hprd/z80-fpga-drop-in-replacement/README.md

# z80-fpga-drop-in-replacement
UT Austin Fall 2025-Spring 2026 Senior Design Project for developing a Zilog Z80 CPU drop-in replacement using an FPGA.

Relevant links and information from previous group's iteration:
- [Instruction Set](https://map.grauw.nl/resources/z80instr.php)
- [Z80 User Manual](https://www.zilog.com/docs/z80/um0080.pdf)
- [Master Reference Website](http://z80.info/)
- [Timing Quirks](https://floooh.github.io/2021/12/06/z80-instruction-timing.html#extra-clock-cycles)
