hprd/z80-fpga-drop-in-replacement/Z80_Drop_In_2026/Z80_Drop_In_2026.runs/impl_1/.init_design.begin.rst

<?xml version="1.0"?>
<ProcessHandle Version="1" Minor="0">
    <Process Command=".planAhead." Owner="user" Host="de310536375a" Pid="17683">
    </Process>
</ProcessHandle>
