hprd/z80-fpga-drop-in-replacement/Z80_Drop_In_2026/Z80_Drop_In_2026.runs/blk_mem_gen_0_synth_1/.vivado.begin.rst

<?xml version="1.0"?>
<ProcessHandle Version="1" Minor="0">
    <Process Command="vivado" Owner="user" Host="ff1013d0903a" Pid="958" HostCore="5" HostMemory="2987652">
    </Process>
</ProcessHandle>
