hprd/z80-fpga-drop-in-replacement/Z80_Drop_In_2026/Z80_Drop_In_2026.runs/impl_1/.write_bitstream.begin.rst

<?xml version="1.0"?>
<ProcessHandle Version="1" Minor="0">
    <Process Command=".planAhead." Owner="user" Host="4831159a8b64" Pid="1235">
    </Process>
</ProcessHandle>
