hprd/z80-fpga-drop-in-replacement/hardware/TC2030-IDC-NL.step

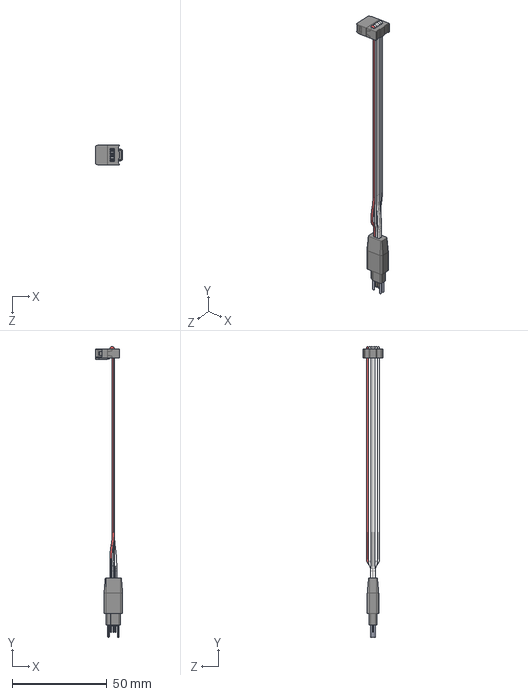
[picture p1: CAD file, 2026-02-06]
hardware/TC2030-IDC-NL.step
14.5 x 153.6 x 10.7 mm
