hprd/z80-fpga-drop-in-replacement/TesterBoard/Tester_Board_PCB_Parts/ACH_4_000MHZ_EK/ACH-4.000MHZ-EK.step

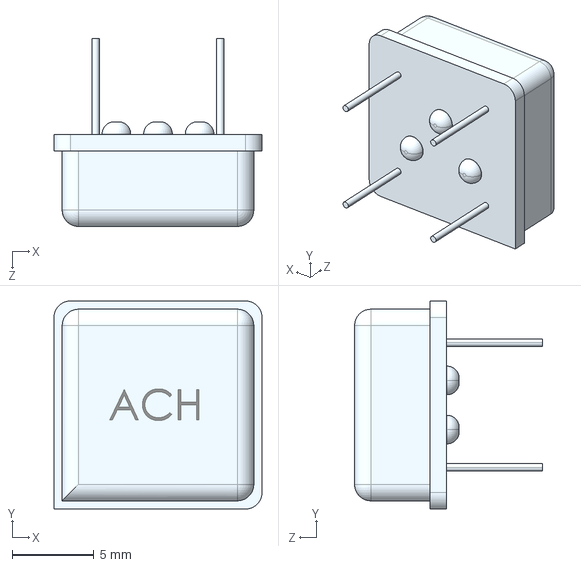
[picture p2: CAD file, 2026-03-05]
TesterBoard/Tester_Board_PCB_Parts/ACH_4_000MHZ_EK/ACH-4.000MHZ-EK.step
12.7 x 12.7 x 11.5 mm
