hprd/z80-fpga-drop-in-replacement/TesterBoard/Tester_Board_PCB_Parts/B3F-4050/B3F-4050.step

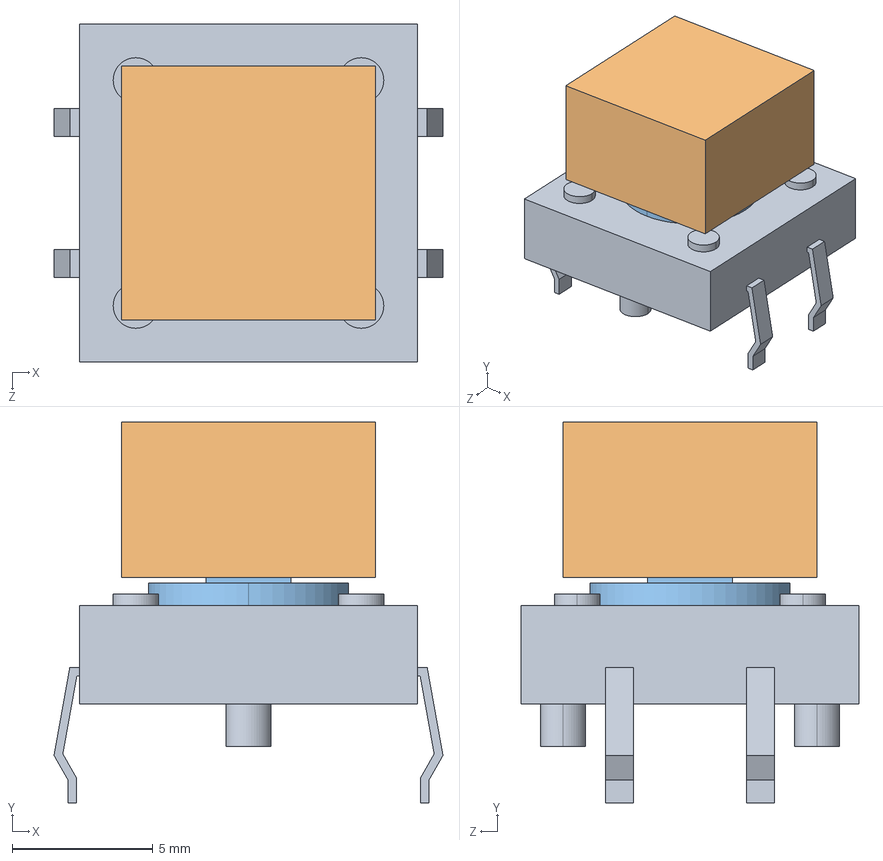
[picture p3: CAD file, 2026-03-07]
TesterBoard/Tester_Board_PCB_Parts/B3F-4050/B3F-4050.step
13.8 x 13.5 x 12.0 mm
B3F_4050_BASE
B32_1200
B3F_4050_BUTTON
