hprd/z80-fpga-drop-in-replacement/TesterBoard/Tester_Board_PCB_Parts/LCD-16X2/LCD-16X2.step

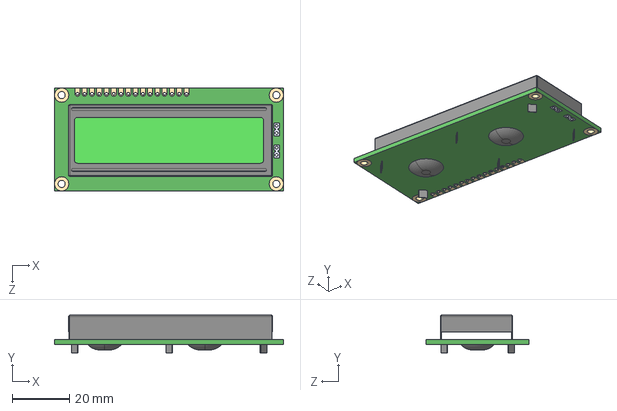
[picture p4: CAD file, 2026-03-07]
TesterBoard/Tester_Board_PCB_Parts/LCD-16X2/LCD-16X2.step
80.0 x 13.2 x 36.0 mm
