hprd/z80-fpga-drop-in-replacement/TesterBoard/Tester_Board_PCB_Parts/LIB_NHD-12864WG-BTMI-V#N/NHD-12864WG-BTMI-V#N/3D/NHD-12864WG-BTMI-V#N.stp

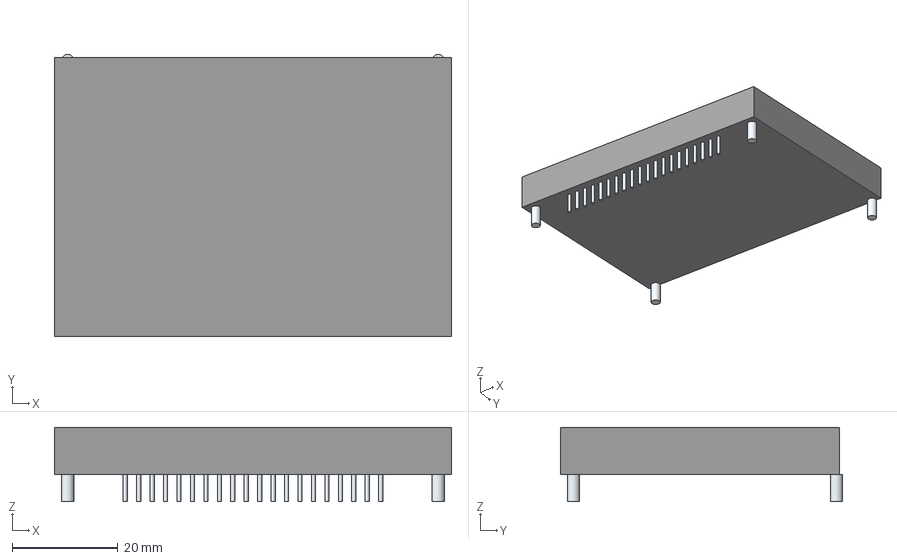
[picture p5: CAD file, 2026-03-07]
TesterBoard/Tester_Board_PCB_Parts/LIB_NHD-12864WG-BTMI-V#N/NHD-12864WG-BTMI-V#N/3D/NHD-12864WG-BTMI-V#N.stp
75.0 x 53.3 x 14.0 mm
Leads
