hprd/z80-fpga-drop-in-replacement/TesterBoard/Tester_Board_PCB_Parts/PJ_102A/PJ-102A.step

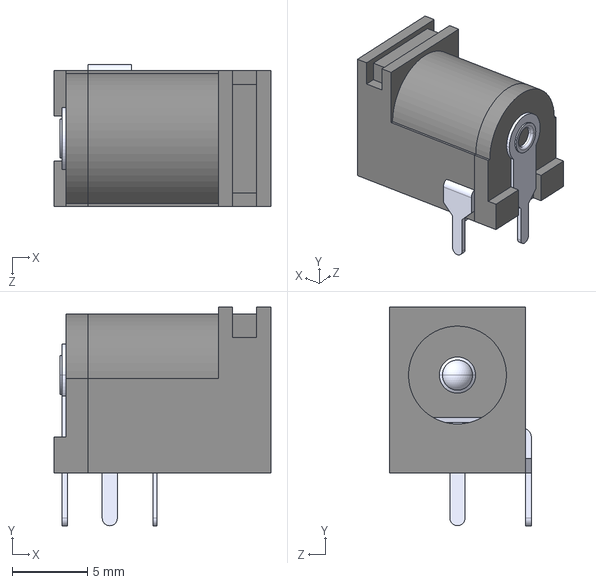
[picture p6: CAD file, 2026-03-07]
TesterBoard/Tester_Board_PCB_Parts/PJ_102A/PJ-102A.step
14.4 x 14.5 x 9.40 mm
