hprd/z80-fpga-drop-in-replacement/TesterBoard/Tester_Board_PCB_Parts/Potentiometer_3D.STEP

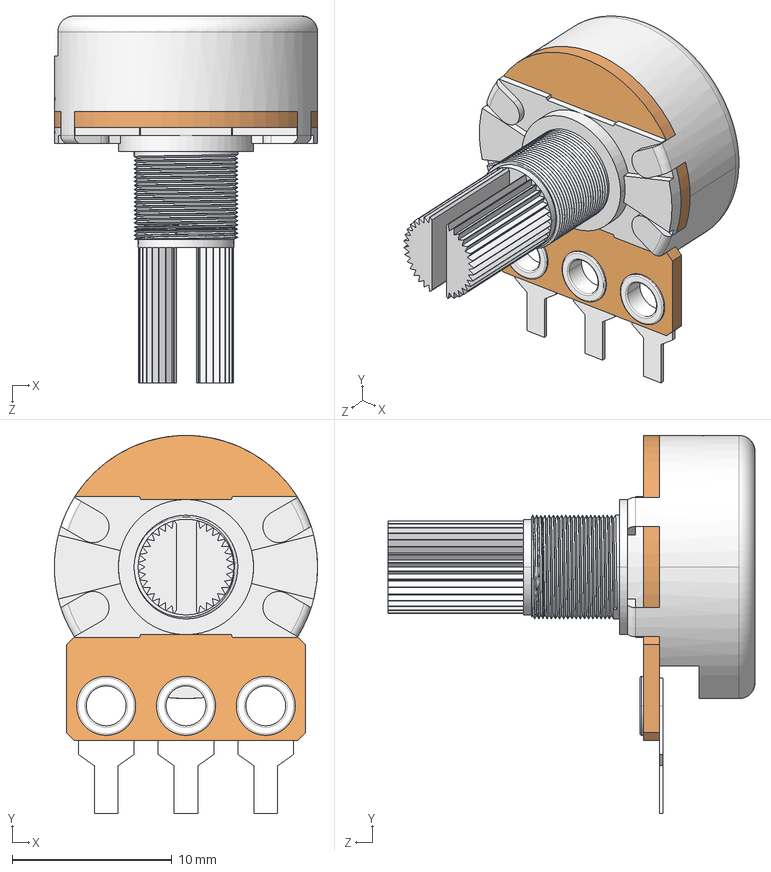
[picture p7: CAD file, 2026-03-09]
TesterBoard/Tester_Board_PCB_Parts/Potentiometer_3D.STEP
16.5 x 23.7 x 23.0 mm
