hprd/z80-fpga-drop-in-replacement/TesterBoard/Tester_Board_PCB_Parts/SN74LS14N/SN74LS14N.step

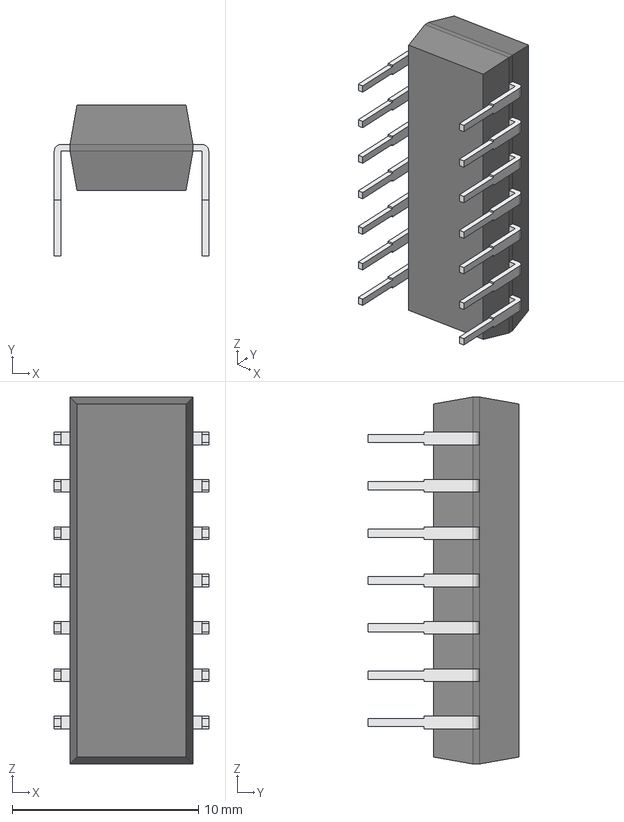
[picture p8: CAD file, 2026-03-05]
TesterBoard/Tester_Board_PCB_Parts/SN74LS14N/SN74LS14N.step
8.29 x 8.08 x 19.7 mm
Body001 (Mirror #1) x 8
