hprd/z80-fpga-drop-in-replacement/TesterBoard/Tester_Board_PCB_Parts/32pin_ZIF_3D.stp

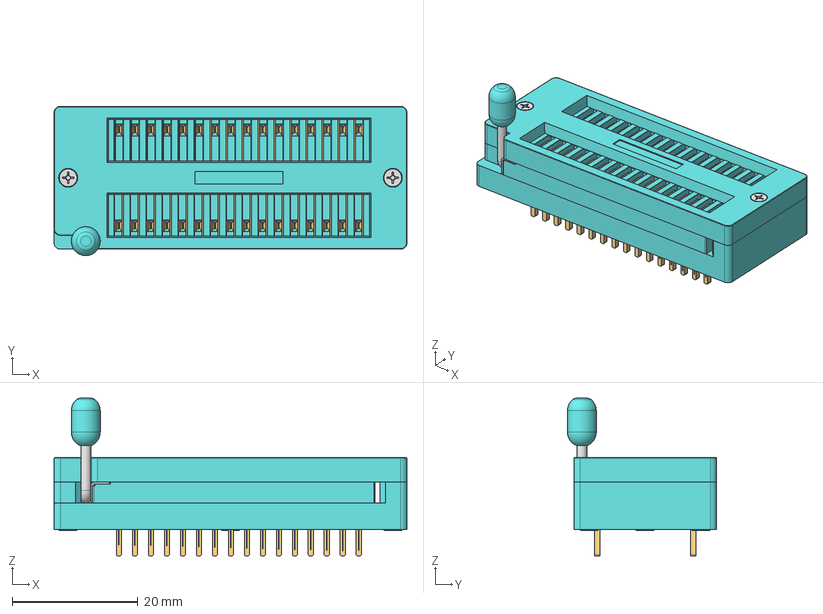
[picture p9: CAD file, 2026-03-09]
TesterBoard/Tester_Board_PCB_Parts/32pin_ZIF_3D.stp
56.1 x 23.7 x 25.1 mm
ZIF_32uni_bottom
ZIF_32uni_middle_body
ZIF_wide_middle_shield
ZIF_32uni_top
ZIF_handle_wide
ZIF_socket_handle_head
ZIF_socket_pin_uni x 32
M1.6-L8 x 2
