hprd/z80-fpga-drop-in-replacement/hardware/XC7S25-2CSGA225I.stp

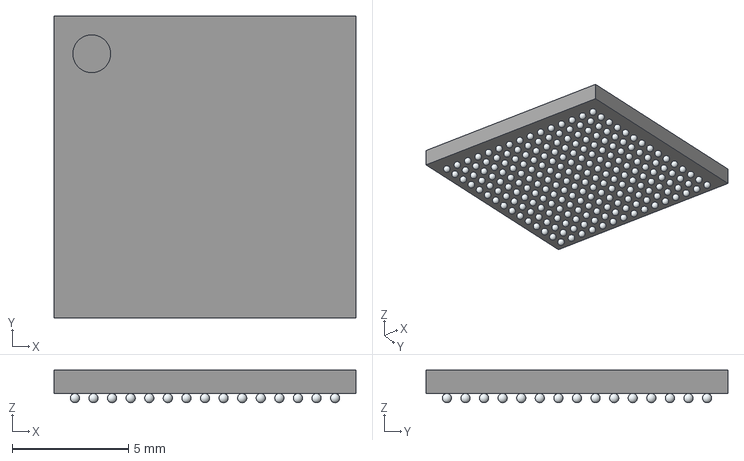
[picture p10: CAD file, 2026-02-06]
hardware/XC7S25-2CSGA225I.stp
13.0 x 13.0 x 1.40 mm
