hprd/z80-fpga-drop-in-replacement/TesterBoard/Tester_Board_PCB_Parts/40pin_ZIF_3D.STEP

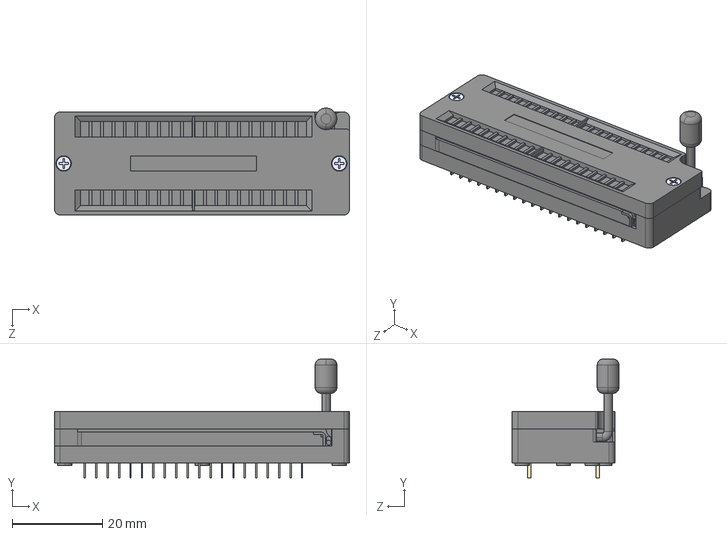
[picture p11: CAD file, 2026-03-09]
TesterBoard/Tester_Board_PCB_Parts/40pin_ZIF_3D.STEP
65.5 x 26.4 x 23.7 mm
