hprd/z80-fpga-drop-in-replacement/hardware/LTC3569EUDC#TRPBF.stp

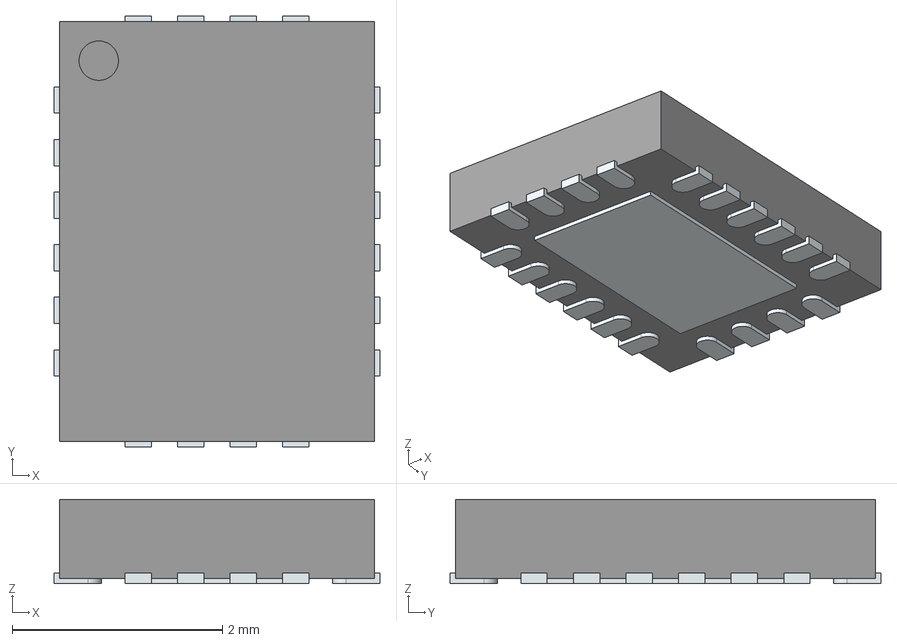
[picture p12: CAD file, 2026-02-06]
hardware/LTC3569EUDC#TRPBF.stp
3.10 x 4.10 x 0.8 mm
ThermalPin
PinsArrayLR
PinsArrayTB
