hprd/z80-fpga-drop-in-replacement/hardware/EVQ-P2R02W.stp

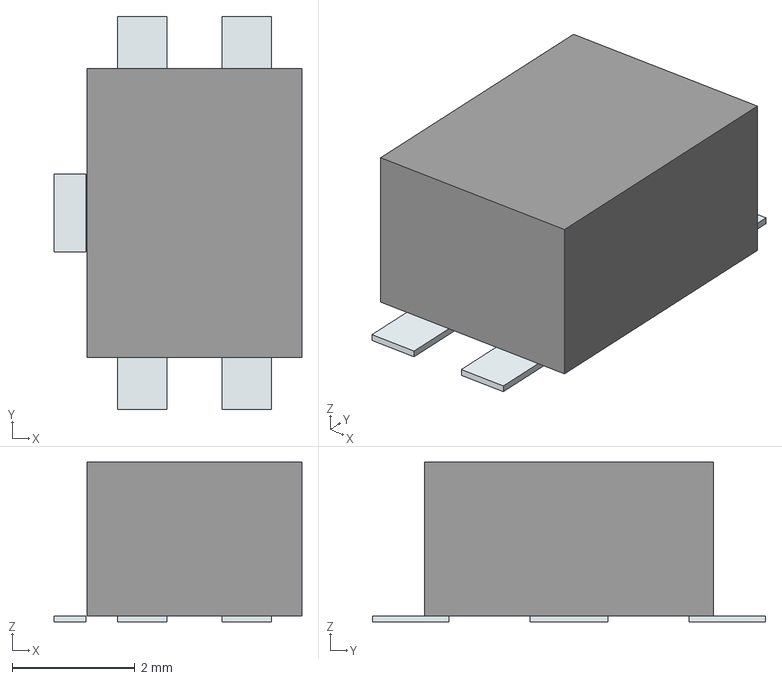
[picture p13: CAD file, 2026-02-06]
hardware/EVQ-P2R02W.stp
4.04 x 6.40 x 2.60 mm
Pins
