hprd/z80-fpga-drop-in-replacement/hardware/MT25QL512ABB1EW9-0SIT.stp

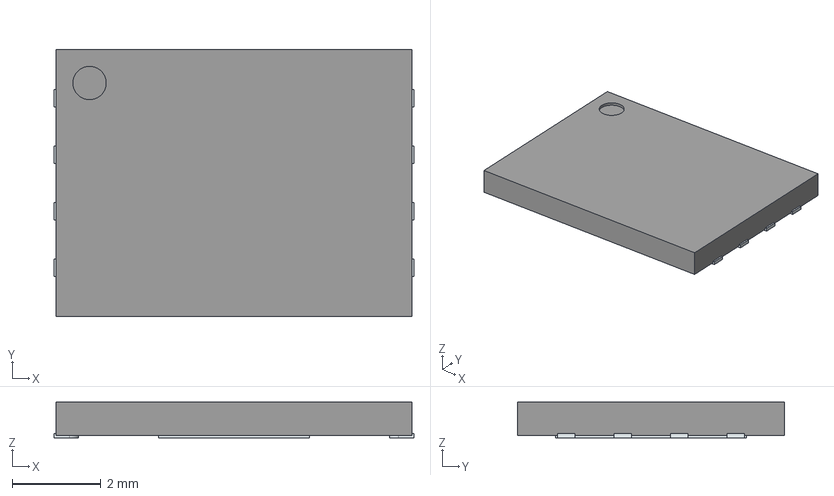
[picture p14: CAD file, 2026-02-06]
hardware/MT25QL512ABB1EW9-0SIT.stp
8.10 x 6.00 x 0.8 mm
ThermalPin
PinsArrayLR
