hprd/z80-fpga-drop-in-replacement/hardware/416131160803.stp

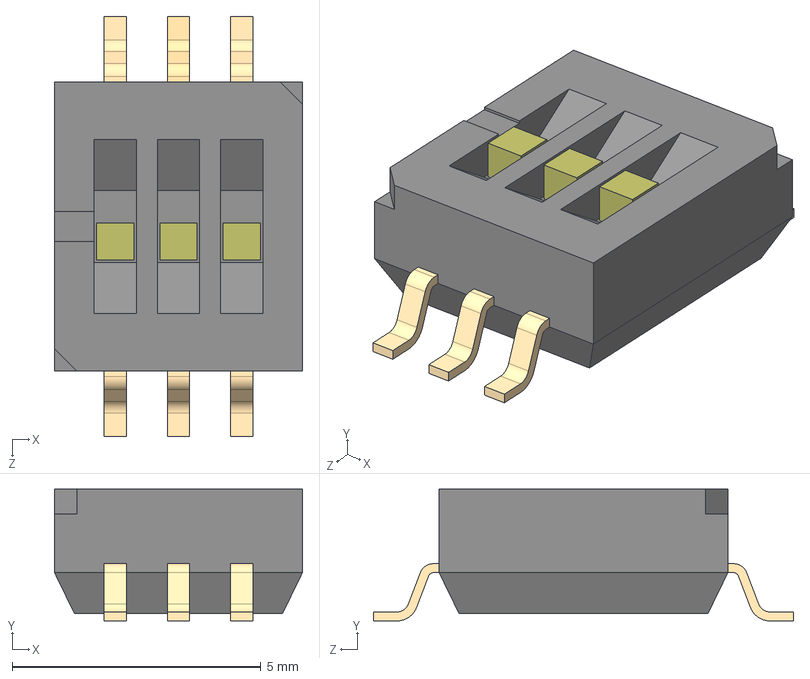
[picture p15: CAD file, 2026-02-06]
hardware/416131160803.stp
4.98 x 2.65 x 8.44 mm
