hprd/z80-fpga-drop-in-replacement/(list of files, cad)

Other CAD files:
TesterBoard/Tester_Board_PCB_Parts/LIB_NHD-12864WG-BTMI-V#N/NHD-12864WG-BTMI-V#N/Allegro/nhd12864wgbtmivn.psm
TesterBoard/Tester_Board_PCB_Parts/LIB_NHD-12864WG-BTMI-V#N/NHD-12864WG-BTMI-V#N/DEHDL/nhd_12864wg_btmi_v#n/chips/chips.prt
