hprd/z80-fpga-drop-in-replacement/(list of files, drawings)

Other design files:
hardware/level-shifter/freerouting.dsn
TesterBoard/Tester_Board_PCB_Parts/LIB_NHD-12864WG-BTMI-V#N/NHD-12864WG-BTMI-V#N/Altium/NHD12864WGBTMIVN.PcbLib
TesterBoard/Tester_Board_PCB_Parts/LIB_NHD-12864WG-BTMI-V#N/NHD-12864WG-BTMI-V#N/Altium/NHD-12864WG-BTMI-V#N.SchLib
