hprd/z80-fpga-drop-in-replacement/TesterBoard/Tester/Tester.kicad_pcb

## KiCad design TesterBoard/Tester/Tester.kicad_pcb (2026-03-28)

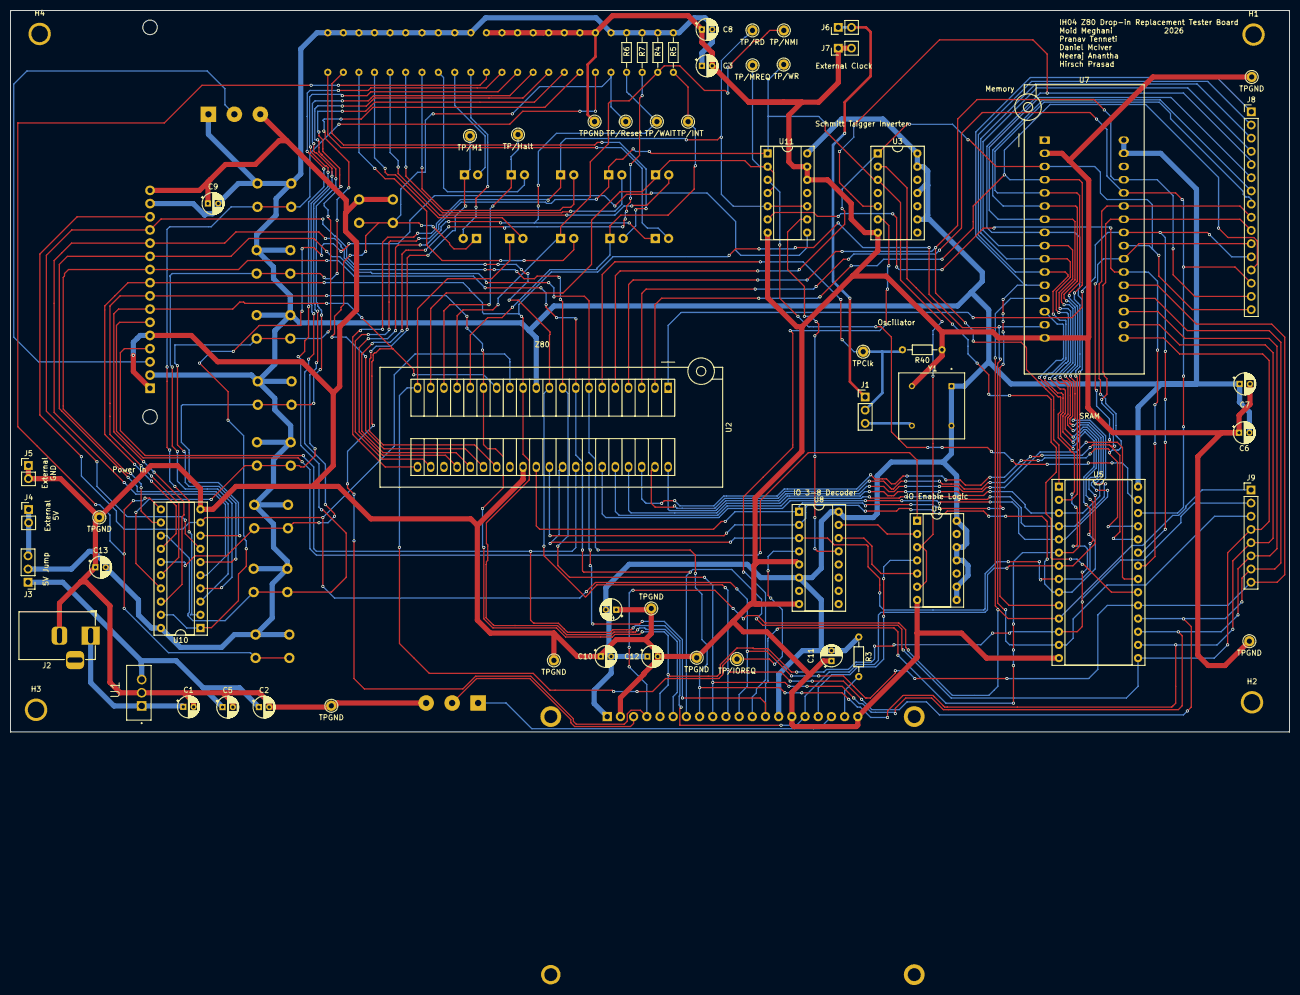
[picture p16: board Tester.kicad_pcb from above]

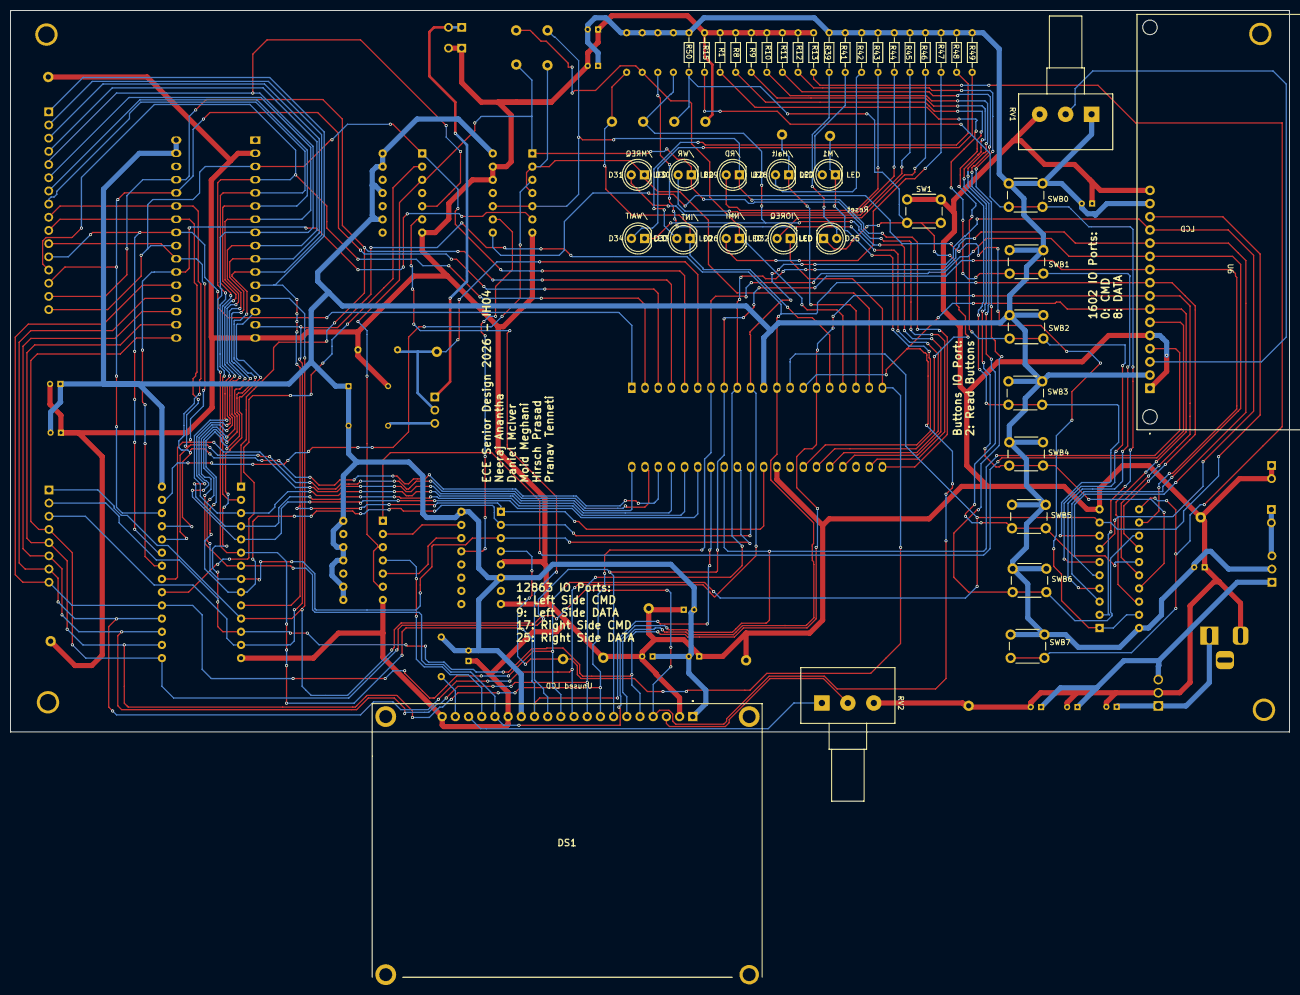
[picture p17: board Tester.kicad_pcb from below]

Board: 2 copper layers, 246.3 x 138.9 mm, 103 parts (42 on the bottom side), 75 nets.

Parts:
C1: 330nF; CP_Radial_D4.0mm_P2.00mm
C2, C3, C4, C6, C7, C8, C9, C10, C11, C12, C13: 100nF; CP_Radial_D4.0mm_P2.00mm
C5: 10uF; CP_Radial_D4.0mm_P2.00mm
D25, D26, D27, D28, D29, D30, D31, D32, D33, D34: LED; LED_D5.0mm
DS1: NHD-12864WG-BTMI-V#N; NHD12864WGBTMIVN
H1, H2, H3, H4: MountingHole_4_40
J1, J3: Conn_01x03_Pin; PinHeader_1x03_P2.54mm_Vertical
J2: PJ-102A; BarrelJack_Horizontal
J4, J5, J6, J7: Conn_01x02_Pin; PinHeader_1x02_P2.54mm_Vertical
J8: Conn_01x16_Pin; PinHeader_1x16_P2.54mm_Vertical
J9: Conn_01x08_Pin; PinHeader_1x08_P2.54mm_Vertical
R1, R8, R9, R10, R11, R12, R13, R15: 1k; R_Axial_DIN0204_L3.6mm_D1.6mm_P7.62mm_Horizontal
R3, R39, R40, R41, R42, R43, R44, R45, R46, R47, R48, R49, R50: 1K; R_Axial_DIN0204_L3.6mm_D1.6mm_P7.62mm_Horizontal
R4, R5, R6, R7: 10K; R_Axial_DIN0204_L3.6mm_D1.6mm_P7.62mm_Horizontal
RV1, RV2: R_Potentiometer; Potentiometer_Alps_RK163_Single_Horizontal
SW1: SW_Push; SW_PUSH_6mm
SWB0, SWB1, SWB2, SWB3, SWB4, SWB5, SWB6, SWB7: SW_Push; SW_PUSH_6mm
TP/Halt: TestPoint; Pin_D1.0mm_L10.0mm
TP/INT: TestPoint; Pin_D1.0mm_L10.0mm
TP/IOREQ: TestPoint; Pin_D1.0mm_L10.0mm
TP/M1: TestPoint; Pin_D1.0mm_L10.0mm
TP/MREQ: TestPoint; Pin_D1.0mm_L10.0mm
TP/NMI: TestPoint; Pin_D1.0mm_L10.0mm
TP/RD: TestPoint; Pin_D1.0mm_L10.0mm
TP/Reset: TestPoint; Pin_D1.0mm_L10.0mm
TP/WAIT: TestPoint; Pin_D1.0mm_L10.0mm
TP/WR: TestPoint; Pin_D1.0mm_L10.0mm
TPClk: TestPoint; Pin_D1.0mm_L10.0mm
TPGND: TestPoint; Pin_D1.0mm_L10.0mm
TPGND#2, TPGND#3, TPGND#4, TPGND#5, TPGND#6, TPGND#7, TPGND#8: TestPoint; Pin_D1.0mm_L10.0mm
U1: L7805; TO254P1054X470X2600-3
U2: Z80CPU; 3M_Textool_240-1288-00-0602J_2x20_P2.54mm
U3: 74LS14; DIP-14_W7.62mm_Socket
U4: 74LS02; DIP-14_W7.62mm_Socket
U5: CY62256-70PC; DIP-28_W15.24mm_Socket
U6: LCD-16X2; MODULE_LCD-16X2
U7: SST39SF010; DIP_Socket-32_W11.9_W12.7_W15.24_W17.78_W18.5_3M_232-1285-0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
U8: 74HC138; DIP-16_W7.62mm_Socket
U10: 74HC244; DIP-20_W7.62mm_Socket
U11: 74LS32; DIP-14_W7.62mm_Socket
Y1: ACH-4.000MHZ-EK; XTAL_ACH-4.000MHZ-EK

Connections:
1602_Enable: U4.1, U6.6 (E)
12864_Enable: DS1.17 (E), U4.4
12864_VEE: DS1.18 (VEE), RV2.1
+5V: C3.1, C4.2, C6.2, C7.1, C8.2, C9.2, C10.2, C11.2, C12.1, C13.2, DS1.1 (VDD), DS1.14 (~RST), J3.2, R3.1, R4.1, R5.2, R6.1, R7.1, R39.1, R41.1, R42.1, R43.1, R44.1, R45.1, R46.1, R47.1, R48.1, R49.1, R50.1, RV1.1, SWB0.1, SWB1.1, SWB2.1, SWB3.1, SWB4.1, SWB5.1, SWB6.1, SWB7.1, U2.11 (VCC), U3.9, U3.11, U3.13, U3.14 (VCC), U4.8, U4.9, U4.11, U4.12, U4.14 (VCC), U5.28 (VCC), U6.2 (VDD), U6.15 (A), U7.31 (PGM), U7.32 (VCC), U8.6 (E2), U8.16 (VCC), U10.20 (VCC), U11.14 (VCC), Y1.1 (TRI-STATE/NC), Y1.8 (VDD)
+9V: C1.1, J2.1, U1.1 (IN)
Address0: J8.1, U2.30 (A0), U5.10 (A0), U7.12 (A0), U8.1 (A0)
Address1: J8.2, U2.31 (A1), U5.9 (A1), U7.11 (A1), U8.2 (A1)
Address2: J8.3, U2.32 (A2), U5.8 (A2), U7.10 (A2), U8.3 (A2)
Address3: DS1.16 (D/~I), J8.4, U2.33 (A3), U5.7 (A3), U6.4 (RS), U7.9 (A3)
Address4: DS1.13 (CS2), J8.5, U2.34 (A4), U3.5, U5.6 (A4), U7.8 (A4)
Address5: J8.6, U2.35 (A5), U5.5 (A5), U7.7 (A5)
Address6: J8.7, U2.36 (A6), U5.4 (A6), U7.6 (A6)
Address7: J8.8, U2.37 (A7), U5.3 (A7), U7.5 (A7)
Address8: J8.9, U2.38 (A8), U5.25 (A8), U7.27 (A8)
Address9: J8.10, U2.39 (A9), U5.24 (A9), U7.26 (A9)
Address10: J8.11, U2.40 (A10), U5.21 (A10), U7.23 (A10)
Address11: J8.12, U2.1 (A11), U5.23 (A11), U7.25 (A11)
Address12: J8.13, U2.2 (A12), U5.2 (A12), U7.4 (A12)
Address13: J8.14, U2.3 (A13), U5.26 (A13), U7.28 (A13)
Address14: J8.15, U2.4 (A14), U5.1 (A14), U7.29 (A14)
Address15: J8.16, U2.5 (A15), U3.1, U7.3 (A15), U7.24 (OE)
B0: R15.2, SWB0.2, U10.2 (1A0)
B1: R1.2, SWB1.2, U10.4 (1A1)
B2: R8.2, SWB2.2, U10.6 (1A2)
B3: R9.2, SWB3.2, U10.8 (1A3)
B4: R10.2, SWB4.2, U10.17 (2A0)
B5: R11.2, SWB5.2, U10.15 (2A1)
B6: R12.2, SWB6.2, U10.13 (2A2)
B7: R13.2, SWB7.2, U10.11 (2A3)
Barrel_5V: C2.1, C5.1, J3.1, U1.3 (OUT)
Clk: J1.2, R40.2, TPClk.1, U2.6 (~CLK)
Data0: DS1.4 (DB0), J9.1, U2.14 (D0), U5.11 (Q0), U6.7 (DB0), U7.13 (D0), U10.18 (1Y0)
Data1: DS1.5 (DB1), J9.2, U2.15 (D1), U5.12 (Q1), U6.8 (DB1), U7.14 (D1), U10.16 (1Y1)
Data2: DS1.6 (DB2), J9.3, U2.12 (D2), U5.13 (Q2), U6.9 (DB2), U7.15 (D2), U10.14 (1Y2)
Data3: DS1.7 (DB3), J9.4, U2.8 (D3), U5.15 (Q3), U6.10 (DB3), U7.17 (D3), U10.12 (1Y3)
Data4: DS1.8 (DB4), J9.5, U2.7 (D4), U5.16 (Q4), U6.11 (DB4), U7.18 (D4), U10.3 (2Y0)
Data5: DS1.9 (DB5), J9.6, U2.9 (D5), U5.17 (Q5), U6.12 (DB5), U7.19 (D5), U10.5 (2Y1)
Data6: DS1.10 (DB6), J9.7, U2.10 (D6), U5.18 (Q6), U6.13 (DB6), U7.20 (D6), U10.7 (2Y2)
Data7: DS1.11 (DB7), J9.8, U2.13 (D7), U5.19 (Q7), U6.14 (DB7), U7.21 (D7), U10.9 (2Y3)
EXTERNAL_CLOCK: J1.1, J6.1, J6.2
Ext_5V: J3.3, J4.1, J4.2
GND: C1.2, C2.2, C3.2, C4.1, C5.2, C6.1, C7.2, C8.1, C9.1, C10.1, C11.1, C12.2, C13.1, DS1.2 (VSS), DS1.15 (R/~W), DS1.20 (K), J2.2, J5.1, J5.2, J7.1, J7.2, R1.1, R8.1, R9.1, R10.1, R11.1, R12.1, R13.1, R15.1, R40.1, RV1.3, RV2.3, SW1.1, TPGND.1, TPGND#2.1, TPGND#3.1, TPGND#4.1, TPGND#5.1, TPGND#6.1, TPGND#7.1, TPGND#8.1, U1.2 (GND), U2.29 (GND), U3.7 (GND), U4.7 (GND), U5.14 (GND), U6.1 (VSS), U6.5 (R/W), U6.16 (K), U7.2 (A16), U7.16 (GND), U8.5 (~E1), U8.8 (GND), U10.10 (GND), U11.7 (GND), U11.12, U11.13, Y1.4 (CASE_GND)
unnamed: D25.2 (A), R39.2
unnamed: D26.2 (A), R47.2
unnamed: D27.2 (A), R41.2
unnamed: D28.2 (A), R42.2
unnamed: D29.2 (A), R43.2
unnamed: D30.2 (A), R44.2
unnamed: D31.2 (A), R45.2
unnamed: D32.2 (A), R46.2
unnamed: D33.2 (A), R48.2
unnamed: D34.2 (A), R49.2
unnamed: DS1.19 (A), R3.2
unnamed: DS1.3 (V0), RV2.2
unnamed: R7.2, U2.25 (~BUSRQ)
unnamed: U3.2, U5.20 (~CS)
unnamed: U5.22 (~OE), U7.22 (CE), U11.6
unnamed: U5.27 (~WE), U11.3
unnamed: RV1.2, U6.3 (VO)
OSC_CLOCK: J1.3, Y1.5 (OUTPUT)
/1602_Select: U4.2, U8.15 (~Y0)
/12864_Select: U4.5, U8.14 (~Y1)
/Address4: DS1.12 (CS1), U3.6
/Buttons_Enable: U10.1 (1OE), U10.19 (2OE), U11.8
/Buttons_Select: U8.13 (~Y2), U11.9
/Halt: D28.1 (K), TP/Halt.1, U2.18 (~HALT)
/INT: D33.1 (K), R5.1, TP/INT.1, U2.16 (~INT)
/IOREQ: D32.1 (K), TP/IOREQ.1, U2.20 (~IORQ), U8.4 (~E0)
/M1: D27.1 (K), TP/M1.1, U2.27 (~M1)
/MREQ: D31.1 (K), TP/MREQ.1, U2.19 (~MREQ), U11.2, U11.4
/NMI: D26.1 (K), R4.2, TP/NMI.1, U2.17 (~NMI)
/RD: D29.1 (K), TP/RD.1, U2.21 (~RD), U11.5, U11.10
/Reset: D25.1 (K), R50.2, SW1.2, TP/Reset.1, U2.26 (~RESET)
/WAIT: D34.1 (K), R6.2, TP/WAIT.1, U2.24 (~WAIT)
/WR: D30.1 (K), TP/WR.1, U2.22 (~WR), U3.3, U4.3, U4.6, U11.1
