hprd/z80-fpga-drop-in-replacement/hardware/level-shifter/level-shifter.kicad_pcb

## KiCad design hardware/level-shifter/level-shifter.kicad_pcb (2026-03-05)

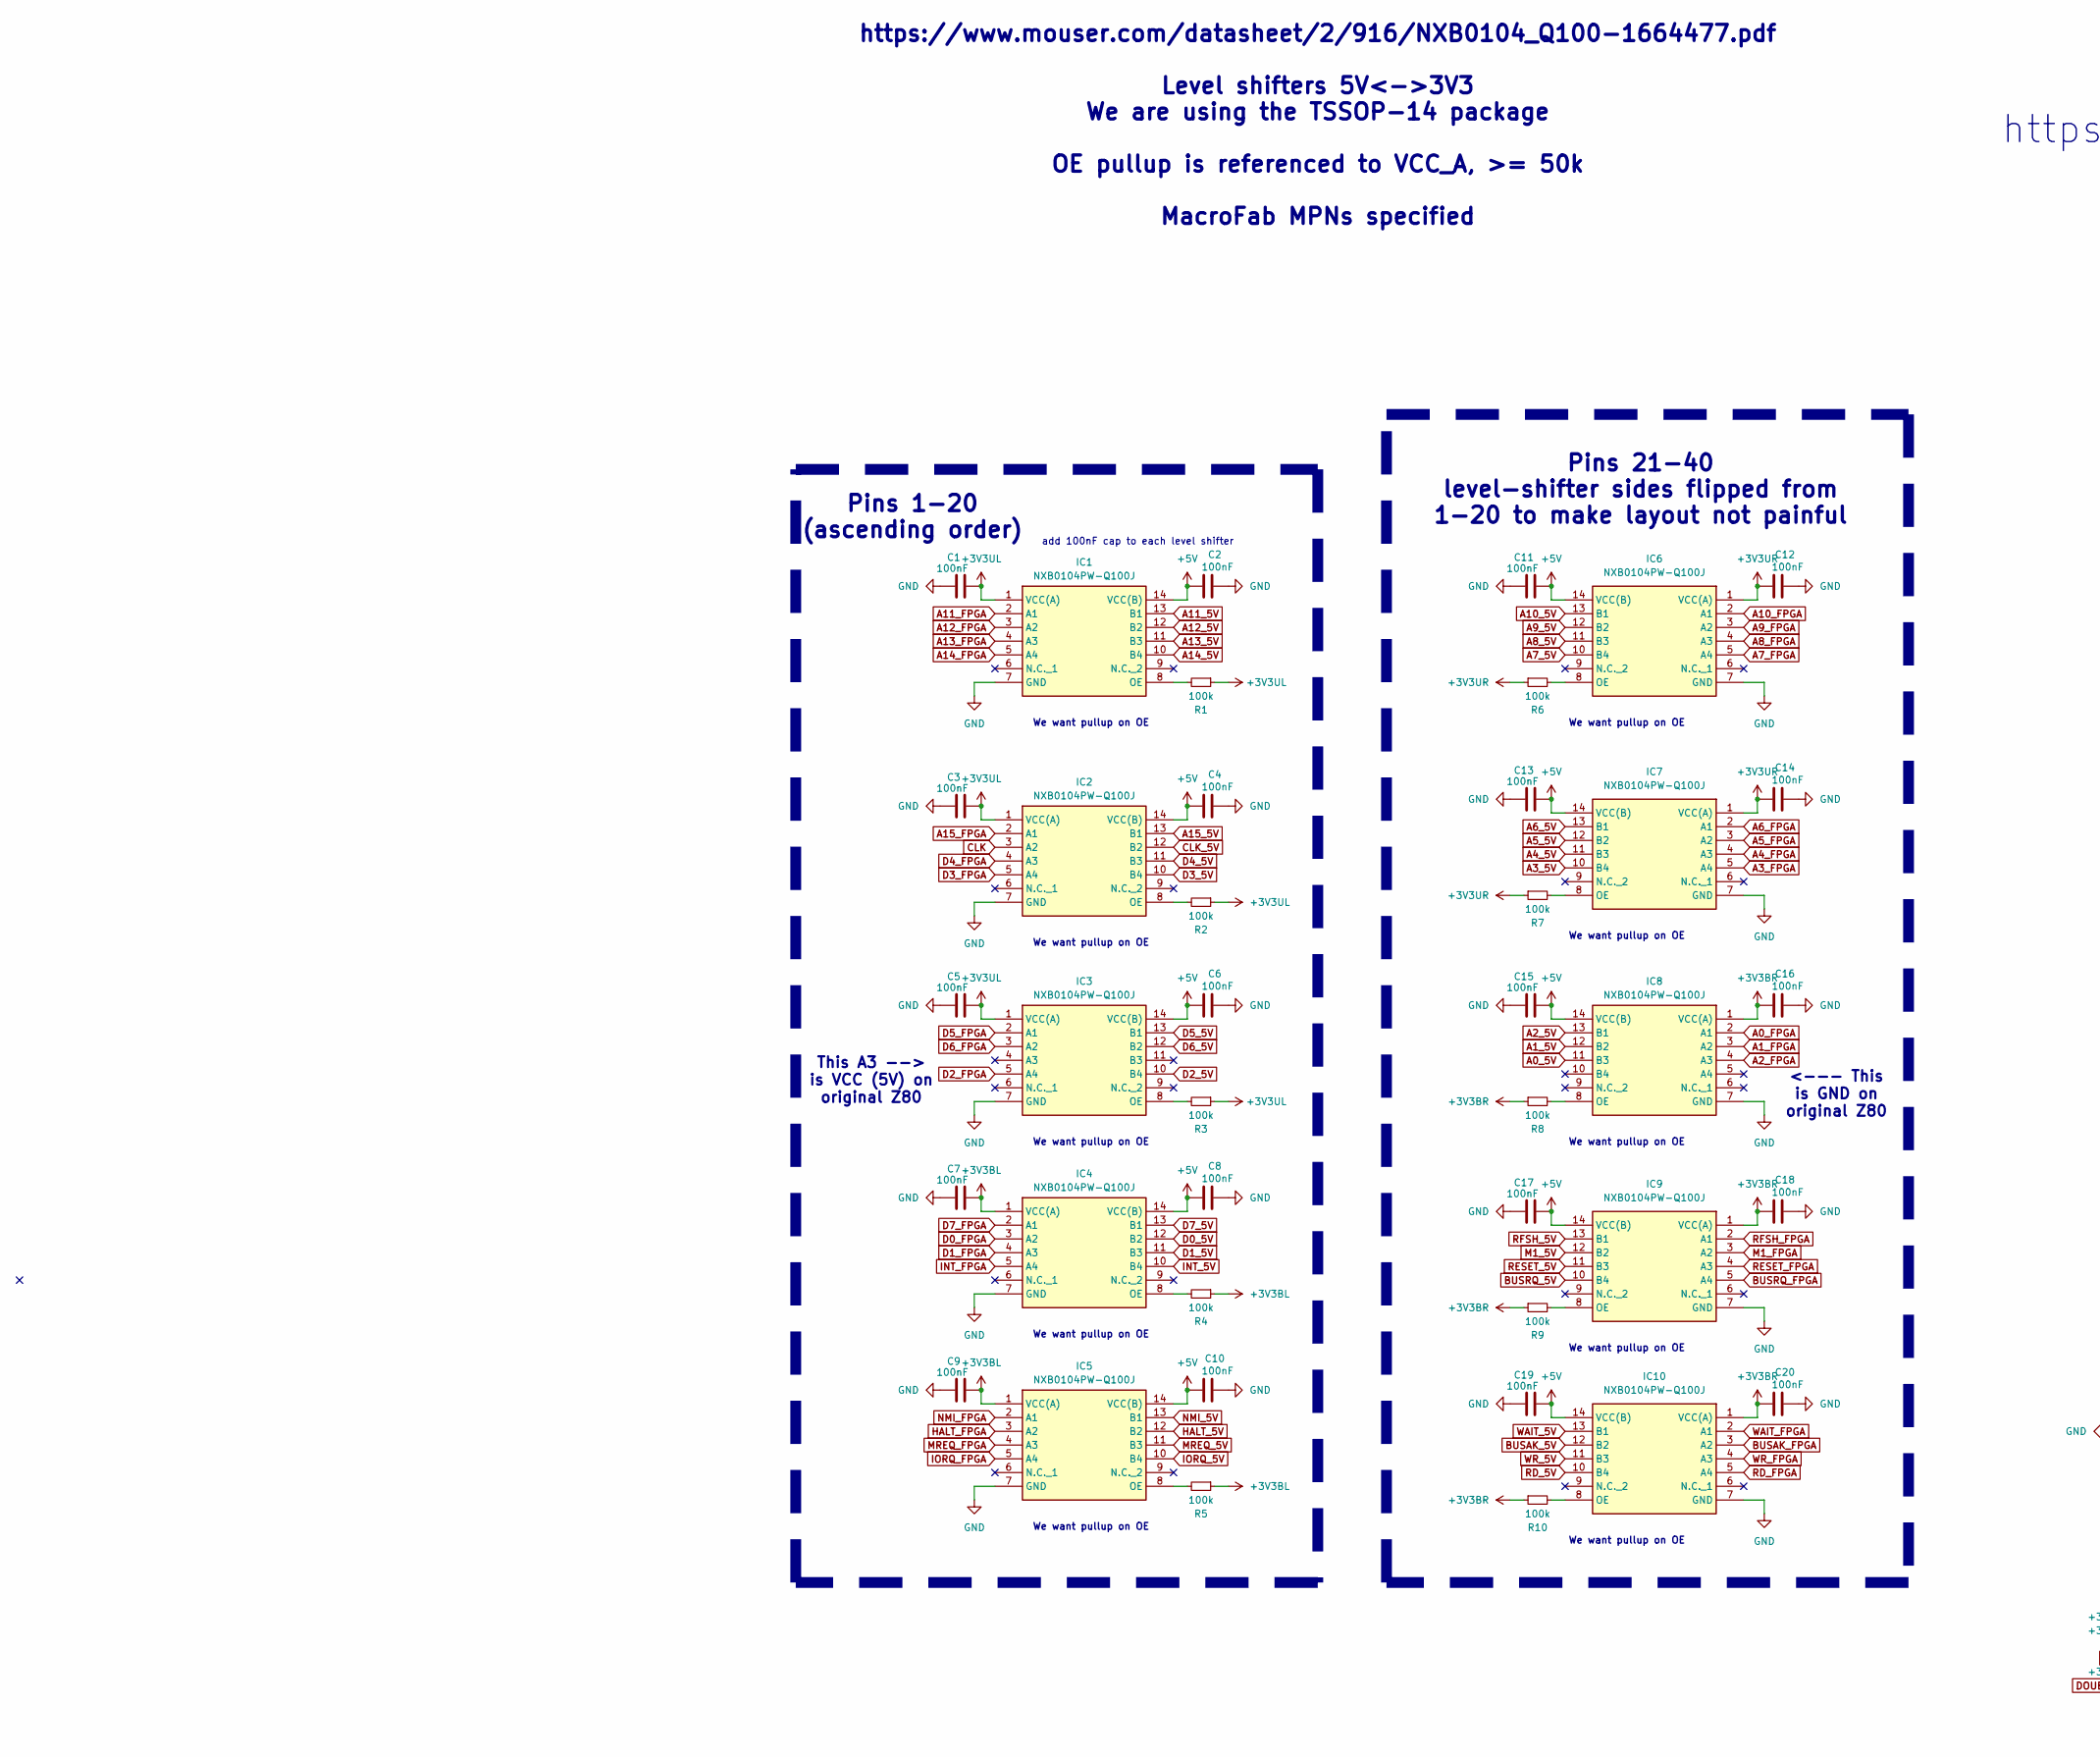
[picture p18: schematic level-shifter.kicad_sch, Z80 FPGA Board, part in row 1, column 1]

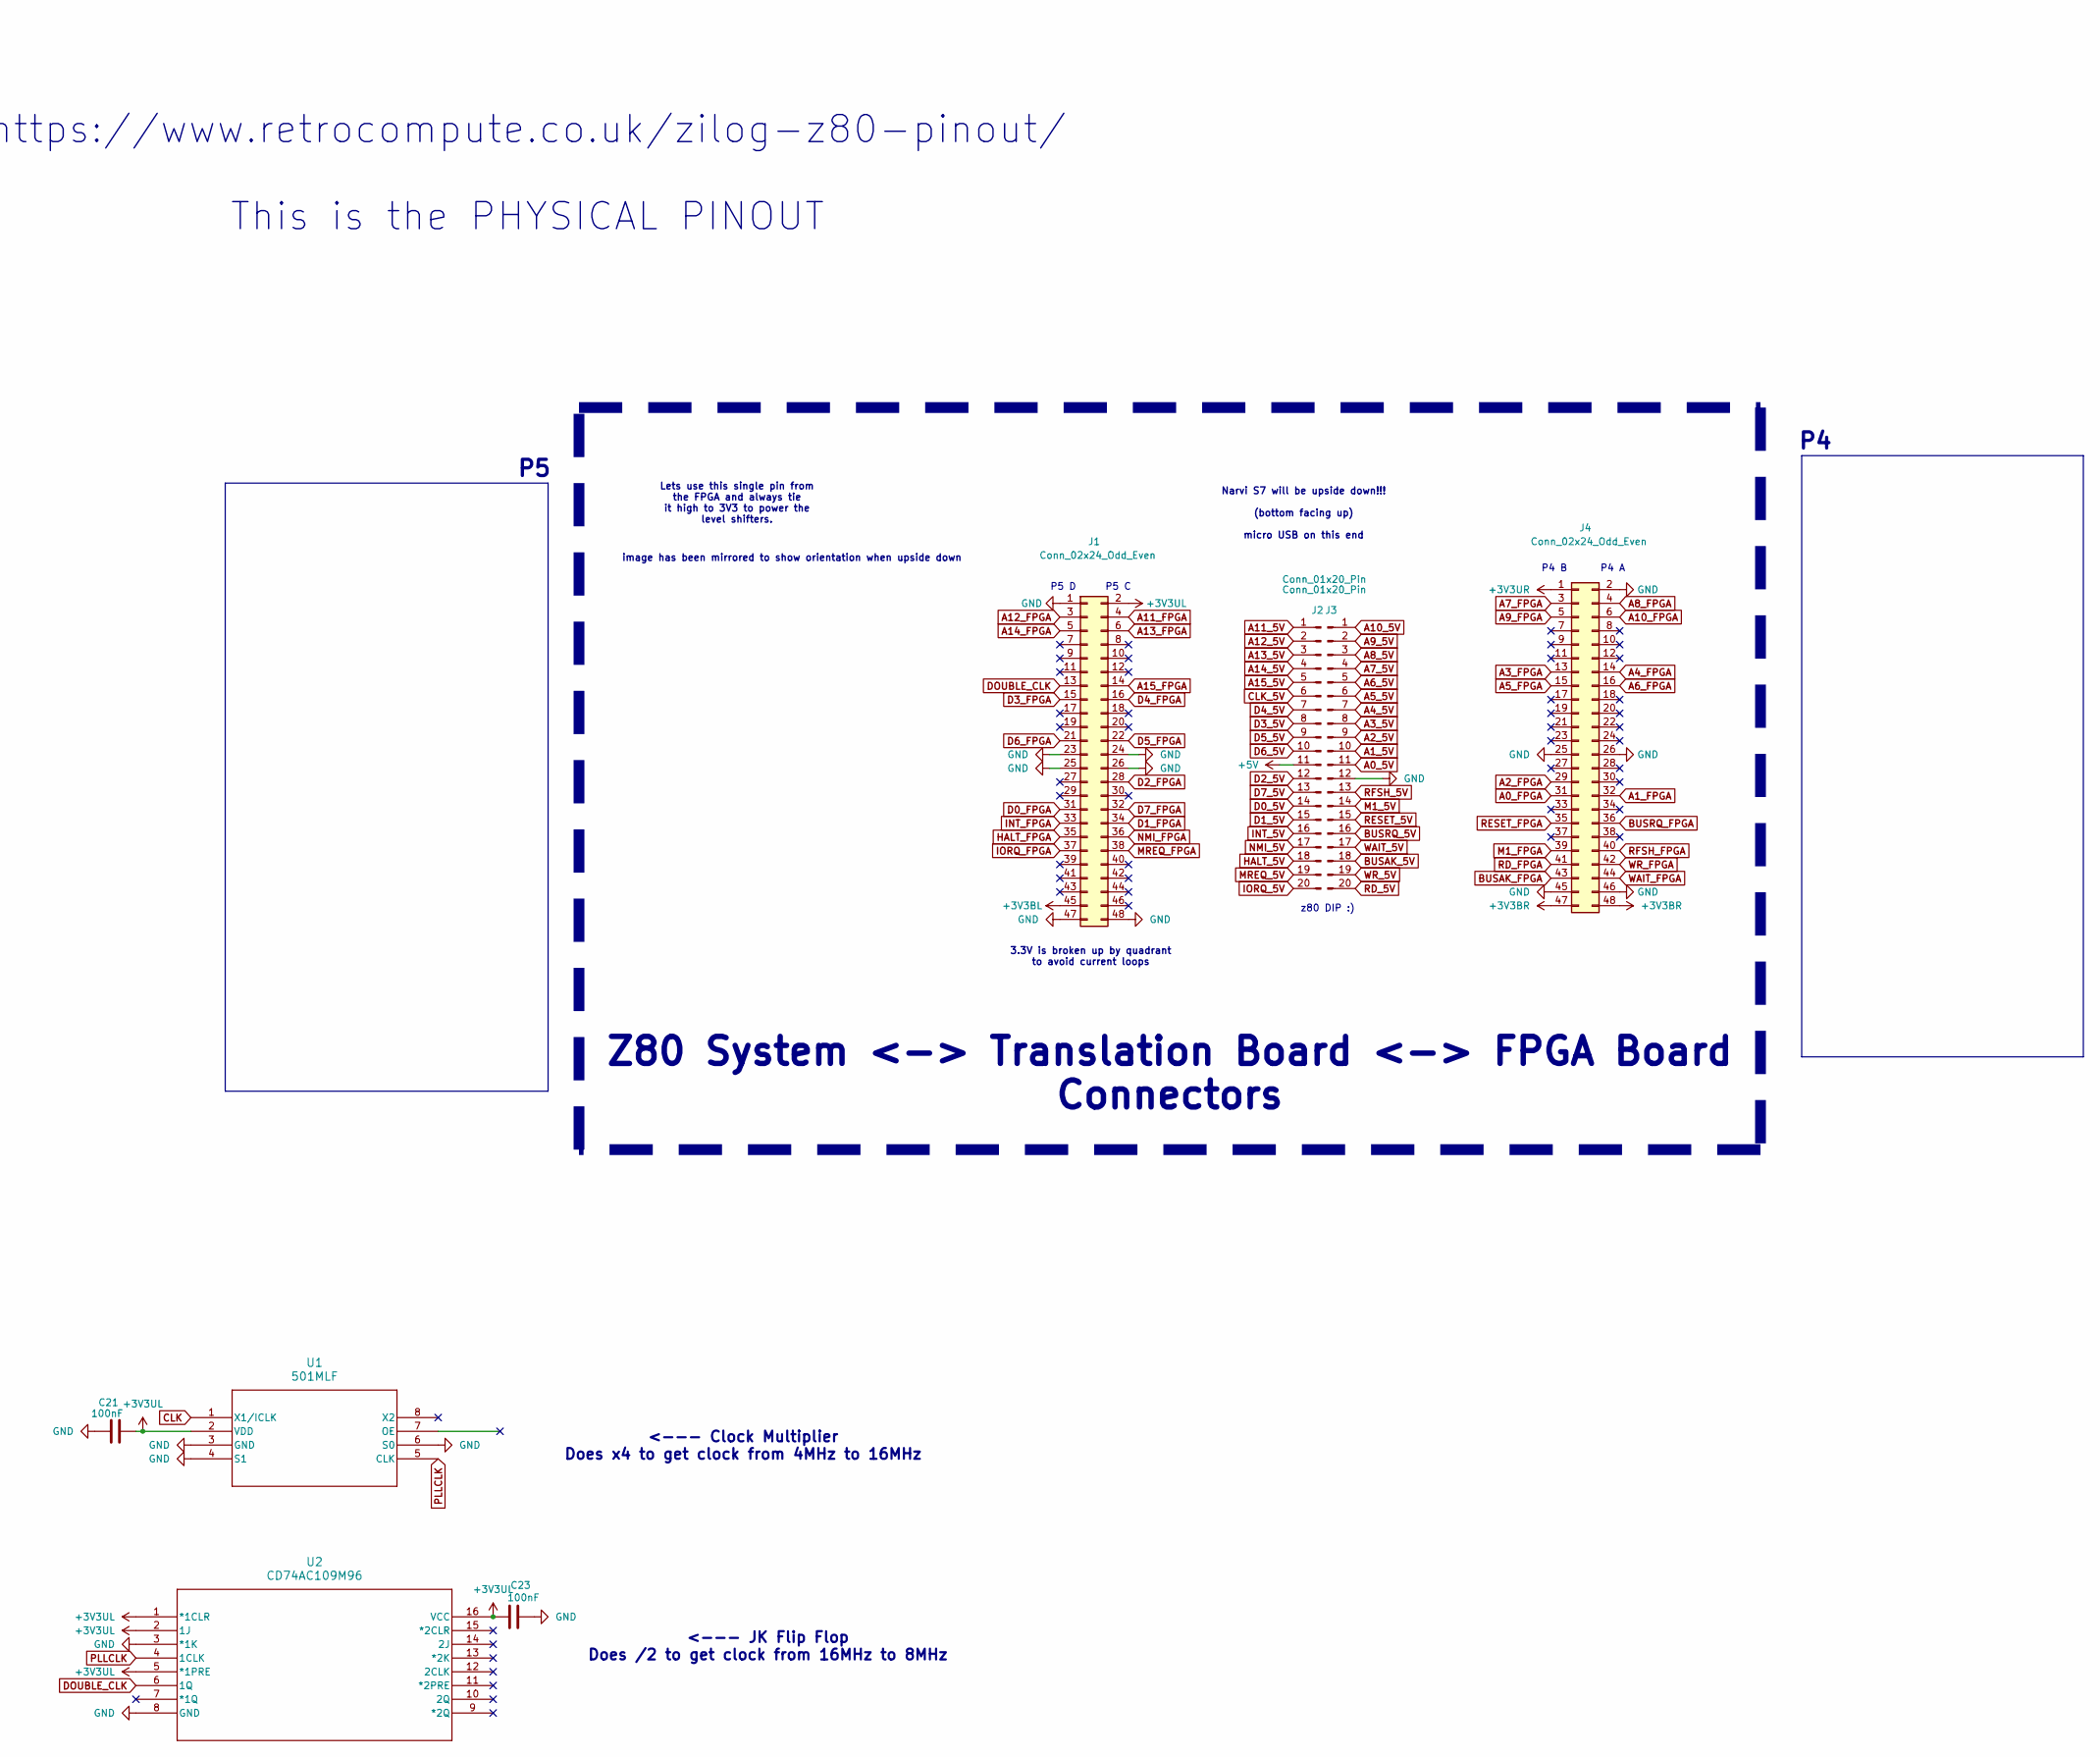
[picture p19: schematic level-shifter.kicad_sch, Z80 FPGA Board, part in row 1, column 2]

Parts:
C1, C2, C3, C4, C5, C6, C7, C8, C9, C10, C11, C12, C13, C14, C15, C16, C17, C18, C19, C20, C21, C23: 100nF; C_0805_2012Metric
IC1, IC2, IC3, IC4, IC5, IC6, IC7, IC8, IC9, IC10: NXB0104PW-Q100J; SOP65P640X110-14N; Mouser Part Number 771-NXB0104PW-Q100J
J1, J4: Conn_02x24_Odd_Even; PinHeader_2x24_P2.54mm_Vertical
J2, J3: Conn_01x20_Pin; PinHeader_1x20_P2.54mm_Vertical
R1, R2, R3, R4, R5, R6, R7, R8, R9, R10: 100k; R_0805_2012Metric; MPN ERJ-UP6D6202V
U1: 501MLF; SOIC8_DCG8D1_REN
U2: CD74AC109M96

Connections:
+3V3BL: C7.2, C9.2, IC4.1 (VCC(A)), IC5.1 (VCC(A)), J1.45, R4.1, R5.1
+3V3BR: C16.1, C18.1, C20.1, IC8.1 (VCC(A)), IC9.1 (VCC(A)), IC10.1 (VCC(A)), J4.47, J4.48, R8.1, R9.1, R10.1
+3V3UL: C1.2, C3.2, C5.2, C21.2, C23.1, IC1.1 (VCC(A)), IC2.1 (VCC(A)), IC3.1 (VCC(A)), J1.2, R1.1, R2.1, R3.1, U1.2 (VDD), U2.1 (*1CLR), U2.2 (1J), U2.5 (*1PRE), U2.16 (VCC)
+3V3UR: C12.1, C14.1, IC6.1 (VCC(A)), IC7.1 (VCC(A)), J4.1, R6.1, R7.1
+5V: C2.1, C4.1, C6.1, C8.1, C10.1, C11.2, C13.2, C15.2, C17.2, C19.2, IC1.14 (VCC(B)), IC2.14 (VCC(B)), IC3.14 (VCC(B)), IC4.14 (VCC(B)), IC5.14 (VCC(B)), IC6.14 (VCC(B)), IC7.14 (VCC(B)), IC8.14 (VCC(B)), IC9.14 (VCC(B)), IC10.14 (VCC(B)), J2.11
A0_5V: IC8.11 (B3), J3.11
A0_FPGA: IC8.2 (A1), J4.31
A1_5V: IC8.12 (B2), J3.10
A1_FPGA: IC8.3 (A2), J4.32
A2_5V: IC8.13 (B1), J3.9
A2_FPGA: IC8.4 (A3), J4.29
A3_5V: IC7.10 (B4), J3.8
A3_FPGA: IC7.5 (A4), J4.13
A4_5V: IC7.11 (B3), J3.7
A4_FPGA: IC7.4 (A3), J4.14
A5_5V: IC7.12 (B2), J3.6
A5_FPGA: IC7.3 (A2), J4.15
A6_5V: IC7.13 (B1), J3.5
A6_FPGA: IC7.2 (A1), J4.16
A7_5V: IC6.10 (B4), J3.4
A7_FPGA: IC6.5 (A4), J4.3
A8_5V: IC6.11 (B3), J3.3
A8_FPGA: IC6.4 (A3), J4.4
A9_5V: IC6.12 (B2), J3.2
A9_FPGA: IC6.3 (A2), J4.5
A10_5V: IC6.13 (B1), J3.1
A10_FPGA: IC6.2 (A1), J4.6
A11_5V: IC1.13 (B1), J2.1
A11_FPGA: IC1.2 (A1), J1.4
A12_5V: IC1.12 (B2), J2.2
A12_FPGA: IC1.3 (A2), J1.3
A13_5V: IC1.11 (B3), J2.3
A13_FPGA: IC1.4 (A3), J1.6
A14_5V: IC1.10 (B4), J2.4
A14_FPGA: IC1.5 (A4), J1.5
A15_5V: IC2.13 (B1), J2.5
A15_FPGA: IC2.2 (A1), J1.14
BUSAK_5V: IC10.12 (B2), J3.18
BUSAK_FPGA: IC10.3 (A2), J4.43
BUSRQ_5V: IC9.10 (B4), J3.16
BUSRQ_FPGA: IC9.5 (A4), J4.36
CLK: IC2.3 (A2), U1.1 (X1/ICLK)
CLK_5V: IC2.12 (B2), J2.6
D0_5V: IC4.12 (B2), J2.14
D0_FPGA: IC4.3 (A2), J1.31
D1_5V: IC4.11 (B3), J2.15
D1_FPGA: IC4.4 (A3), J1.34
D2_5V: IC3.10 (B4), J2.12
D2_FPGA: IC3.5 (A4), J1.28
D3_5V: IC2.10 (B4), J2.8
D3_FPGA: IC2.5 (A4), J1.15
D4_5V: IC2.11 (B3), J2.7
D4_FPGA: IC2.4 (A3), J1.16
D5_5V: IC3.13 (B1), J2.9
D5_FPGA: IC3.2 (A1), J1.22
D6_5V: IC3.12 (B2), J2.10
D6_FPGA: IC3.3 (A2), J1.21
D7_5V: IC4.13 (B1), J2.13
D7_FPGA: IC4.2 (A1), J1.32
DOUBLE_CLK: J1.13, U2.6 (1Q)
GND: C1.1, C2.2, C3.1, C4.2, C5.1, C6.2, C7.1, C8.2, C9.1, C10.2, C11.1, C12.2, C13.1, C14.2, C15.1, C16.2, C17.1, C18.2, C19.1, C20.2, C21.1, C23.2, IC1.7 (GND), IC2.7 (GND), IC3.7 (GND), IC4.7 (GND), IC5.7 (GND), IC6.7 (GND), IC7.7 (GND), IC8.7 (GND), IC9.7 (GND), IC10.7 (GND), J1.1, J1.23, J1.24, J1.25, J1.26, J1.47, J1.48, J3.12, J4.2, J4.25, J4.26, J4.45, J4.46, U1.3 (GND), U1.4 (S1), U1.6 (S0), U2.3 (*1K), U2.8 (GND)
HALT_5V: IC5.12 (B2), J2.18
HALT_FPGA: IC5.3 (A2), J1.35
INT_5V: IC4.10 (B4), J2.16
INT_FPGA: IC4.5 (A4), J1.33
IORQ_5V: IC5.10 (B4), J2.20
IORQ_FPGA: IC5.5 (A4), J1.37
M1_5V: IC9.12 (B2), J3.14
M1_FPGA: IC9.3 (A2), J4.39
MREQ_5V: IC5.11 (B3), J2.19
MREQ_FPGA: IC5.4 (A3), J1.38
NMI_5V: IC5.13 (B1), J2.17
NMI_FPGA: IC5.2 (A1), J1.36
unnamed: IC1.8 (OE), R1.2
unnamed: IC2.8 (OE), R2.2
unnamed: IC3.8 (OE), R3.2
unnamed: IC4.8 (OE), R4.2
unnamed: IC5.8 (OE), R5.2
unnamed: IC6.8 (OE), R6.2
unnamed: IC7.8 (OE), R7.2
unnamed: IC8.8 (OE), R8.2
unnamed: IC9.8 (OE), R9.2
unnamed: IC10.8 (OE), R10.2
PLLCLK: U1.5 (CLK), U2.4 (1CLK)
RD_5V: IC10.10 (B4), J3.20
RD_FPGA: IC10.5 (A4), J4.41
RESET_5V: IC9.11 (B3), J3.15
RESET_FPGA: IC9.4 (A3), J4.35
RFSH_5V: IC9.13 (B1), J3.13
RFSH_FPGA: IC9.2 (A1), J4.40
WAIT_5V: IC10.13 (B1), J3.17
WAIT_FPGA: IC10.2 (A1), J4.44
WR_5V: IC10.11 (B3), J3.19
WR_FPGA: IC10.4 (A3), J4.42

Notes on the sheet:
https://www.retrocompute.co.uk/zilog-z80-pinout/ This is the PHYSICAL PINOUT
We want pullup on OE
P4 A
P5 C
Z80 System <-> Translation Board <-> FPGA Board Connectors
<--- JK Flip Flop Does /2 to get clock from 16MHz to 8MHz
P5 D
Pins 21-40 level-shifter sides flipped from 1-20 to make layout not painful
z80 DIP :)
3.3V is broken up by quadrant to avoid current loops
image has been mirrored to show orientation when upside down
Narvi S7 will be upside down!!! (bottom facing up) micro USB on this end
<--- Clock Multiplier Does x4 to get clock from 4MHz to 16MHz
https://www.mouser.com/datasheet/2/916/NXB0104_Q100-1664477.pdf Level shifters 5V<->3V3 We are using the TSSOP-14 package OE pullup is referenced to VCC_A, >= 50k MacroFab MPNs specified
add 100nF cap to each level shifter
This A3 --> is VCC (5V) on original Z80
Lets use this single pin from the FPGA and always tie it high to 3V3 to power the level shifters.
<--- This is GND on original Z80
P4 B
Pins 1-20 (ascending order)

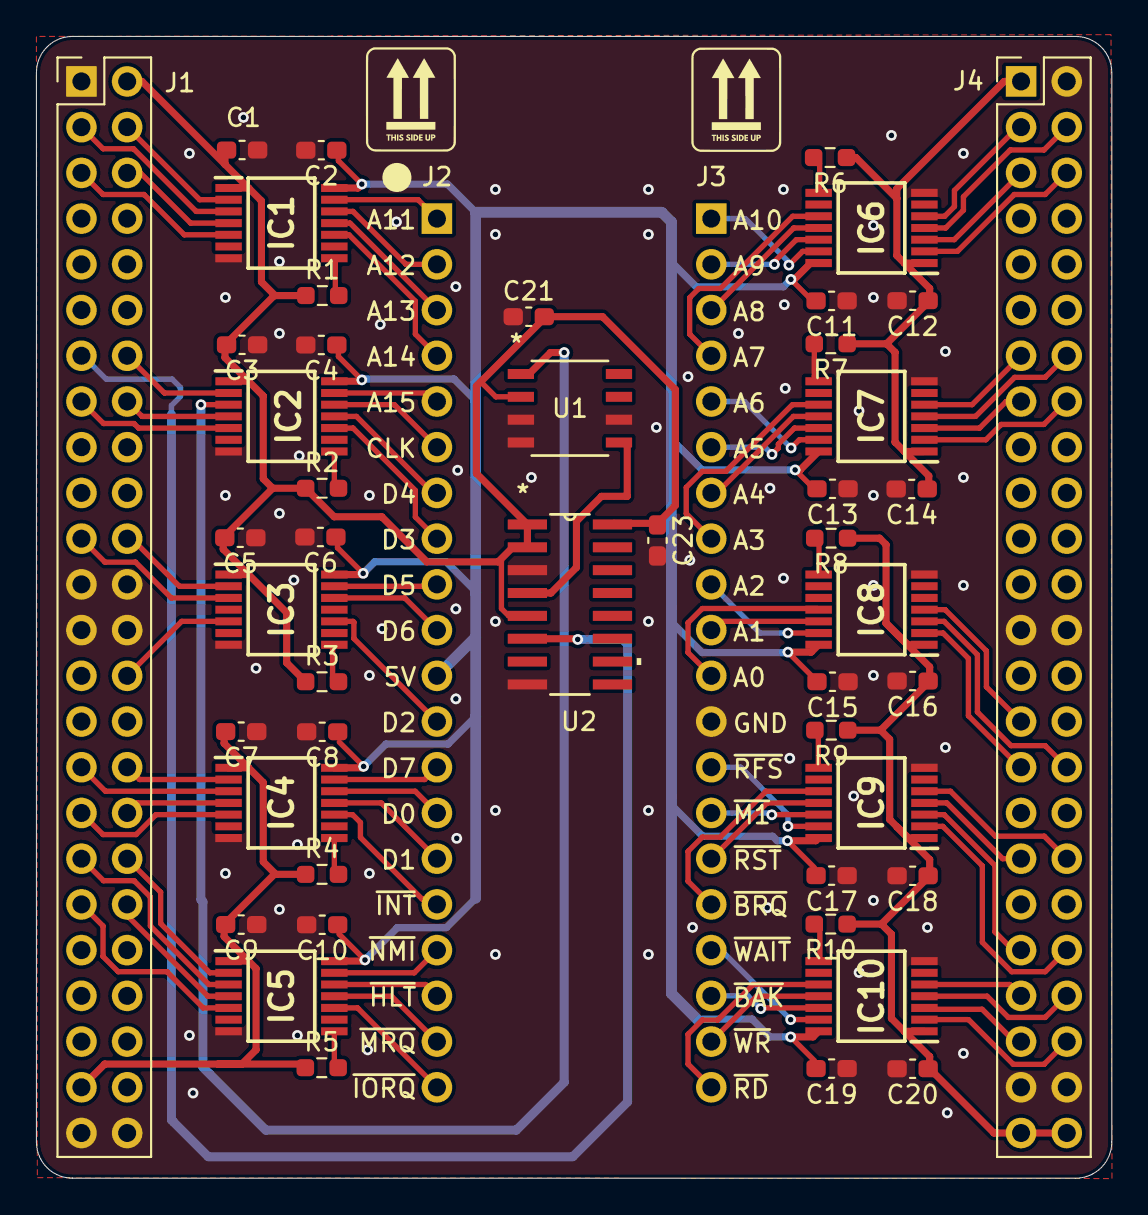
[picture p20: board level-shifter.kicad_pcb from above]

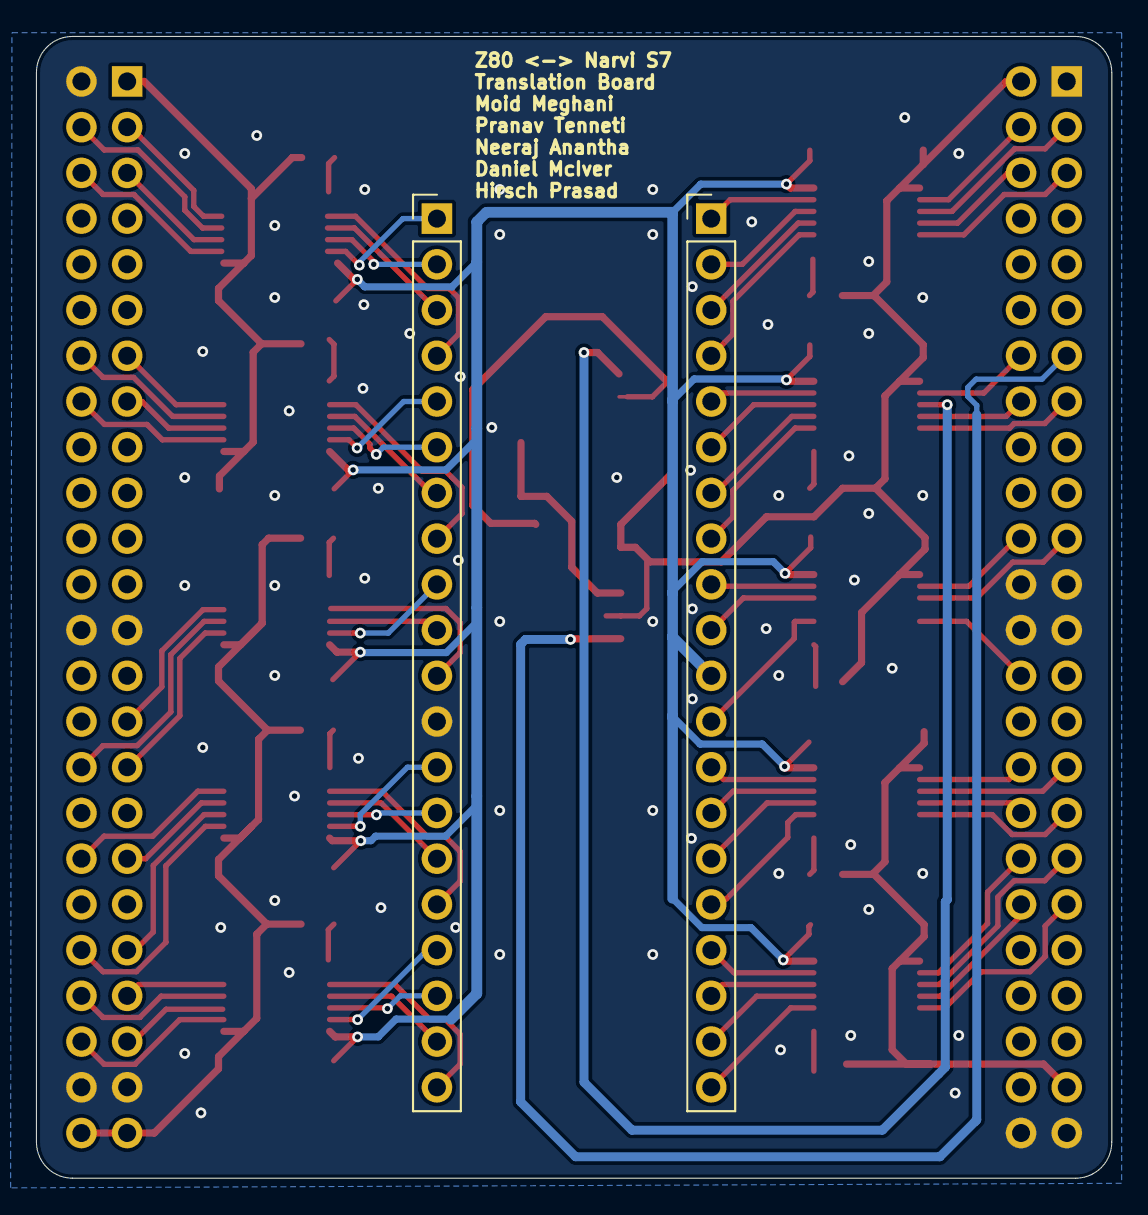
[picture p21: board level-shifter.kicad_pcb from below]

Board: 2 copper layers, 59.7 x 63.4 mm, 48 parts (2 on the bottom side), 94 nets.
