hprd/z80-fpga-drop-in-replacement/hardware/computer_breakout/computer_breakout.kicad_pcb

## KiCad design hardware/computer_breakout/computer_breakout.kicad_pcb (2026-02-06)

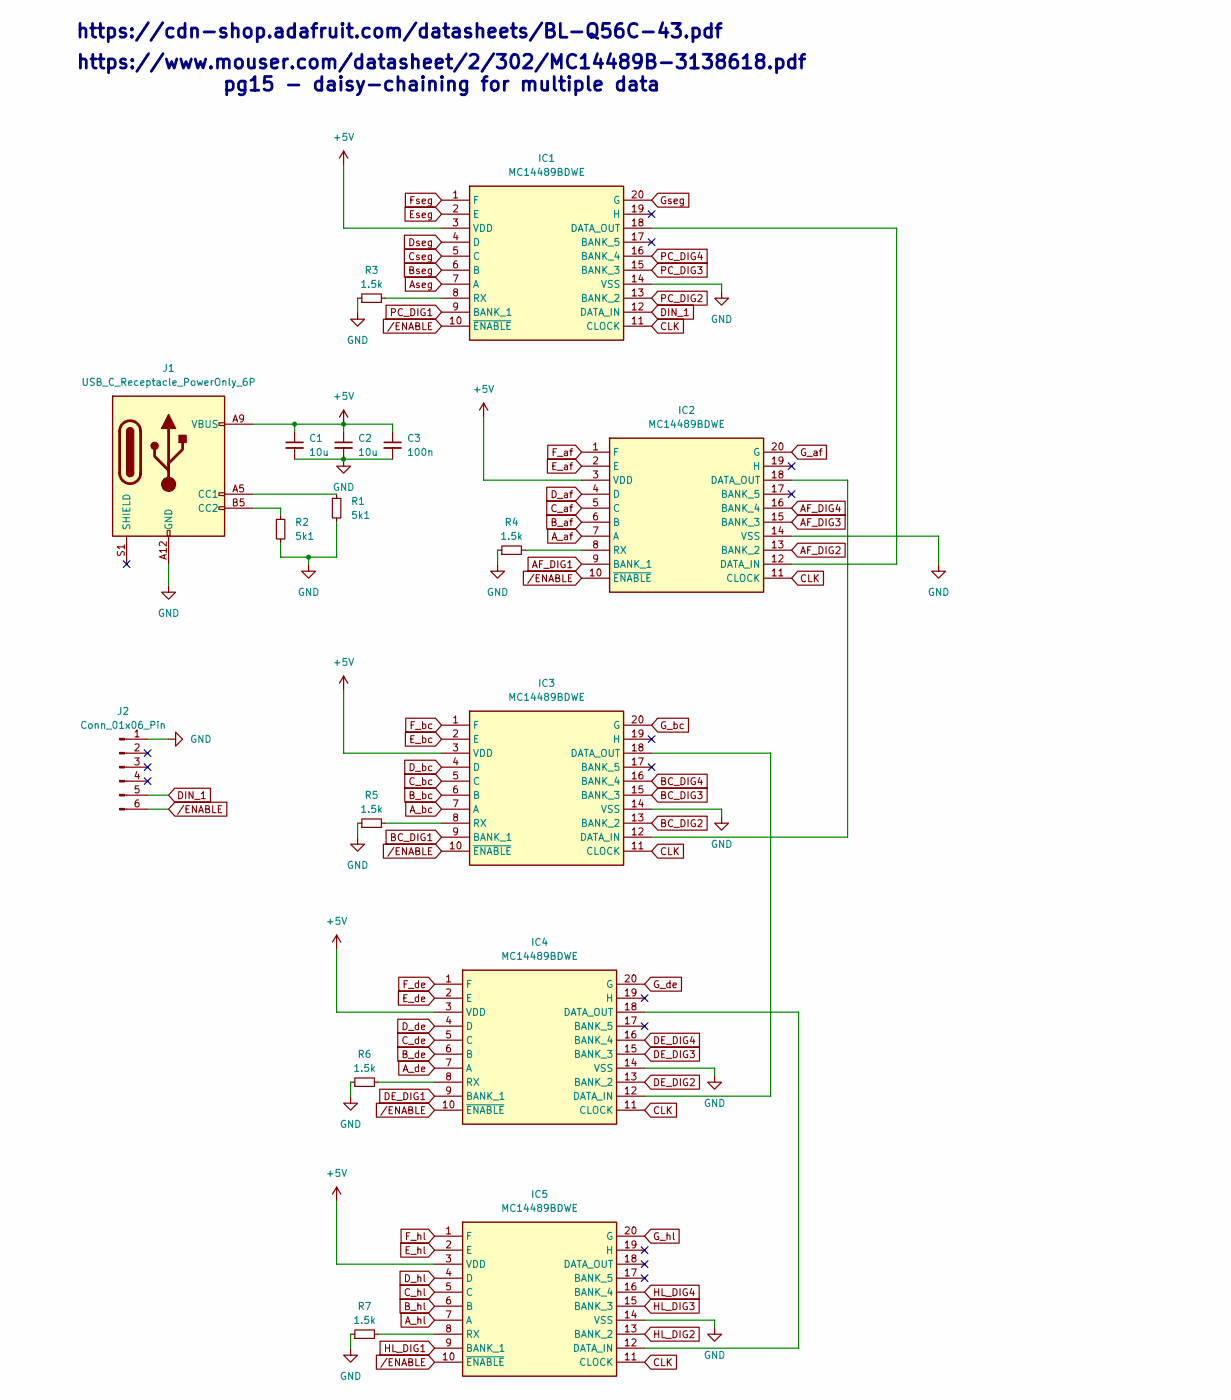
[picture p22: schematic computer_breakout.kicad_sch, part in row 1, column 1]

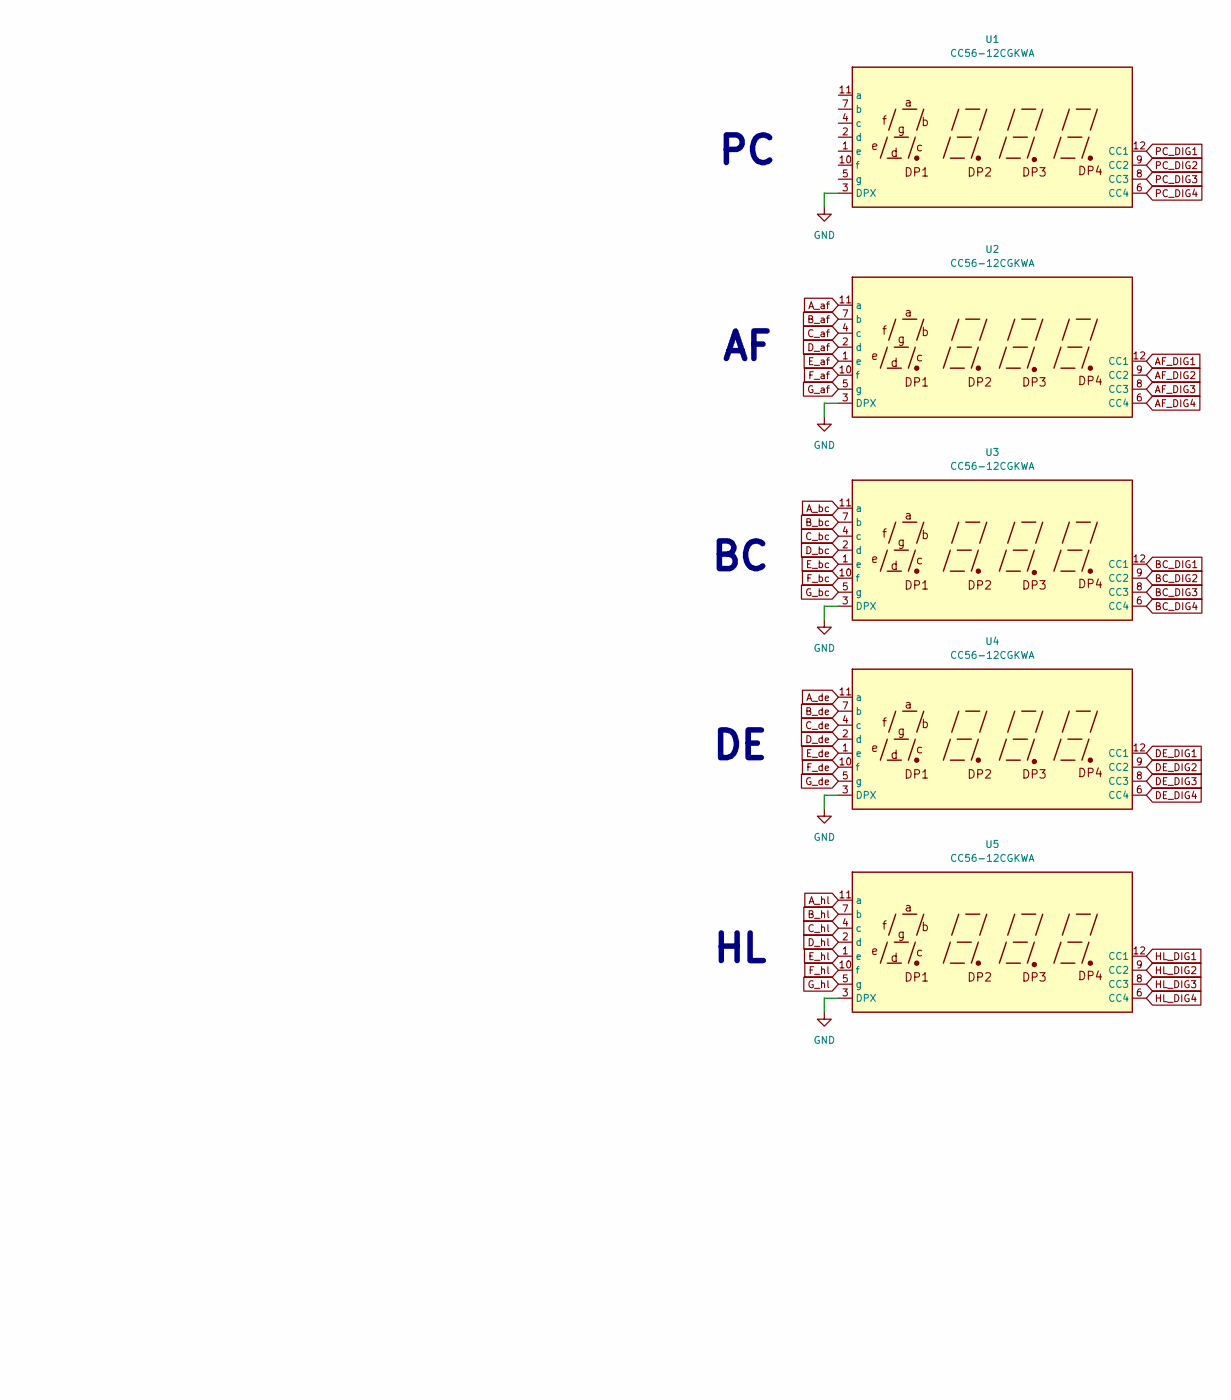
[picture p23: schematic computer_breakout.kicad_sch, part in row 1, column 2]

Parts:
C1, C2: 10u; C_1206_3216Metric_Pad1.33x1.80mm_HandSolder
C3: 100n; C_0603_1608Metric_Pad1.08x0.95mm_HandSolder
IC1, IC2, IC3, IC4, IC5: MC14489BDWE; SOIC127P1030X265-20N; Mouser Part Number 841-MC14489BDWE
J1: USB_C_Receptacle_PowerOnly_6P; USB_C_Receptacle_GCT_USB4110
J2: Conn_01x06_Pin; PinHeader_1x06_P2.54mm_Vertical
R1, R2: 5k1; R_1812_4532Metric_Pad1.30x3.40mm_HandSolder
R3, R4, R5, R6, R7: 1.5k; R_1812_4532Metric_Pad1.30x3.40mm_HandSolder
U1, U2, U3, U4, U5: CC56-12CGKWA; CA56-12CGKWA

Connections:
+5V: C1.1, C2.1, C3.1, IC1.3 (VDD), IC2.3 (VDD), IC3.3 (VDD), IC4.3 (VDD), IC5.3 (VDD), J1.A9 (VBUS), J1.B9 (VBUS)
AF_DIG1: IC2.9 (BANK_1), U2.12 (CC1)
AF_DIG2: IC2.13 (BANK_2), U2.9 (CC2)
AF_DIG3: IC2.15 (BANK_3), U2.8 (CC3)
AF_DIG4: IC2.16 (BANK_4), U2.6 (CC4)
A_af: IC2.7 (A), U2.11 (a)
A_bc: IC3.7 (A), U3.11 (a)
A_de: IC4.7 (A), U4.11 (a)
A_hl: IC5.7 (A), U5.11 (a)
Aseg: IC1.7 (A)
BC_DIG1: IC3.9 (BANK_1), U3.12 (CC1)
BC_DIG2: IC3.13 (BANK_2), U3.9 (CC2)
BC_DIG3: IC3.15 (BANK_3), U3.8 (CC3)
BC_DIG4: IC3.16 (BANK_4), U3.6 (CC4)
B_af: IC2.6 (B), U2.7 (b)
B_bc: IC3.6 (B), U3.7 (b)
B_de: IC4.6 (B), U4.7 (b)
B_hl: IC5.6 (B), U5.7 (b)
Bseg: IC1.6 (B)
CLK: IC1.11 (CLOCK), IC2.11 (CLOCK), IC3.11 (CLOCK), IC4.11 (CLOCK), IC5.11 (CLOCK)
C_af: IC2.5 (C), U2.4 (c)
C_bc: IC3.5 (C), U3.4 (c)
C_de: IC4.5 (C), U4.4 (c)
C_hl: IC5.5 (C), U5.4 (c)
Cseg: IC1.5 (C)
DE_DIG1: IC4.9 (BANK_1), U4.12 (CC1)
DE_DIG2: IC4.13 (BANK_2), U4.9 (CC2)
DE_DIG3: IC4.15 (BANK_3), U4.8 (CC3)
DE_DIG4: IC4.16 (BANK_4), U4.6 (CC4)
DIN_1: IC1.12 (DATA_IN), J2.5
D_af: IC2.4 (D), U2.2 (d)
D_bc: IC3.4 (D), U3.2 (d)
D_de: IC4.4 (D), U4.2 (d)
D_hl: IC5.4 (D), U5.2 (d)
Dseg: IC1.4 (D)
E_af: IC2.2 (E), U2.1 (e)
E_bc: IC3.2 (E), U3.1 (e)
E_de: IC4.2 (E), U4.1 (e)
E_hl: IC5.2 (E), U5.1 (e)
Eseg: IC1.2 (E)
F_af: IC2.1 (F), U2.10 (f)
F_bc: IC3.1 (F), U3.10 (f)
F_de: IC4.1 (F), U4.10 (f)
F_hl: IC5.1 (F), U5.10 (f)
Fseg: IC1.1 (F)
GND: C1.2, C2.2, C3.2, IC1.14 (VSS), IC2.14 (VSS), IC3.14 (VSS), IC4.14 (VSS), IC5.14 (VSS), J1.A12 (GND), J1.B12 (GND), J2.1, R1.2, R2.2, R3.1, R4.1, R5.1, R6.1, R7.1, U1.3 (DPX), U2.3 (DPX), U3.3 (DPX), U4.3 (DPX), U5.3 (DPX)
G_af: IC2.20 (G), U2.5 (g)
G_bc: IC3.20 (G), U3.5 (g)
G_de: IC4.20 (G), U4.5 (g)
G_hl: IC5.20 (G), U5.5 (g)
Gseg: IC1.20 (G)
HL_DIG1: IC5.9 (BANK_1), U5.12 (CC1)
HL_DIG2: IC5.13 (BANK_2), U5.9 (CC2)
HL_DIG3: IC5.15 (BANK_3), U5.8 (CC3)
HL_DIG4: IC5.16 (BANK_4), U5.6 (CC4)
unnamed: IC1.18 (DATA_OUT), IC2.12 (DATA_IN)
unnamed: IC1.8 (RX), R3.2
unnamed: IC2.18 (DATA_OUT), IC3.12 (DATA_IN)
unnamed: IC2.8 (RX), R4.2
unnamed: IC3.18 (DATA_OUT), IC4.12 (DATA_IN)
unnamed: IC3.8 (RX), R5.2
unnamed: IC4.18 (DATA_OUT), IC5.12 (DATA_IN)
unnamed: IC4.8 (RX), R6.2
unnamed: IC5.8 (RX), R7.2
unnamed: J1.A5 (CC1), R1.1
unnamed: J1.B5 (CC2), R2.1
PC_DIG1: IC1.9 (BANK_1), U1.12 (CC1)
PC_DIG2: IC1.13 (BANK_2), U1.9 (CC2)
PC_DIG3: IC1.15 (BANK_3), U1.8 (CC3)
PC_DIG4: IC1.16 (BANK_4), U1.6 (CC4)
/ENABLE: IC1.10 (~ENABLE), IC2.10 (~ENABLE), IC3.10 (~ENABLE), IC4.10 (~ENABLE), IC5.10 (~ENABLE), J2.6

Notes on the sheet:
https://www.mouser.com/datasheet/2/302/MC14489B-3138618.pdf pg15 - daisy-chaining for multiple data
https://cdn-shop.adafruit.com/datasheets/BL-Q56C-43.pdf

Board: 2 copper layers, 22 parts (0 on the bottom side), 64 nets, no tracks yet.
