hprd/z80-fpga-drop-in-replacement/hardware/sip-board/sip-board.kicad_pcb

## KiCad design hardware/sip-board/sip-board.kicad_pcb (2026-02-06)

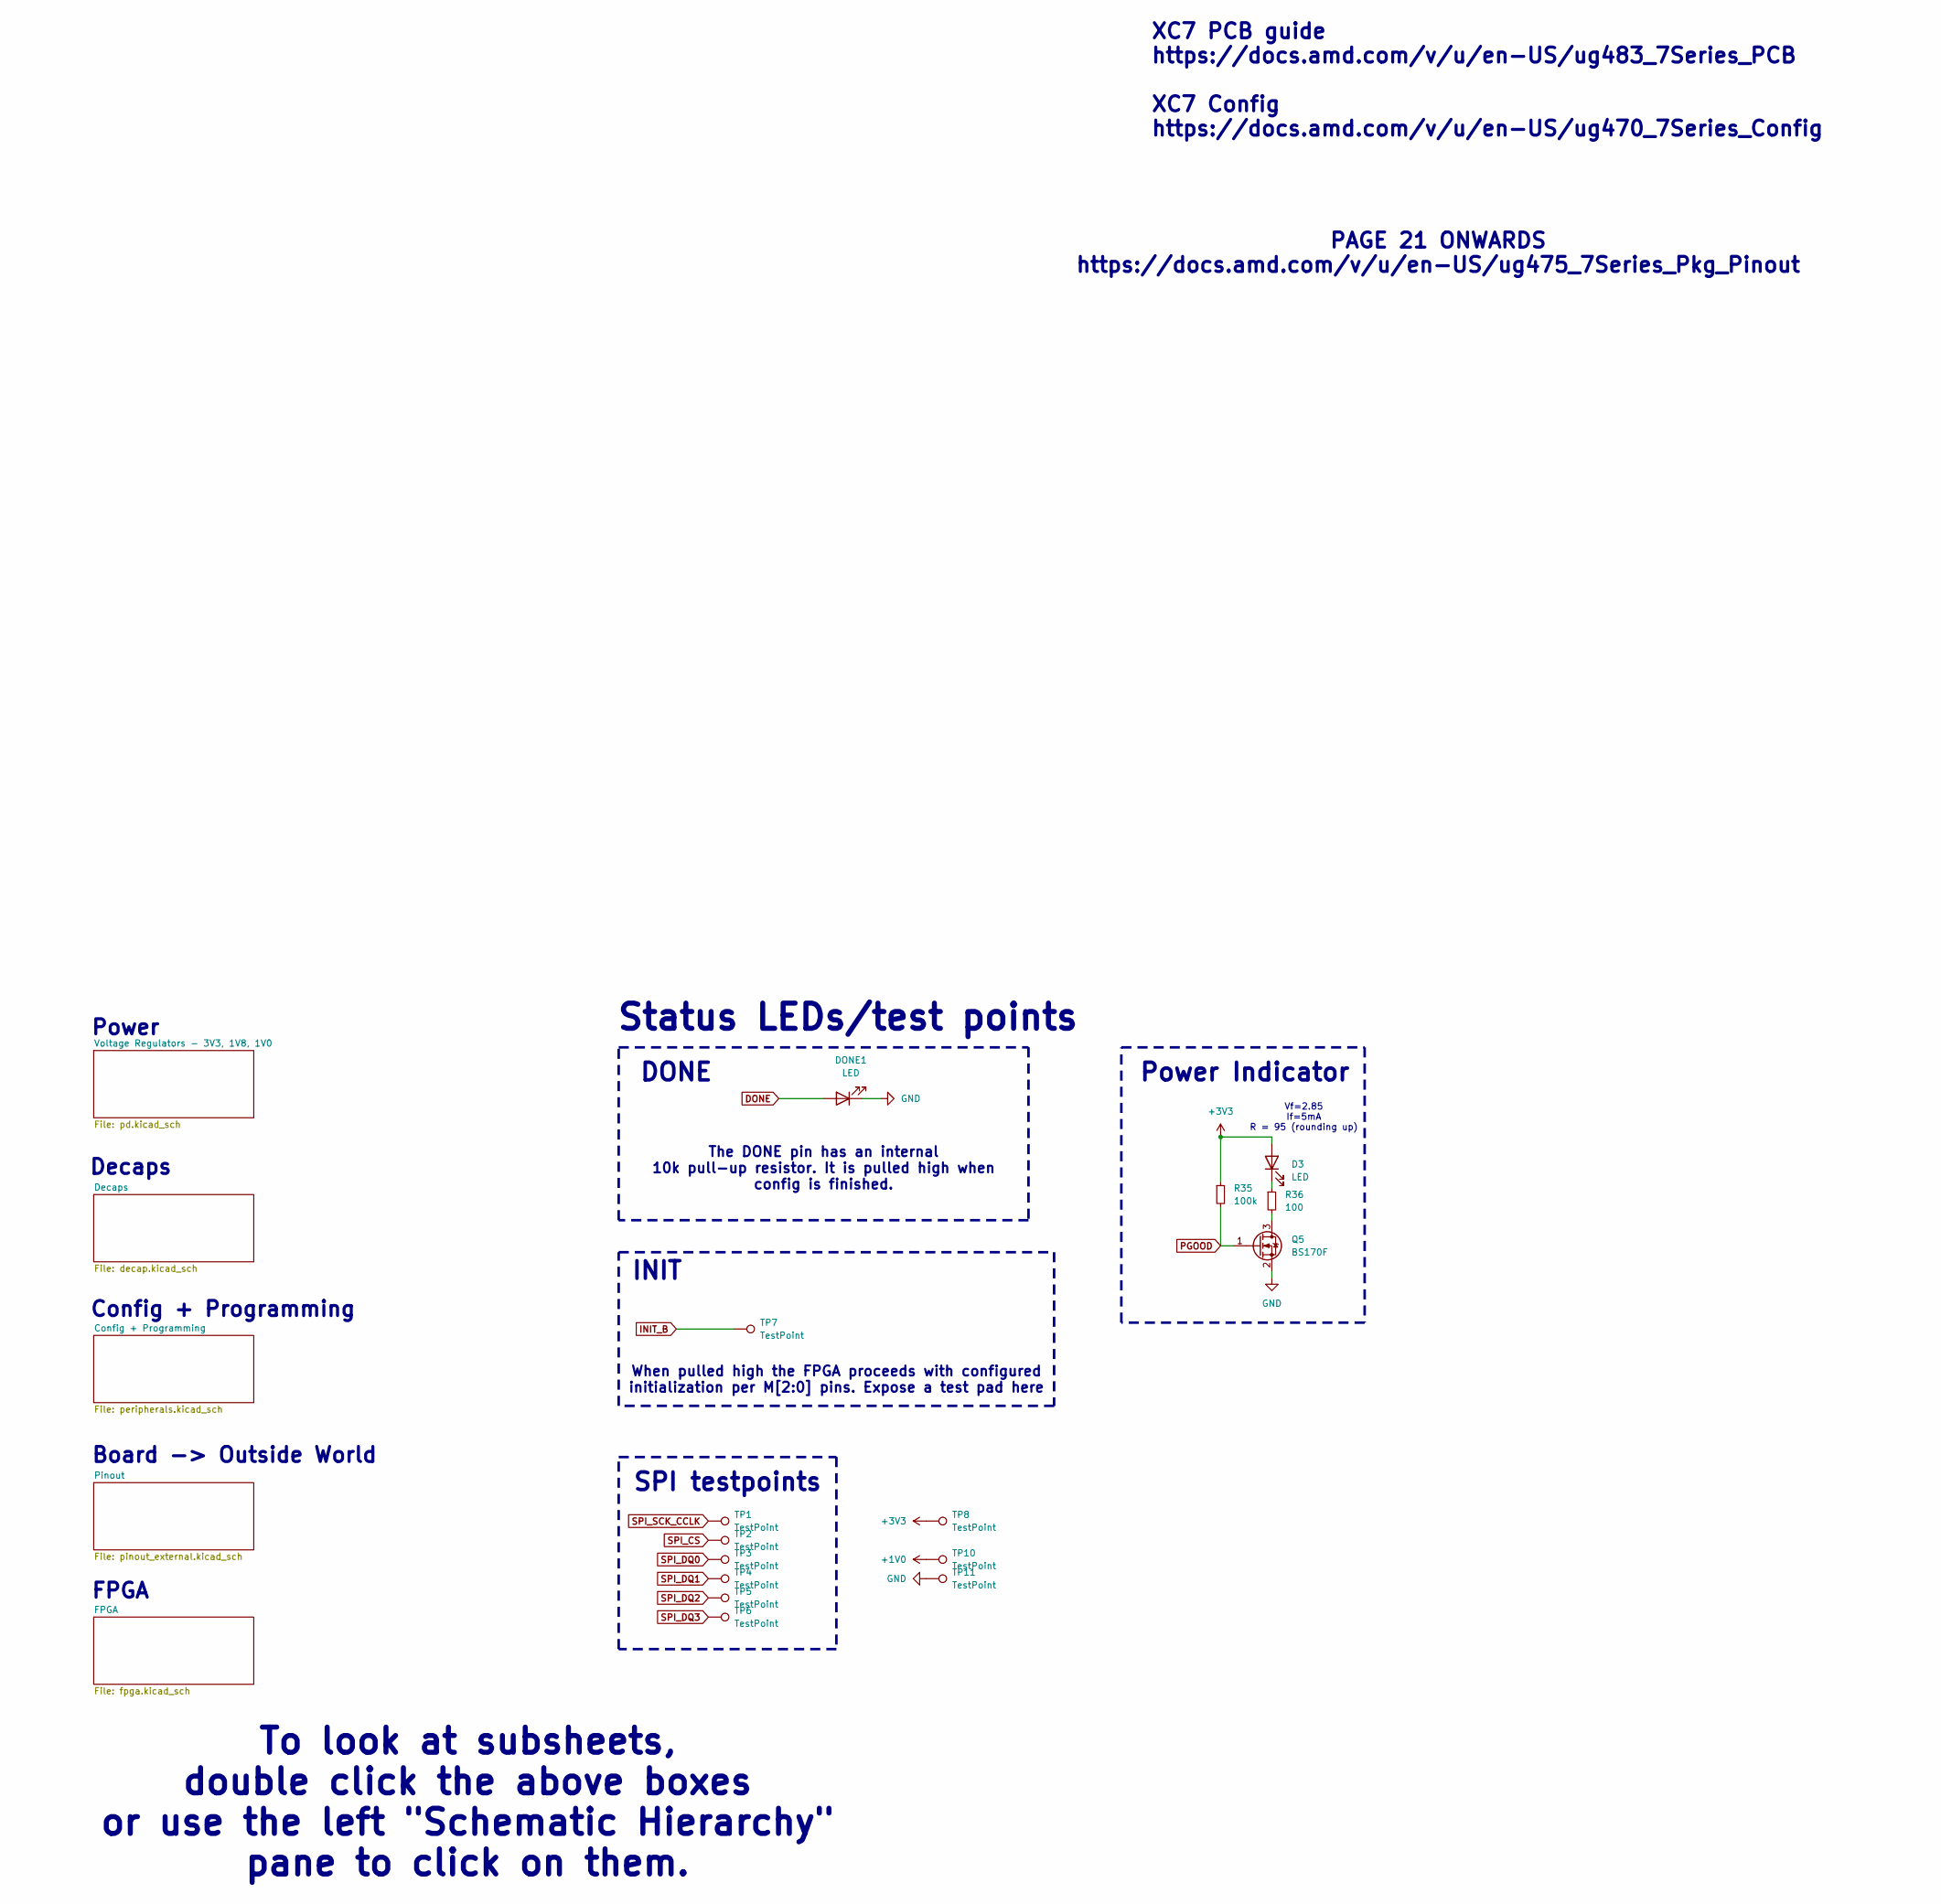
[picture p24: schematic sip-board.kicad_sch, Z80 Drop In SiP Board, part in row 1, column 1]

Parts:
D3: LED; LED_0402_1005Metric
DONE1: LED; LED_0402_1005Metric
Q5: BS170F; SOT-23
R35: 100k; R_0201_0603Metric
R36: 100; R_0201_0603Metric
TP1, TP2, TP3, TP4, TP5, TP6, TP7, TP8, TP10, TP11: TestPoint; TestPoint_Pad_1.0x1.0mm

Connections:
+1V0: TP10.1; also elsewhere on the board
+3V3: D3.2 (A), R35.1, TP8.1; also elsewhere on the board
DONE: DONE1.2 (A); also elsewhere on the board
GND: DONE1.1 (K), Q5.2 (S), TP11.1; also elsewhere on the board
INIT_B: TP7.1; also elsewhere on the board
unnamed: D3.1 (K), R36.1
unnamed: Q5.3 (D), R36.2
PGOOD: Q5.1 (G), R35.2; also elsewhere on the board
SPI_CS: TP2.1; also elsewhere on the board
SPI_DQ0: TP3.1; also elsewhere on the board
SPI_DQ1: TP4.1; also elsewhere on the board
SPI_DQ2: TP5.1; also elsewhere on the board
SPI_DQ3: TP6.1; also elsewhere on the board
SPI_SCK_CCLK: TP1.1; also elsewhere on the board

Notes on the sheet:
Power
Status LEDs/test points
FPGA
Decaps
XC7 PCB guide https://docs.amd.com/v/u/en-US/ug483_7Series_PCB XC7 Config https://docs.amd.com/v/u/en-US/ug470_7Series_Config
Board -> Outside World
Power Indicator
PAGE 21 ONWARDS https://docs.amd.com/v/u/en-US/ug475_7Series_Pkg_Pinout
INIT
Config + Programming
https://docs.amd.com/r/en-US/ug1099-bga-device-design-rules/Power-Delivery-to-the-FPGA
When pulled high the FPGA proceeds with configured initialization per M[2:0] pins. Expose a test pad here
DONE
The DONE pin has an internal 10k pull-up resistor. It is pulled high when config is finished.
SPI testpoints
To look at subsheets, double click the above boxes or use the left "Schematic Hierarchy" pane to click on them.
Vf=2.85 If=5mA R = 95 (rounding up)

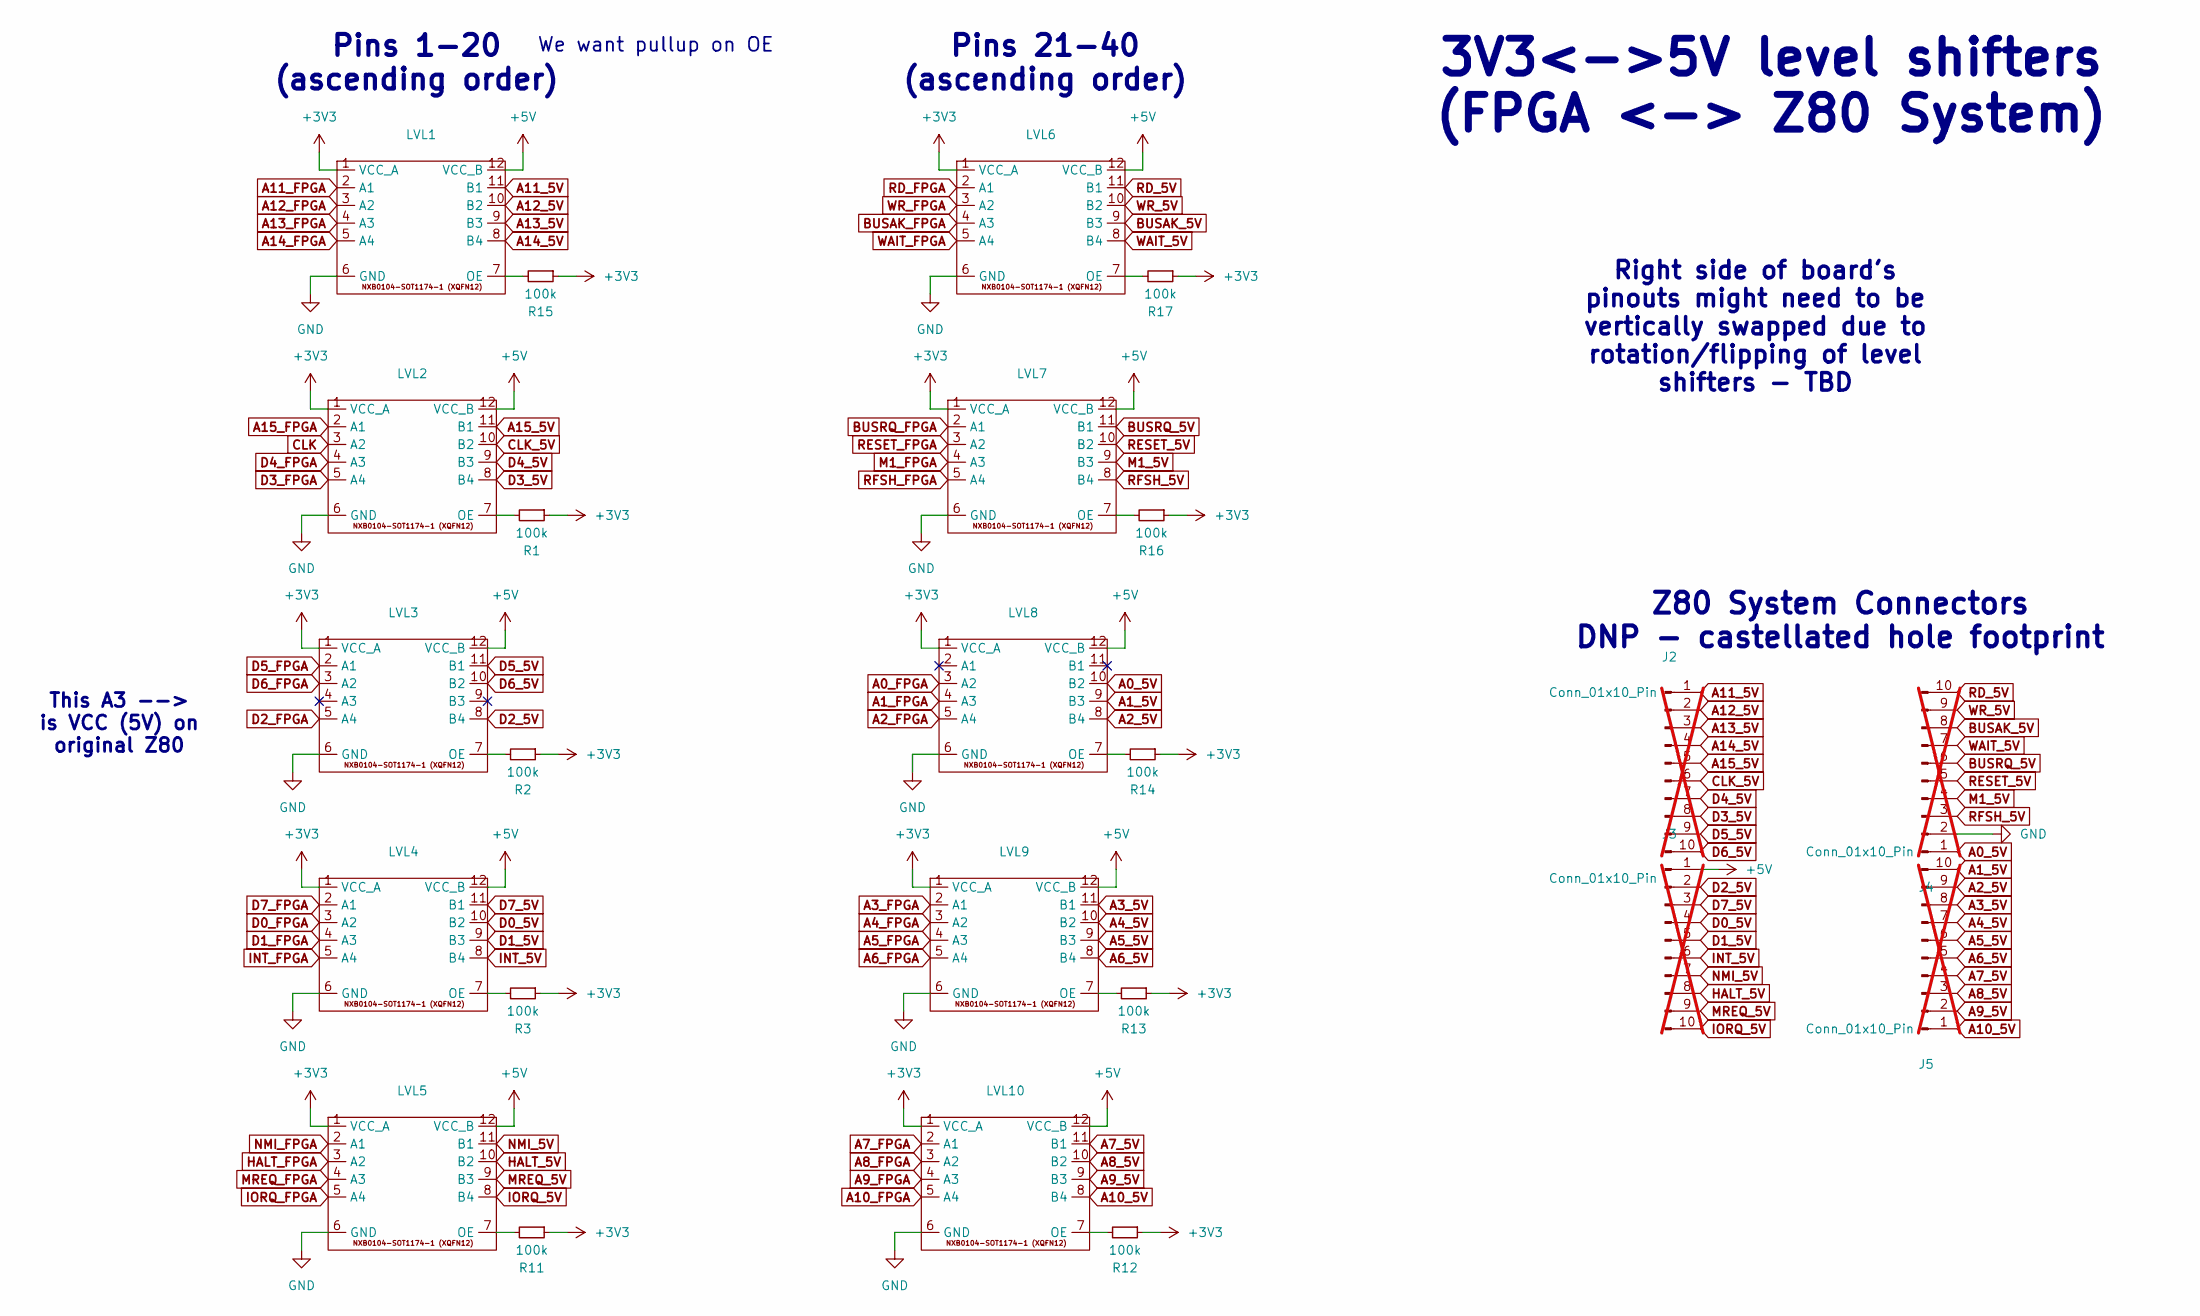
[picture p25: schematic pinout_external.kicad_sch]

Parts:
J2, J3, J4, J5: Conn_01x10_Pin; PinHeader_1x10_P2.54mm_Vertical; not fitted
LVL1, LVL2, LVL3, LVL4, LVL5, LVL6, LVL7, LVL8, LVL9, LVL10: NXB0104GU12X; MPN NXB0104GU12X
R1, R2, R3, R11, R12, R13, R14, R15, R16, R17: 100k; R_0201_0603Metric

Connections:
+3V3: LVL1.1 (VCC_A), LVL2.1 (VCC_A), LVL3.1 (VCC_A), LVL4.1 (VCC_A), LVL5.1 (VCC_A), LVL6.1 (VCC_A), LVL7.1 (VCC_A), LVL8.1 (VCC_A), LVL9.1 (VCC_A), LVL10.1 (VCC_A), R1.1, R2.1, R3.1, R11.1, R12.1, R13.1, R14.1, R15.1, R16.1, R17.1; also elsewhere on the board
+5V: J3.1, LVL1.12 (VCC_B), LVL2.12 (VCC_B), LVL3.12 (VCC_B), LVL4.12 (VCC_B), LVL5.12 (VCC_B), LVL6.12 (VCC_B), LVL7.12 (VCC_B), LVL8.12 (VCC_B), LVL9.12 (VCC_B), LVL10.12 (VCC_B); also elsewhere on the board
A0_5V: J4.1, LVL8.10 (B2)
A0_FPGA: LVL8.3 (A2); also elsewhere on the board
A1_5V: J5.10, LVL8.9 (B3)
A1_FPGA: LVL8.4 (A3); also elsewhere on the board
A2_5V: J5.9, LVL8.8 (B4)
A2_FPGA: LVL8.5 (A4); also elsewhere on the board
A3_5V: J5.8, LVL9.11 (B1)
A3_FPGA: LVL9.2 (A1); also elsewhere on the board
A4_5V: J5.7, LVL9.10 (B2)
A4_FPGA: LVL9.3 (A2); also elsewhere on the board
A5_5V: J5.6, LVL9.9 (B3)
A5_FPGA: LVL9.4 (A3); also elsewhere on the board
A6_5V: J5.5, LVL9.8 (B4)
A6_FPGA: LVL9.5 (A4); also elsewhere on the board
A7_5V: J5.4, LVL10.11 (B1)
A7_FPGA: LVL10.2 (A1); also elsewhere on the board
A8_5V: J5.3, LVL10.10 (B2)
A8_FPGA: LVL10.3 (A2); also elsewhere on the board
A9_5V: J5.2, LVL10.9 (B3)
A9_FPGA: LVL10.4 (A3); also elsewhere on the board
A10_5V: J5.1, LVL10.8 (B4)
A10_FPGA: LVL10.5 (A4); also elsewhere on the board
A11_5V: J2.1, LVL1.11 (B1)
A11_FPGA: LVL1.2 (A1); also elsewhere on the board
A12_5V: J2.2, LVL1.10 (B2)
A12_FPGA: LVL1.3 (A2); also elsewhere on the board
A13_5V: J2.3, LVL1.9 (B3)
A13_FPGA: LVL1.4 (A3); also elsewhere on the board
A14_5V: J2.4, LVL1.8 (B4)
A14_FPGA: LVL1.5 (A4); also elsewhere on the board
A15_5V: J2.5, LVL2.11 (B1)
A15_FPGA: LVL2.2 (A1); also elsewhere on the board
BUSAK_5V: J4.8, LVL6.9 (B3)
BUSAK_FPGA: LVL6.4 (A3); also elsewhere on the board
BUSRQ_5V: J4.6, LVL7.11 (B1)
BUSRQ_FPGA: LVL7.2 (A1); also elsewhere on the board
CLK: LVL2.3 (A2); also elsewhere on the board
CLK_5V: J2.6, LVL2.10 (B2)
D0_5V: J3.4, LVL4.10 (B2)
D0_FPGA: LVL4.3 (A2); also elsewhere on the board
D1_5V: J3.5, LVL4.9 (B3)
D1_FPGA: LVL4.4 (A3); also elsewhere on the board
D2_5V: J3.2, LVL3.8 (B4)
D2_FPGA: LVL3.5 (A4); also elsewhere on the board
D3_5V: J2.8, LVL2.8 (B4)
D3_FPGA: LVL2.5 (A4); also elsewhere on the board
D4_5V: J2.7, LVL2.9 (B3)
D4_FPGA: LVL2.4 (A3); also elsewhere on the board
D5_5V: J2.9, LVL3.11 (B1)
D5_FPGA: LVL3.2 (A1); also elsewhere on the board
D6_5V: J2.10, LVL3.10 (B2)
D6_FPGA: LVL3.3 (A2); also elsewhere on the board
D7_5V: J3.3, LVL4.11 (B1)
D7_FPGA: LVL4.2 (A1); also elsewhere on the board
GND: J4.2, LVL1.6 (GND), LVL2.6 (GND), LVL3.6 (GND), LVL4.6 (GND), LVL5.6 (GND), LVL6.6 (GND), LVL7.6 (GND), LVL8.6 (GND), LVL9.6 (GND), LVL10.6 (GND); also elsewhere on the board
HALT_5V: J3.8, LVL5.10 (B2)
HALT_FPGA: LVL5.3 (A2); also elsewhere on the board
INT_5V: J3.6, LVL4.8 (B4)
INT_FPGA: LVL4.5 (A4); also elsewhere on the board
IORQ_5V: J3.10, LVL5.8 (B4)
IORQ_FPGA: LVL5.5 (A4); also elsewhere on the board
M1_5V: J4.4, LVL7.9 (B3)
M1_FPGA: LVL7.4 (A3); also elsewhere on the board
MREQ_5V: J3.9, LVL5.9 (B3)
MREQ_FPGA: LVL5.4 (A3); also elsewhere on the board
NMI_5V: J3.7, LVL5.11 (B1)
NMI_FPGA: LVL5.2 (A1); also elsewhere on the board
unnamed: LVL1.7 (OE), R15.2
unnamed: LVL2.7 (OE), R1.2
unnamed: LVL3.7 (OE), R2.2
unnamed: LVL4.7 (OE), R3.2
unnamed: LVL5.7 (OE), R11.2
unnamed: LVL6.7 (OE), R17.2
unnamed: LVL7.7 (OE), R16.2
unnamed: LVL8.7 (OE), R14.2
unnamed: LVL9.7 (OE), R13.2
unnamed: LVL10.7 (OE), R12.2
RD_5V: J4.10, LVL6.11 (B1)
RD_FPGA: LVL6.2 (A1); also elsewhere on the board
RESET_5V: J4.5, LVL7.10 (B2)
RESET_FPGA: LVL7.3 (A2); also elsewhere on the board
RFSH_5V: J4.3, LVL7.8 (B4)
RFSH_FPGA: LVL7.5 (A4); also elsewhere on the board
WAIT_5V: J4.7, LVL6.8 (B4)
WAIT_FPGA: LVL6.5 (A4); also elsewhere on the board
WR_5V: J4.9, LVL6.10 (B2)
WR_FPGA: LVL6.3 (A2); also elsewhere on the board

Notes on the sheet:
3V3<->5V level shifters (FPGA <-> Z80 System)
Z80 System Connectors DNP - castellated hole footprint
This A3 --> is VCC (5V) on original Z80
We want pullup on OE
Right side of board's pinouts might need to be vertically swapped due to rotation/flipping of level shifters - TBD
Pins 21-40 (ascending order)
Pins 1-20 (ascending order)

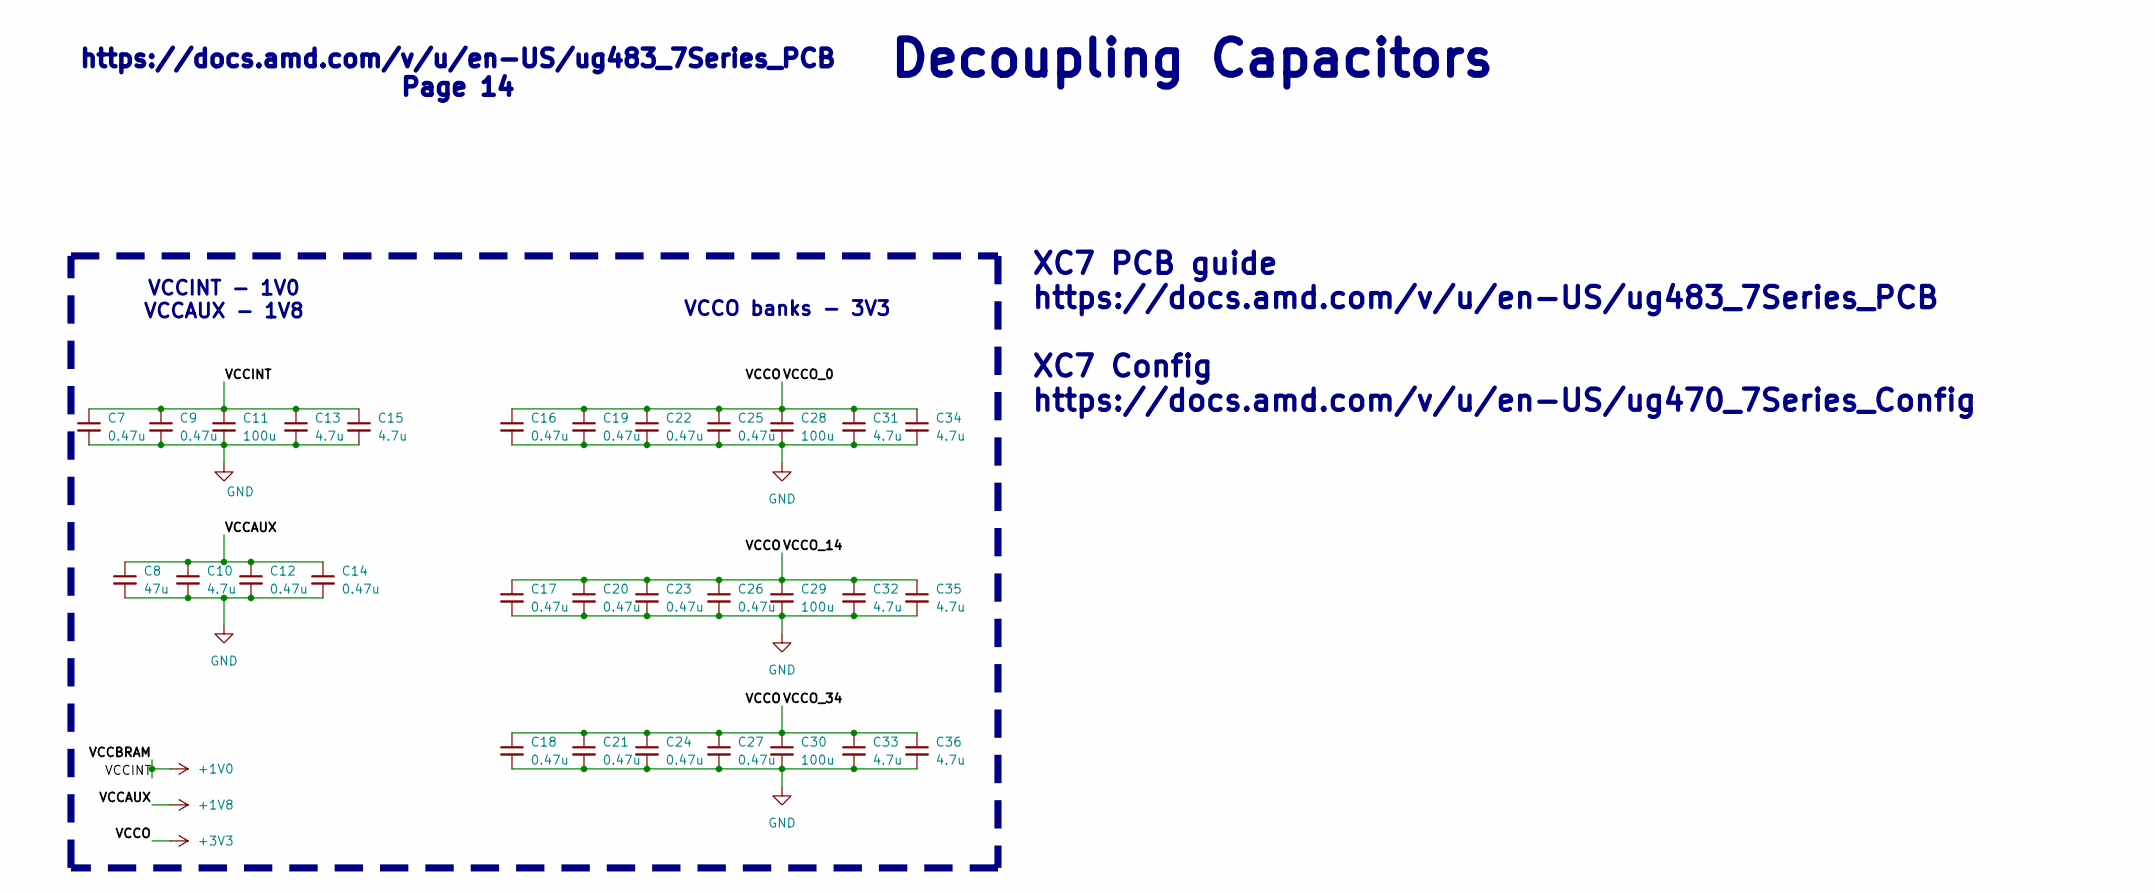
[picture p26: schematic decap.kicad_sch]

Parts:
C7, C9, C12, C14, C16, C17, C18, C19, C20, C21, C22, C23, C24, C25, C26, C27: 0.47u; C_0201_0603Metric
C8: 47u; C_0603_1608Metric
C10, C13, C15, C31, C32, C33, C34, C35, C36: 4.7u; C_0402_1005Metric
C11, C28, C29, C30: 100u; C_0603_1608Metric

Connections:
+1V0: C7.1, C9.1, C11.1, C13.1, C15.1; also elsewhere on the board
+1V8: C8.1, C10.1, C12.1, C14.1; also elsewhere on the board
+3V3: C16.1, C17.1, C18.1, C19.1, C20.1, C21.1, C22.1, C23.1, C24.1, C25.1, C26.1, C27.1, C28.1, C29.1, C30.1, C31.1, C32.1, C33.1, C34.1, C35.1, C36.1; also elsewhere on the board
GND: C7.2, C8.2, C9.2, C10.2, C11.2, C12.2, C13.2, C14.2, C15.2, C16.2, C17.2, C18.2, C19.2, C20.2, C21.2, C22.2, C23.2, C24.2, C25.2, C26.2, C27.2, C28.2, C29.2, C30.2, C31.2, C32.2, C33.2, C34.2, C35.2, C36.2; also elsewhere on the board

Notes on the sheet:
Decoupling Capacitors
XC7 PCB guide https://docs.amd.com/v/u/en-US/ug483_7Series_PCB XC7 Config https://docs.amd.com/v/u/en-US/ug470_7Series_Config
VCCO banks - 3V3
https://docs.amd.com/v/u/en-US/ug483_7Series_PCB Page 14
VCCINT - 1V0 VCCAUX - 1V8
