hprd/z80-fpga-drop-in-replacement/hardware/sip-board/sip-board.kicad_pcb

## KiCad design hardware/sip-board/sip-board.kicad_pcb (continued)

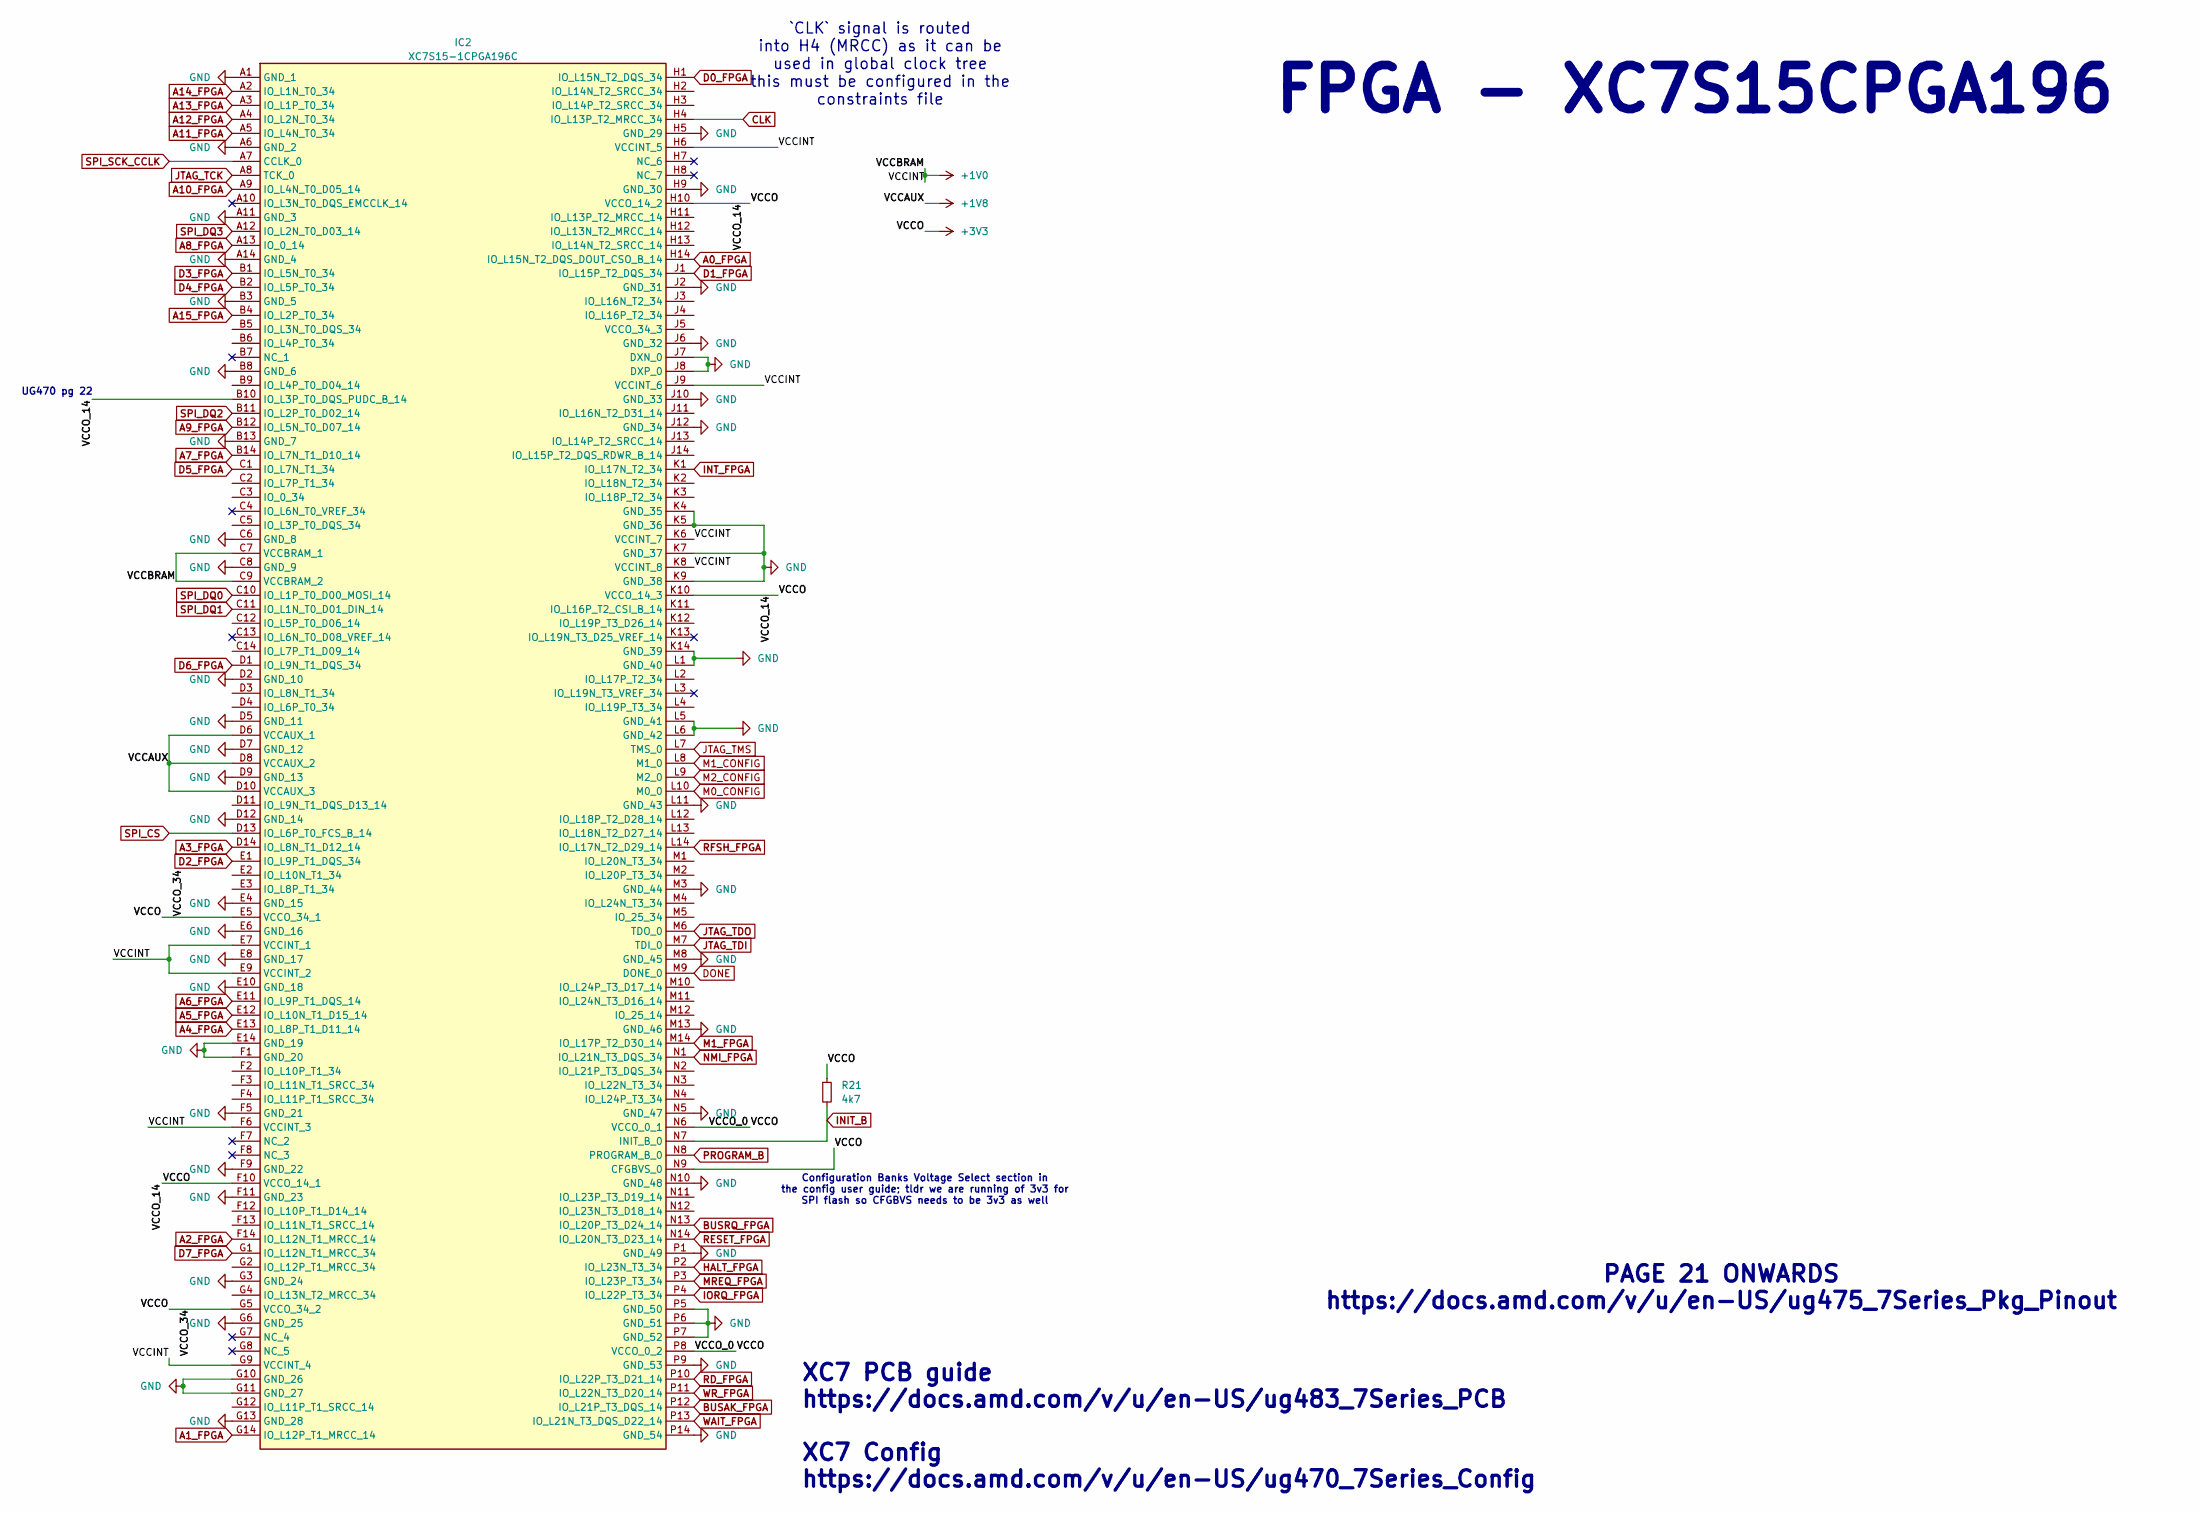
[picture p27: schematic fpga.kicad_sch]

Parts:
IC2: XC7S15-1CPGA196C; BGA196C50P14X14_800X800X110; Mouser Part Number 217-XC7S15-1CPGA196C
R21: 4k7; R_0201_0603Metric

Connections:
+1V0: IC2.C7 (VCCBRAM_1), IC2.C9 (VCCBRAM_2), IC2.E7 (VCCINT_1), IC2.E9 (VCCINT_2), IC2.F6 (VCCINT_3), IC2.G9 (VCCINT_4), IC2.H6 (VCCINT_5), IC2.J9 (VCCINT_6), IC2.K6 (VCCINT_7), IC2.K8 (VCCINT_8); also elsewhere on the board
+1V8: IC2.D6 (VCCAUX_1), IC2.D8 (VCCAUX_2), IC2.D10 (VCCAUX_3); also elsewhere on the board
+3V3: IC2.B10 (IO_L3P_T0_DQS_PUDC_B_14), IC2.E5 (VCCO_34_1), IC2.F10 (VCCO_14_1), IC2.G5 (VCCO_34_2), IC2.H10 (VCCO_14_2), IC2.K10 (VCCO_14_3), IC2.N6 (VCCO_0_1), IC2.N9 (CFGBVS_0), IC2.P8 (VCCO_0_2), R21.1; also elsewhere on the board
A0_FPGA: IC2.H14 (IO_L15N_T2_DQS_DOUT_CSO_B_14); also elsewhere on the board
A1_FPGA: IC2.G14 (IO_L12P_T1_MRCC_14); also elsewhere on the board
A2_FPGA: IC2.F14 (IO_L12N_T1_MRCC_14); also elsewhere on the board
A3_FPGA: IC2.D14 (IO_L8N_T1_D12_14); also elsewhere on the board
A4_FPGA: IC2.E13 (IO_L8P_T1_D11_14); also elsewhere on the board
A5_FPGA: IC2.E12 (IO_L10N_T1_D15_14); also elsewhere on the board
A6_FPGA: IC2.E11 (IO_L9P_T1_DQS_14); also elsewhere on the board
A7_FPGA: IC2.B14 (IO_L7N_T1_D10_14); also elsewhere on the board
A8_FPGA: IC2.A13 (IO_0_14); also elsewhere on the board
A9_FPGA: IC2.B12 (IO_L5N_T0_D07_14); also elsewhere on the board
A10_FPGA: IC2.A9 (IO_L4N_T0_D05_14); also elsewhere on the board
A11_FPGA: IC2.A5 (IO_L4N_T0_34); also elsewhere on the board
A12_FPGA: IC2.A4 (IO_L2N_T0_34); also elsewhere on the board
A13_FPGA: IC2.A3 (IO_L1P_T0_34); also elsewhere on the board
A14_FPGA: IC2.A2 (IO_L1N_T0_34); also elsewhere on the board
A15_FPGA: IC2.B4 (IO_L2P_T0_34); also elsewhere on the board
BUSAK_FPGA: IC2.P12 (IO_L21P_T3_DQS_14); also elsewhere on the board
BUSRQ_FPGA: IC2.N13 (IO_L20P_T3_D24_14); also elsewhere on the board
CLK: IC2.H4 (IO_L13P_T2_MRCC_34); also elsewhere on the board
D0_FPGA: IC2.H1 (IO_L15N_T2_DQS_34); also elsewhere on the board
D1_FPGA: IC2.J1 (IO_L15P_T2_DQS_34); also elsewhere on the board
D2_FPGA: IC2.E1 (IO_L9P_T1_DQS_34); also elsewhere on the board
D3_FPGA: IC2.B1 (IO_L5N_T0_34); also elsewhere on the board
D4_FPGA: IC2.B2 (IO_L5P_T0_34); also elsewhere on the board
D5_FPGA: IC2.C1 (IO_L7N_T1_34); also elsewhere on the board
D6_FPGA: IC2.D1 (IO_L9N_T1_DQS_34); also elsewhere on the board
D7_FPGA: IC2.G1 (IO_L12N_T1_MRCC_34); also elsewhere on the board
DONE: IC2.M9 (DONE_0); also elsewhere on the board
GND: IC2.A1 (GND_1), IC2.A6 (GND_2), IC2.A11 (GND_3), IC2.A14 (GND_4), IC2.B3 (GND_5), IC2.B8 (GND_6), IC2.B13 (GND_7), IC2.C6 (GND_8), IC2.C8 (GND_9), IC2.D2 (GND_10), IC2.D5 (GND_11), IC2.D7 (GND_12), IC2.D9 (GND_13), IC2.D12 (GND_14), IC2.E4 (GND_15), IC2.E6 (GND_16), IC2.E8 (GND_17), IC2.E10 (GND_18), IC2.E14 (GND_19), IC2.F1 (GND_20), IC2.F5 (GND_21), IC2.F9 (GND_22), IC2.F11 (GND_23), IC2.G3 (GND_24), IC2.G6 (GND_25), IC2.G10 (GND_26), IC2.G11 (GND_27), IC2.G13 (GND_28), IC2.H5 (GND_29), IC2.H9 (GND_30), IC2.J2 (GND_31), IC2.J6 (GND_32), IC2.J7 (DXN_0), IC2.J8 (DXP_0), IC2.J10 (GND_33), IC2.J12 (GND_34), IC2.K4 (GND_35), IC2.K5 (GND_36), IC2.K7 (GND_37), IC2.K9 (GND_38), IC2.K14 (GND_39), IC2.L1 (GND_40), IC2.L5 (GND_41), IC2.L6 (GND_42), IC2.L11 (GND_43), IC2.M3 (GND_44), IC2.M8 (GND_45), IC2.M13 (GND_46), IC2.N5 (GND_47), IC2.N10 (GND_48), IC2.P1 (GND_49), IC2.P5 (GND_50), IC2.P6 (GND_51), IC2.P7 (GND_52), IC2.P9 (GND_53), IC2.P14 (GND_54); also elsewhere on the board
HALT_FPGA: IC2.P2 (IO_L23N_T3_34); also elsewhere on the board
INIT_B: IC2.N7 (INIT_B_0), R21.2; also elsewhere on the board
INT_FPGA: IC2.K1 (IO_L17N_T2_34); also elsewhere on the board
IORQ_FPGA: IC2.P4 (IO_L22P_T3_34); also elsewhere on the board
JTAG_TCK: IC2.A8 (TCK_0); also elsewhere on the board
JTAG_TDI: IC2.M7 (TDI_0); also elsewhere on the board
JTAG_TDO: IC2.M6 (TDO_0); also elsewhere on the board
JTAG_TMS: IC2.L7 (TMS_0); also elsewhere on the board
M0_CONFIG: IC2.L10 (M0_0); also elsewhere on the board
M1_CONFIG: IC2.L8 (M1_0); also elsewhere on the board
M1_FPGA: IC2.M14 (IO_L17P_T2_D30_14); also elsewhere on the board
M2_CONFIG: IC2.L9 (M2_0); also elsewhere on the board
MREQ_FPGA: IC2.P3 (IO_L23P_T3_34); also elsewhere on the board
NMI_FPGA: IC2.N1 (IO_L21N_T3_DQS_34); also elsewhere on the board
PROGRAM_B: IC2.N8 (PROGRAM_B_0); also elsewhere on the board
RD_FPGA: IC2.P10 (IO_L22P_T3_D21_14); also elsewhere on the board
RESET_FPGA: IC2.N14 (IO_L20N_T3_D23_14); also elsewhere on the board
RFSH_FPGA: IC2.L14 (IO_L17N_T2_D29_14); also elsewhere on the board
SPI_CS: IC2.D13 (IO_L6P_T0_FCS_B_14); also elsewhere on the board
SPI_DQ0: IC2.C10 (IO_L1P_T0_D00_MOSI_14); also elsewhere on the board
SPI_DQ1: IC2.C11 (IO_L1N_T0_D01_DIN_14); also elsewhere on the board
SPI_DQ2: IC2.B11 (IO_L2P_T0_D02_14); also elsewhere on the board
SPI_DQ3: IC2.A12 (IO_L2N_T0_D03_14); also elsewhere on the board
SPI_SCK_CCLK: IC2.A7 (CCLK_0); also elsewhere on the board
WAIT_FPGA: IC2.P13 (IO_L21N_T3_DQS_D22_14); also elsewhere on the board
WR_FPGA: IC2.P11 (IO_L22N_T3_D20_14); also elsewhere on the board

Notes on the sheet:
UG470 pg 22
XC7 PCB guide https://docs.amd.com/v/u/en-US/ug483_7Series_PCB XC7 Config https://docs.amd.com/v/u/en-US/ug470_7Series_Config
Configuration Banks Voltage Select section in the config user guide; tldr we are running of 3v3 for SPI flash so CFGBVS needs to be 3v3 as well
PAGE 21 ONWARDS https://docs.amd.com/v/u/en-US/ug475_7Series_Pkg_Pinout
`CLK` signal is routed into H4 (MRCC) as it can be used in global clock tree this must be configured in the constraints file
FPGA - XC7S15CPGA196

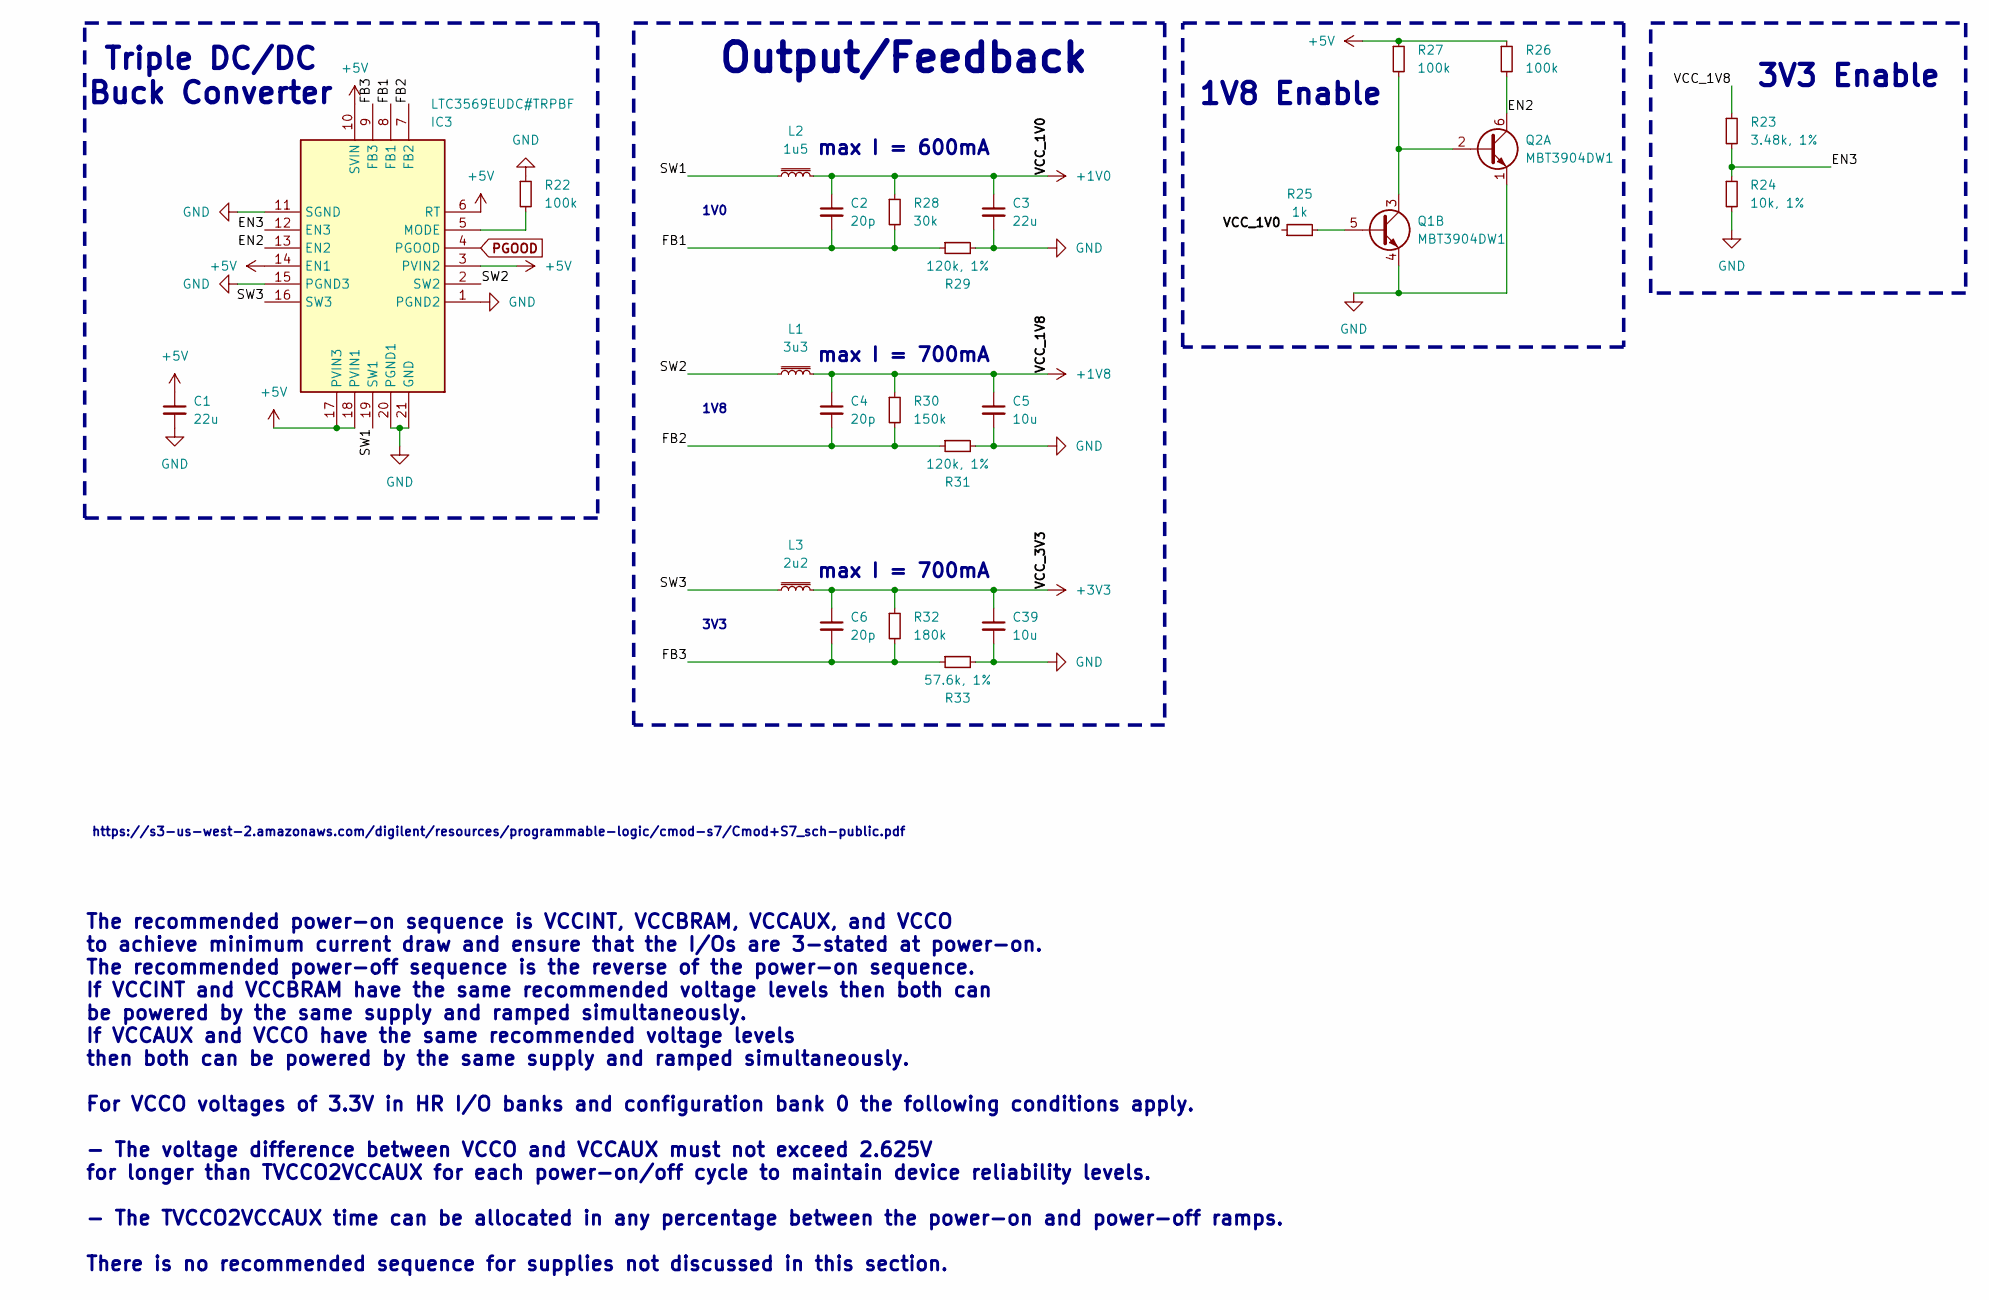
[picture p28: schematic pd.kicad_sch]

Parts:
C1, C3: 22u; C_0201_0603Metric
C2, C4, C6: 20p; C_0201_0603Metric
C5, C39: 10u; C_0201_0603Metric
IC3: LTC3569EUDC#TRPBF; QFN50P300X400X80-21N-D; Mouser Part Number 584-LTC3569EUDCTRPBF
L1: 3u3; L_0805_2012Metric; MPN BRC2012T3R3MD
L2: 1u5; L_0805_2012Metric; MPN SRN2012-1R5M
L3: 2u2; L_0805_2012Metric; MPN SRN2012-2R2M
Q1, Q2: MBT3904DW1; SOT-363_SC-70-6
R22, R26, R27: 100k; R_0201_0603Metric
R23: 3.48k, 1%; R_0201_0603Metric
R24: 10k, 1%; R_0201_0603Metric
R25: 1k; R_0201_0603Metric
R28: 30k; R_0201_0603Metric
R29, R31: 120k, 1%; R_0201_0603Metric
R30: 150k; R_0201_0603Metric
R32: 180k; R_0201_0603Metric
R33: 57.6k, 1%; R_0201_0603Metric

Connections:
+1V0: C2.1, C3.1, L2.2, R25.1, R28.1; also elsewhere on the board
+1V8: C4.1, C5.1, L1.2, R23.1, R30.1; also elsewhere on the board
+3V3: C6.1, C39.1, L3.2, R32.1; also elsewhere on the board
+5V: C1.1, IC3.3 (PVIN2), IC3.6 (RT), IC3.10 (SVIN), IC3.14 (EN1), IC3.17 (PVIN3), IC3.18 (PVIN1), R26.1, R27.1; also elsewhere on the board
/Voltage Regulators - 3V3, 1V8, 1V0/EN2: IC3.13 (EN2), Q2.6 (C1), R26.2
/Voltage Regulators - 3V3, 1V8, 1V0/EN3: IC3.12 (EN3), R23.2, R24.1
/Voltage Regulators - 3V3, 1V8, 1V0/FB1: C2.2, IC3.8 (FB1), R28.2, R29.1
/Voltage Regulators - 3V3, 1V8, 1V0/FB2: C4.2, IC3.7 (FB2), R30.2, R31.1
/Voltage Regulators - 3V3, 1V8, 1V0/FB3: C6.2, IC3.9 (FB3), R32.2, R33.1
/Voltage Regulators - 3V3, 1V8, 1V0/SW1: IC3.19 (SW1), L2.1
/Voltage Regulators - 3V3, 1V8, 1V0/SW2: IC3.2 (SW2), L1.1
/Voltage Regulators - 3V3, 1V8, 1V0/SW3: IC3.16 (SW3), L3.1
GND: C1.2, C3.2, C5.2, C39.2, IC3.1 (PGND2), IC3.11 (SGND), IC3.15 (PGND3), IC3.20 (PGND1), IC3.21 (GND), Q1.4 (E2), Q2.1 (E1), R22.1, R24.2, R29.2, R31.2, R33.2; also elsewhere on the board
unnamed: IC3.5 (MODE), R22.2
unnamed: Q1.5 (B2), R25.2
unnamed: Q1.3 (C2), Q2.2 (B1), R27.2
PGOOD: IC3.4 (PGOOD); also elsewhere on the board

Notes on the sheet:
3V3 Enable
max I = 700mA
3V3
Triple DC/DC Buck Converter
The recommended power-on sequence is VCCINT, VCCBRAM, VCCAUX, and VCCO to achieve minimum current draw and ensure that the I/Os are 3-stated at power-on. The recommended power-off sequence is the reverse of the power-on sequence. If VCCINT and VCCBRAM have the same recommended voltage levels then b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
1V0
max I = 600mA
1V8
https://s3-us-west-2.amazonaws.com/digilent/resources/programmable-logic/cmod-s7/Cmod+S7_sch-public.pdf
Output/Feedback
1V8 Enable

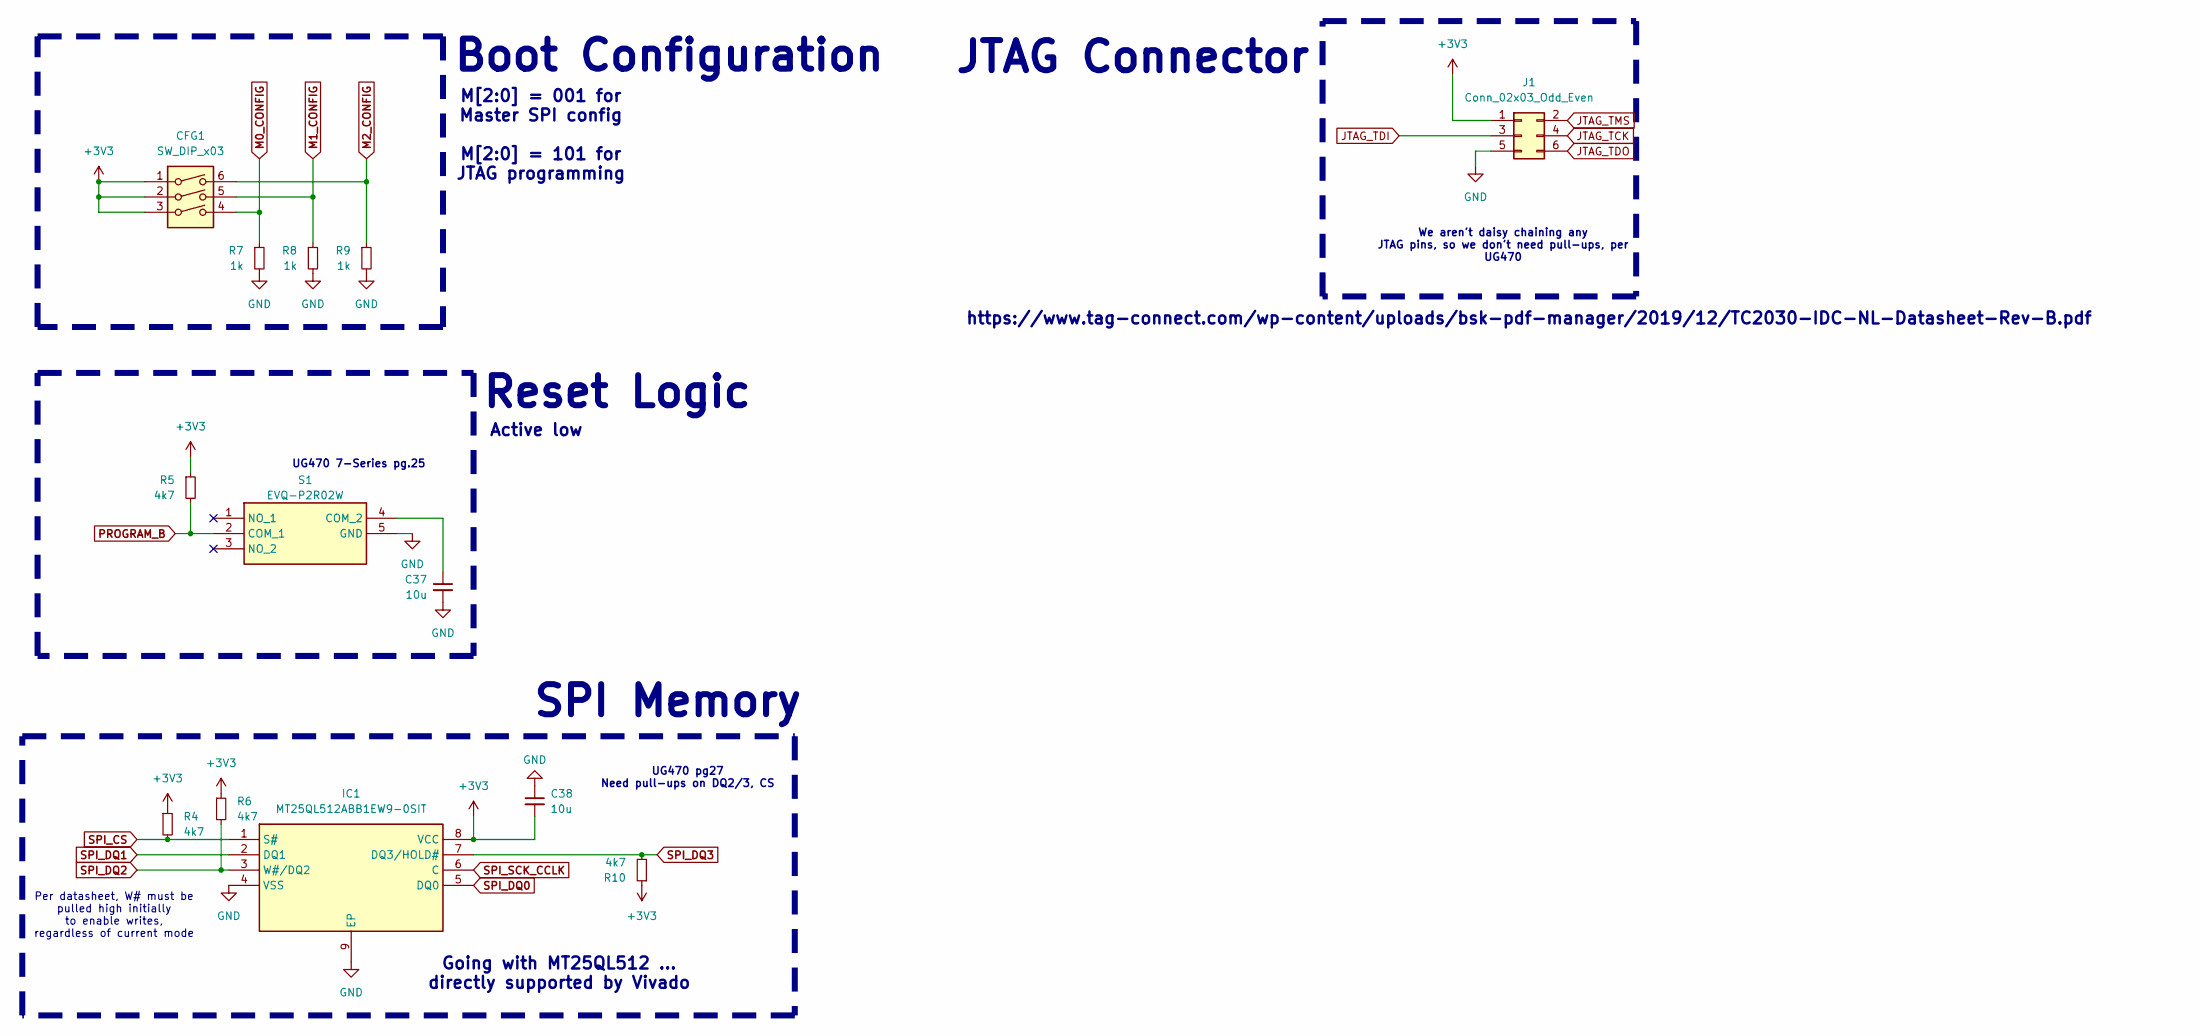
[picture p29: schematic peripherals.kicad_sch]

Parts:
C37, C38: 10u; C_0603_1608Metric
CFG1: SW_DIP_x03; WE-3-SPST-DIP
IC1: MT25QL512ABB1EW9-0SIT; Mouser Part Number 340-283908-TRAY
J1: Conn_02x03_Odd_Even; TAG_TC2030-IDC-NL
R4, R5, R6, R10: 4k7; R_0201_0603Metric
R7, R8, R9: 1k; R_0201_0603Metric
S1: EVQ-P2R02W; EVQP2R02W; Mouser Part Number 667-EVQ-P2R02W

Connections:
+3V3: C38.2, CFG1.1, CFG1.2, CFG1.3, IC1.8 (VCC), J1.1, R4.1, R5.1, R6.1, R10.1; also elsewhere on the board
GND: C37.2, C38.1, IC1.4 (VSS), IC1.9 (EP), J1.5, R7.2, R8.2, R9.2, S1.5 (GND); also elsewhere on the board
JTAG_TCK: J1.4; also elsewhere on the board
JTAG_TDI: J1.3; also elsewhere on the board
JTAG_TDO: J1.6; also elsewhere on the board
JTAG_TMS: J1.2; also elsewhere on the board
M0_CONFIG: CFG1.4, R7.1; also elsewhere on the board
M1_CONFIG: CFG1.5, R8.1; also elsewhere on the board
M2_CONFIG: CFG1.6, R9.1; also elsewhere on the board
unnamed: C37.1, S1.4 (COM_2)
PROGRAM_B: R5.2, S1.2 (COM_1); also elsewhere on the board
SPI_CS: IC1.1 (S#), R4.2; also elsewhere on the board
SPI_DQ0: IC1.5 (DQ0); also elsewhere on the board
SPI_DQ1: IC1.2 (DQ1); also elsewhere on the board
SPI_DQ2: IC1.3 (W#/DQ2), R6.2; also elsewhere on the board
SPI_DQ3: IC1.7 (DQ3/HOLD#), R10.2; also elsewhere on the board
SPI_SCK_CCLK: IC1.6 (C); also elsewhere on the board

Notes on the sheet:
Boot Configuration
https://www.tag-connect.com/wp-content/uploads/bsk-pdf-manager/2019/12/TC2030-IDC-NL-Datasheet-Rev-B.pdf
UG470 7-Series pg.25
M[2:0] = 001 for Master SPI config M[2:0] = 101 for JTAG programming
UG470 pg27 Need pull-ups on DQ2/3, CS
Reset Logic
JTAG Connector
Per datasheet, W# must be pulled high initially to enable writes, regardless of current mode
SPI Memory
Going with MT25QL512 ... directly supported by Vivado
Active low
We aren't daisy chaining any JTAG pins, so we don't need pull-ups, per UG470

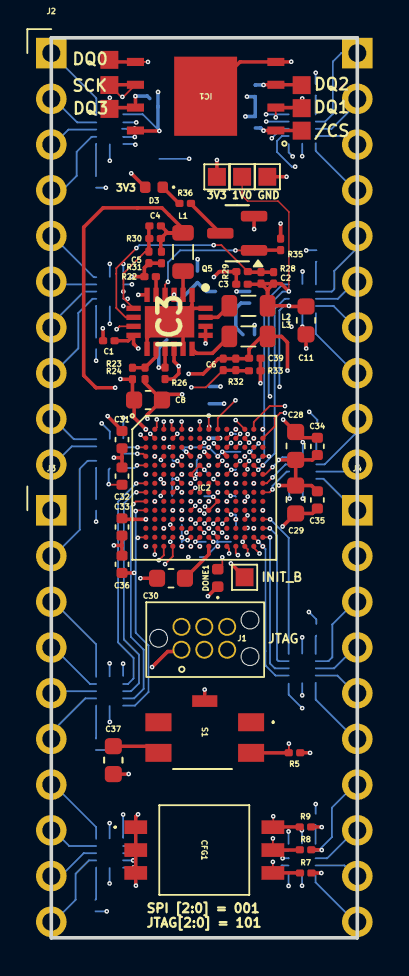
[picture p30: board sip-board.kicad_pcb from above]

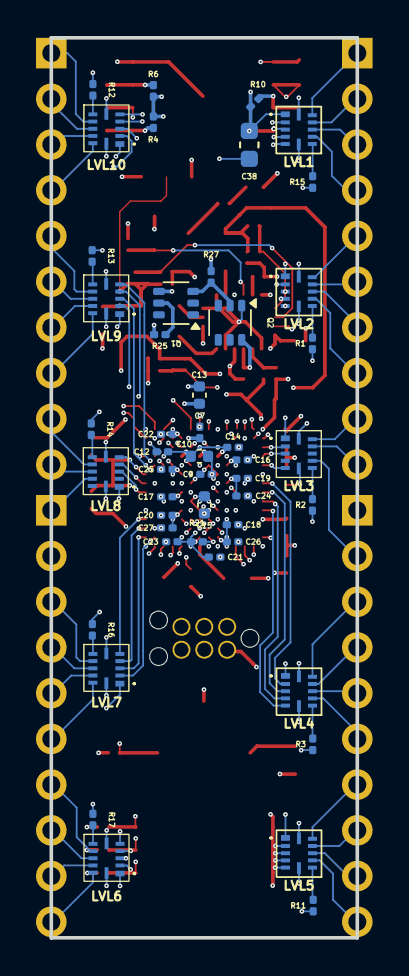
[picture p31: board sip-board.kicad_pcb from below]

Board: 10 copper layers, 17.0 x 50.0 mm, 109 parts (48 on the bottom side), 122 nets.
