hprd/z80-fpga-drop-in-replacement/Z80_Drop_In_2026/Z80_Drop_In_2026.runs/synth_1/.Xil/z80_top_with_mem_propImpl.xdc

set_property SRC_FILE_INFO {cfile:/home/user/Z80_Drop_In_2026/Z80_Drop_In_2026.srcs/constrs_1/new/PCB_Breakout_Constraints.xdc rfile:../../../Z80_Drop_In_2026.srcs/constrs_1/new/PCB_Breakout_Constraints.xdc id:1} [current_design]
set_property src_info {type:XDC file:1 line:4 export:INPUT save:INPUT read:READ} [current_design]
set_property CLOCK_DEDICATED_ROUTE FALSE [get_nets CLK_b_IBUF]
set_property src_info {type:XDC file:1 line:109 export:INPUT save:INPUT read:READ} [current_design]
set_property -dict  { PACKAGE_PIN "A14"   IOSTANDARD LVCMOS33   SLEW FAST } [get_ports {ADDRESS_BUS[8]}];                        # IO_L2N_T0_AD8N_15             Sch = GPIO_1_N
set_property src_info {type:XDC file:1 line:110 export:INPUT save:INPUT read:READ} [current_design]
set_property -dict  { PACKAGE_PIN "B14"   IOSTANDARD LVCMOS33   SLEW FAST } [get_ports {ADDRESS_BUS[7]}];                        # IO_L2P_T0_AD8P_15             Sch = GPIO_1_P
set_property src_info {type:XDC file:1 line:112 export:INPUT save:INPUT read:READ} [current_design]
set_property -dict  { PACKAGE_PIN "C2"    IOSTANDARD LVCMOS33   SLEW FAST } [get_ports {ADDRESS_BUS[2]}];                        # IO_L11P_T1_SRCC_35            Sch = GPIO_2_P
set_property src_info {type:XDC file:1 line:123 export:INPUT save:INPUT read:READ} [current_design]
set_property -dict  { PACKAGE_PIN "A4"    IOSTANDARD LVCMOS33   SLEW FAST } [get_ports {ADDRESS_BUS[6]}];                       # IO_L9N_T1_DQS_AD7N_35         Sch = GPIO_8_N
set_property src_info {type:XDC file:1 line:124 export:INPUT save:INPUT read:READ} [current_design]
set_property -dict  { PACKAGE_PIN "A5"    IOSTANDARD LVCMOS33   SLEW FAST } [get_ports {ADDRESS_BUS[5]}];                       # IO_L9P_T1_DQS_AD7P_35         Sch = GPIO_8_P
set_property src_info {type:XDC file:1 line:129 export:INPUT save:INPUT read:READ} [current_design]
set_property -dict  { PACKAGE_PIN "D1"    IOSTANDARD LVCMOS33   SLEW FAST } [get_ports {ADDRESS_BUS[1]}];                       # IO_L14N_T2_SRCC_35            Sch = GPIO_11_N
set_property src_info {type:XDC file:1 line:130 export:INPUT save:INPUT read:READ} [current_design]
set_property -dict  { PACKAGE_PIN "E1"    IOSTANDARD LVCMOS33   SLEW FAST } [get_ports {ADDRESS_BUS[0]}];                       # IO_L14P_T2_SRCC_35            Sch = GPIO_11_P
set_property src_info {type:XDC file:1 line:135 export:INPUT save:INPUT read:READ} [current_design]
set_property -dict  { PACKAGE_PIN "D6"    IOSTANDARD LVCMOS33   SLEW FAST } [get_ports {ADDRESS_BUS[4]}];                       # IO_L5N_T0_AD13N_35            Sch = GPIO_14_N
set_property src_info {type:XDC file:1 line:136 export:INPUT save:INPUT read:READ} [current_design]
set_property -dict  { PACKAGE_PIN "E6"    IOSTANDARD LVCMOS33   SLEW FAST } [get_ports {ADDRESS_BUS[3]}];                       # IO_L5P_T0_AD13P_35            Sch = GPIO_14_P
set_property src_info {type:XDC file:1 line:139 export:INPUT save:INPUT read:READ} [current_design]
set_property -dict  { PACKAGE_PIN "B4"    IOSTANDARD LVCMOS33   SLEW FAST } [get_ports {BUSRQ_b}];                       # IO_L7N_T1_AD6N_35             Sch = GPIO_16_N
set_property src_info {type:XDC file:1 line:140 export:INPUT save:INPUT read:READ} [current_design]
set_property -dict  { PACKAGE_PIN "C4"    IOSTANDARD LVCMOS33   SLEW FAST } [get_ports {RESET_b}];                       # IO_L7P_T1_AD6P_35             Sch = GPIO_16_P
set_property src_info {type:XDC file:1 line:151 export:INPUT save:INPUT read:READ} [current_design]
set_property -dict  { PACKAGE_PIN "D2"    IOSTANDARD LVCMOS33   SLEW FAST } [get_ports {RFSH_b}];                       # IO_L16N_T2_35                 Sch = GPIO_22_N
set_property src_info {type:XDC file:1 line:152 export:INPUT save:INPUT read:READ} [current_design]
set_property -dict  { PACKAGE_PIN "E2"    IOSTANDARD LVCMOS33   SLEW FAST } [get_ports {M1_b}];                       # IO_L16P_T2_35                 Sch = GPIO_22_P
set_property src_info {type:XDC file:1 line:163 export:INPUT save:INPUT read:READ} [current_design]
set_property -dict  { PACKAGE_PIN "A9"    IOSTANDARD LVCMOS33   SLEW FAST } [get_ports {ADDRESS_BUS[10]}];                       # IO_L12N_T1_MRCC_16            Sch = GPIO_28_N
set_property src_info {type:XDC file:1 line:164 export:INPUT save:INPUT read:READ} [current_design]
set_property -dict  { PACKAGE_PIN "A10"   IOSTANDARD LVCMOS33   SLEW FAST } [get_ports {ADDRESS_BUS[9]}];                       # IO_L12P_T1_MRCC_16            Sch = GPIO_28_P
set_property src_info {type:XDC file:1 line:165 export:INPUT save:INPUT read:READ} [current_design]
set_property -dict  { PACKAGE_PIN "H2"    IOSTANDARD LVCMOS33   SLEW FAST } [get_ports {WAIT_b}];                       # IO_L20N_T3_35                 Sch = GPIO_29_N
set_property src_info {type:XDC file:1 line:166 export:INPUT save:INPUT read:READ} [current_design]
set_property -dict  { PACKAGE_PIN "H3"    IOSTANDARD LVCMOS33   SLEW FAST } [get_ports {BUSACK_b}];                       # IO_L20P_T3_35                 Sch = GPIO_29_P
set_property src_info {type:XDC file:1 line:169 export:INPUT save:INPUT read:READ} [current_design]
set_property -dict  { PACKAGE_PIN "H4"    IOSTANDARD LVCMOS33   SLEW FAST } [get_ports {WR_b}];                       # IO_L22N_T3_35                 Sch = GPIO_31_N
set_property src_info {type:XDC file:1 line:170 export:INPUT save:INPUT read:READ} [current_design]
set_property -dict  { PACKAGE_PIN "H5"    IOSTANDARD LVCMOS33   SLEW FAST } [get_ports {RD_b}];                       # IO_L22P_T3_35                 Sch = GPIO_31_P
set_property src_info {type:XDC file:1 line:187 export:INPUT save:INPUT read:READ} [current_design]
set_property -dict  { PACKAGE_PIN "F13"   IOSTANDARD LVCMOS33   SLEW FAST } [get_ports {NMI_b}];                        # IO_L17P_T2_15                 Sch = GPIO_38_P
set_property src_info {type:XDC file:1 line:188 export:INPUT save:INPUT read:READ} [current_design]
set_property -dict  { PACKAGE_PIN "E13"   IOSTANDARD LVCMOS33   SLEW FAST } [get_ports {HALT_b}];                        # IO_L17N_T2_15                 Sch = GPIO_38_N
set_property src_info {type:XDC file:1 line:189 export:INPUT save:INPUT read:READ} [current_design]
set_property -dict  { PACKAGE_PIN "H15"   IOSTANDARD LVCMOS33   SLEW FAST } [get_ports {D[5]}];                       # IO_L18P_T2_15                 Sch = GPIO_39_P
set_property src_info {type:XDC file:1 line:190 export:INPUT save:INPUT read:READ} [current_design]
set_property -dict  { PACKAGE_PIN "G15"   IOSTANDARD LVCMOS33   SLEW FAST } [get_ports {D[6]}];                       # IO_L18N_T2_15                 Sch = GPIO_39_N
set_property src_info {type:XDC file:1 line:199 export:INPUT save:INPUT read:READ} [current_design]
set_property -dict  { PACKAGE_PIN "H18"   IOSTANDARD LVCMOS33   SLEW FAST } [get_ports {ADDRESS_BUS[15]}];                       # IO_L21P_T3_DQS_15             Sch = GPIO_44_P
set_property src_info {type:XDC file:1 line:200 export:INPUT save:INPUT read:READ} [current_design]
set_property -dict  { PACKAGE_PIN "G18"   IOSTANDARD LVCMOS33   SLEW FAST } [get_ports {CLK_b}];                       # IO_L21N_T3_DQS_15             Sch = GPIO_44_N
set_property src_info {type:XDC file:1 line:203 export:INPUT save:INPUT read:READ} [current_design]
set_property -dict  { PACKAGE_PIN "C17"   IOSTANDARD LVCMOS33   SLEW FAST } [get_ports {ADDRESS_BUS[11]}];                       # IO_L8P_T1_AD10P_15            Sch = GPIO_46_P
set_property src_info {type:XDC file:1 line:204 export:INPUT save:INPUT read:READ} [current_design]
set_property -dict  { PACKAGE_PIN "B18"   IOSTANDARD LVCMOS33   SLEW FAST } [get_ports {ADDRESS_BUS[12]}];                       # IO_L8N_T1_AD10N_15            Sch = GPIO_46_N
set_property src_info {type:XDC file:1 line:205 export:INPUT save:INPUT read:READ} [current_design]
set_property -dict  { PACKAGE_PIN "D16"   IOSTANDARD LVCMOS33   SLEW FAST } [get_ports {ADDRESS_BUS[13]}];                       # IO_L9P_T1_DQS_AD3P_15         Sch = GPIO_47_P
set_property src_info {type:XDC file:1 line:206 export:INPUT save:INPUT read:READ} [current_design]
set_property -dict  { PACKAGE_PIN "D17"   IOSTANDARD LVCMOS33   SLEW FAST } [get_ports {ADDRESS_BUS[14]}];                       # IO_L9N_T1_DQS_AD3N_15         Sch = GPIO_47_N
set_property src_info {type:XDC file:1 line:207 export:INPUT save:INPUT read:READ} [current_design]
set_property -dict  { PACKAGE_PIN "E16"   IOSTANDARD LVCMOS33   SLEW FAST } [get_ports {D[4]}];                       # IO_L10P_T1_AD11P_15           Sch = GPIO_48_P
set_property src_info {type:XDC file:1 line:208 export:INPUT save:INPUT read:READ} [current_design]
set_property -dict  { PACKAGE_PIN "E17"   IOSTANDARD LVCMOS33   SLEW FAST } [get_ports {D[3]}];                       # IO_L10N_T1_AD11N_15           Sch = GPIO_48_N
set_property src_info {type:XDC file:1 line:217 export:INPUT save:INPUT read:READ} [current_design]
set_property -dict  { PACKAGE_PIN "C10"   IOSTANDARD LVCMOS33   SLEW FAST } [get_ports {D[7]}];                       # IO_L11P_T1_SRCC_16            Sch = GPIO_53_P
set_property src_info {type:XDC file:1 line:218 export:INPUT save:INPUT read:READ} [current_design]
set_property -dict  { PACKAGE_PIN "C9"    IOSTANDARD LVCMOS33   SLEW FAST } [get_ports {D[0]}];                       # IO_L11N_T1_SRCC_16            Sch = GPIO_53_N
set_property src_info {type:XDC file:1 line:221 export:INPUT save:INPUT read:READ} [current_design]
set_property -dict  { PACKAGE_PIN "V14"   IOSTANDARD LVCMOS33   SLEW FAST } [get_ports {MREQ_b}];                       # IO_L20P_T3_D24_14             Sch = GPIO_55_P
set_property src_info {type:XDC file:1 line:222 export:INPUT save:INPUT read:READ} [current_design]
set_property -dict  { PACKAGE_PIN "V15"   IOSTANDARD LVCMOS33   SLEW FAST } [get_ports {IORQ_b}];                       # IO_L20N_T3_D23_14             Sch = GPIO_55_N
set_property src_info {type:XDC file:1 line:225 export:INPUT save:INPUT read:READ} [current_design]
set_property -dict  { PACKAGE_PIN "T12"   IOSTANDARD LVCMOS33   SLEW FAST } [get_ports {D[1]}];                       # IO_L22P_T3_D21_14             Sch = GPIO_57_P
set_property src_info {type:XDC file:1 line:226 export:INPUT save:INPUT read:READ} [current_design]
set_property -dict  { PACKAGE_PIN "T13"   IOSTANDARD LVCMOS33   SLEW FAST } [get_ports {INT_b}];                       # IO_L22N_T3_D20_14             Sch = GPIO_57_N
set_property src_info {type:XDC file:1 line:233 export:INPUT save:INPUT read:READ} [current_design]
set_property -dict  { PACKAGE_PIN "U17"   IOSTANDARD LVCMOS33   SLEW FAST } [get_ports {D[2]}];                       # IO_L15P_T2_DQS_RDWR_B_14      Sch = GPIO_61_P
