hprd/z80-fpga-drop-in-replacement/Z80_Drop_In_2026/Z80_Drop_In_2026.cache/ip/2023.1/2/b/2b9264c0e7119477/blk_mem_gen_0_stub.v

// Copyright 1986-2022 Xilinx, Inc. All Rights Reserved.
// Copyright 2022-2023 Advanced Micro Devices, Inc. All Rights Reserved.
// --------------------------------------------------------------------------------
// Tool Version: Vivado v.2023.1 (lin64) Build 3865809 Sun May  7 15:04:56 MDT 2023
// Date        : Thu Feb 26 19:26:40 2026
// Host        : ff1013d0903a running 64-bit Ubuntu 22.04.4 LTS
// Command     : write_verilog -force -mode synth_stub -rename_top decalper_eb_ot_sdeen_pot_pi_dehcac_xnilix -prefix
//               decalper_eb_ot_sdeen_pot_pi_dehcac_xnilix_ blk_mem_gen_0_stub.v
// Design      : blk_mem_gen_0
// Purpose     : Stub declaration of top-level module interface
// Device      : xc7s50csga324-1
// --------------------------------------------------------------------------------

// This empty module with port declaration file causes synthesis tools to infer a black box for IP.
// The synthesis directives are for Synopsys Synplify support to prevent IO buffer insertion.
// Please paste the declaration into a Verilog source file or add the file as an additional source.
(* x_core_info = "blk_mem_gen_v8_4_6,Vivado 2023.1" *)
module decalper_eb_ot_sdeen_pot_pi_dehcac_xnilix(clka, ena, wea, addra, dina, douta)
/* synthesis syn_black_box black_box_pad_pin="ena,wea[0:0],addra[7:0],dina[7:0],douta[7:0]" */
/* synthesis syn_force_seq_prim="clka" */;
  input clka /* synthesis syn_isclock = 1 */;
  input ena;
  input [0:0]wea;
  input [7:0]addra;
  input [7:0]dina;
  output [7:0]douta;
endmodule
