hprd/z80-fpga-drop-in-replacement/Z80_Drop_In_2026/Z80_Drop_In_2026.cache/ip/2023.1/2/b/2b9264c0e7119477/blk_mem_gen_0_stub.vhdl

-- Copyright 1986-2022 Xilinx, Inc. All Rights Reserved.
-- Copyright 2022-2023 Advanced Micro Devices, Inc. All Rights Reserved.
-- --------------------------------------------------------------------------------
-- Tool Version: Vivado v.2023.1 (lin64) Build 3865809 Sun May  7 15:04:56 MDT 2023
-- Date        : Thu Feb 26 19:26:41 2026
-- Host        : ff1013d0903a running 64-bit Ubuntu 22.04.4 LTS
-- Command     : write_vhdl -force -mode synth_stub -rename_top decalper_eb_ot_sdeen_pot_pi_dehcac_xnilix -prefix
--               decalper_eb_ot_sdeen_pot_pi_dehcac_xnilix_ blk_mem_gen_0_stub.vhdl
-- Design      : blk_mem_gen_0
-- Purpose     : Stub declaration of top-level module interface
-- Device      : xc7s50csga324-1
-- --------------------------------------------------------------------------------
library IEEE;
use IEEE.STD_LOGIC_1164.ALL;

entity decalper_eb_ot_sdeen_pot_pi_dehcac_xnilix is
  Port ( 
    clka : in STD_LOGIC;
    ena : in STD_LOGIC;
    wea : in STD_LOGIC_VECTOR ( 0 to 0 );
    addra : in STD_LOGIC_VECTOR ( 7 downto 0 );
    dina : in STD_LOGIC_VECTOR ( 7 downto 0 );
    douta : out STD_LOGIC_VECTOR ( 7 downto 0 )
  );

end decalper_eb_ot_sdeen_pot_pi_dehcac_xnilix;

architecture stub of decalper_eb_ot_sdeen_pot_pi_dehcac_xnilix is
attribute syn_black_box : boolean;
attribute black_box_pad_pin : string;
attribute syn_black_box of stub : architecture is true;
attribute black_box_pad_pin of stub : architecture is "clka,ena,wea[0:0],addra[7:0],dina[7:0],douta[7:0]";
attribute x_core_info : string;
attribute x_core_info of stub : architecture is "blk_mem_gen_v8_4_6,Vivado 2023.1";
begin
end;
