hprd/z80-fpga-drop-in-replacement/Z80_Drop_In_2026/Z80_Drop_In_2026.cache/ip/2023.1/2/b/2b9264c0e7119477/blk_mem_gen_0_sim_netlist.v

// Copyright 1986-2022 Xilinx, Inc. All Rights Reserved.
// Copyright 2022-2023 Advanced Micro Devices, Inc. All Rights Reserved.
// --------------------------------------------------------------------------------
// Tool Version: Vivado v.2023.1 (lin64) Build 3865809 Sun May  7 15:04:56 MDT 2023
// Date        : Thu Feb 26 19:26:41 2026
// Host        : ff1013d0903a running 64-bit Ubuntu 22.04.4 LTS
// Command     : write_verilog -force -mode funcsim -rename_top decalper_eb_ot_sdeen_pot_pi_dehcac_xnilix -prefix
//               decalper_eb_ot_sdeen_pot_pi_dehcac_xnilix_ blk_mem_gen_0_sim_netlist.v
// Design      : blk_mem_gen_0
// Purpose     : This verilog netlist is a functional simulation representation of the design and should not be modified
//               or synthesized. This netlist cannot be used for SDF annotated simulation.
// Device      : xc7s50csga324-1
// --------------------------------------------------------------------------------
`timescale 1 ps / 1 ps

(* CHECK_LICENSE_TYPE = "blk_mem_gen_0,blk_mem_gen_v8_4_6,{}" *) (* downgradeipidentifiedwarnings = "yes" *) (* x_core_info = "blk_mem_gen_v8_4_6,Vivado 2023.1" *) 
(* NotValidForBitStream *)
module decalper_eb_ot_sdeen_pot_pi_dehcac_xnilix
   (clka,
    ena,
    wea,
    addra,
    dina,
    douta);
  (* x_interface_info = "xilinx.com:interface:bram:1.0 BRAM_PORTA CLK" *) (* x_interface_parameter = "XIL_INTERFACENAME BRAM_PORTA, MEM_SIZE 8192, MEM_WIDTH 32, MEM_ECC NONE, MASTER_TYPE OTHER, READ_LATENCY 1" *) input clka;
  (* x_interface_info = "xilinx.com:interface:bram:1.0 BRAM_PORTA EN" *) input ena;
  (* x_interface_info = "xilinx.com:interface:bram:1.0 BRAM_PORTA WE" *) input [0:0]wea;
  (* x_interface_info = "xilinx.com:interface:bram:1.0 BRAM_PORTA ADDR" *) input [7:0]addra;
  (* x_interface_info = "xilinx.com:interface:bram:1.0 BRAM_PORTA DIN" *) input [7:0]dina;
  (* x_interface_info = "xilinx.com:interface:bram:1.0 BRAM_PORTA DOUT" *) output [7:0]douta;

  wire [7:0]addra;
  wire clka;
  wire [7:0]dina;
  wire [7:0]douta;
  wire ena;
  wire [0:0]wea;
  wire NLW_U0_dbiterr_UNCONNECTED;
  wire NLW_U0_rsta_busy_UNCONNECTED;
  wire NLW_U0_rstb_busy_UNCONNECTED;
  wire NLW_U0_s_axi_arready_UNCONNECTED;
  wire NLW_U0_s_axi_awready_UNCONNECTED;
  wire NLW_U0_s_axi_bvalid_UNCONNECTED;
  wire NLW_U0_s_axi_dbiterr_UNCONNECTED;
  wire NLW_U0_s_axi_rlast_UNCONNECTED;
  wire NLW_U0_s_axi_rvalid_UNCONNECTED;
  wire NLW_U0_s_axi_sbiterr_UNCONNECTED;
  wire NLW_U0_s_axi_wready_UNCONNECTED;
  wire NLW_U0_sbiterr_UNCONNECTED;
  wire [7:0]NLW_U0_doutb_UNCONNECTED;
  wire [7:0]NLW_U0_rdaddrecc_UNCONNECTED;
  wire [3:0]NLW_U0_s_axi_bid_UNCONNECTED;
  wire [1:0]NLW_U0_s_axi_bresp_UNCONNECTED;
  wire [7:0]NLW_U0_s_axi_rdaddrecc_UNCONNECTED;
  wire [7:0]NLW_U0_s_axi_rdata_UNCONNECTED;
  wire [3:0]NLW_U0_s_axi_rid_UNCONNECTED;
  wire [1:0]NLW_U0_s_axi_rresp_UNCONNECTED;

  (* C_ADDRA_WIDTH = "8" *) 
  (* C_ADDRB_WIDTH = "8" *) 
  (* C_ALGORITHM = "1" *) 
  (* C_AXI_ID_WIDTH = "4" *) 
  (* C_AXI_SLAVE_TYPE = "0" *) 
  (* C_AXI_TYPE = "1" *) 
  (* C_BYTE_SIZE = "9" *) 
  (* C_COMMON_CLK = "0" *) 
  (* C_COUNT_18K_BRAM = "1" *) 
  (* C_COUNT_36K_BRAM = "0" *) 
  (* C_CTRL_ECC_ALGO = "NONE" *) 
  (* C_DEFAULT_DATA = "0" *) 
  (* C_DISABLE_WARN_BHV_COLL = "0" *) 
  (* C_DISABLE_WARN_BHV_RANGE = "0" *) 
  (* C_ELABORATION_DIR = "./" *) 
  (* C_ENABLE_32BIT_ADDRESS = "0" *) 
  (* C_EN_DEEPSLEEP_PIN = "0" *) 
  (* C_EN_ECC_PIPE = "0" *) 
  (* C_EN_RDADDRA_CHG = "0" *) 
  (* C_EN_RDADDRB_CHG = "0" *) 
  (* C_EN_SAFETY_CKT = "0" *) 
  (* C_EN_SHUTDOWN_PIN = "0" *) 
  (* C_EN_SLEEP_PIN = "0" *) 
  (* C_EST_POWER_SUMMARY = "Estimated Power for IP     :     2.3883 mW" *) 
  (* C_FAMILY = "spartan7" *) 
  (* C_HAS_AXI_ID = "0" *) 
  (* C_HAS_ENA = "1" *) 
  (* C_HAS_ENB = "0" *) 
  (* C_HAS_INJECTERR = "0" *) 
  (* C_HAS_MEM_OUTPUT_REGS_A = "0" *) 
  (* C_HAS_MEM_OUTPUT_REGS_B = "0" *) 
  (* C_HAS_MUX_OUTPUT_REGS_A = "0" *) 
  (* C_HAS_MUX_OUTPUT_REGS_B = "0" *) 
  (* C_HAS_REGCEA = "0" *) 
  (* C_HAS_REGCEB = "0" *) 
  (* C_HAS_RSTA = "0" *) 
  (* C_HAS_RSTB = "0" *) 
  (* C_HAS_SOFTECC_INPUT_REGS_A = "0" *) 
  (* C_HAS_SOFTECC_OUTPUT_REGS_B = "0" *) 
  (* C_INITA_VAL = "0" *) 
  (* C_INITB_VAL = "0" *) 
  (* C_INIT_FILE = "blk_mem_gen_0.mem" *) 
  (* C_INIT_FILE_NAME = "blk_mem_gen_0.mif" *) 
  (* C_INTERFACE_TYPE = "0" *) 
  (* C_LOAD_INIT_FILE = "1" *) 
  (* C_MEM_TYPE = "0" *) 
  (* C_MUX_PIPELINE_STAGES = "0" *) 
  (* C_PRIM_TYPE = "1" *) 
  (* C_READ_DEPTH_A = "256" *) 
  (* C_READ_DEPTH_B = "256" *) 
  (* C_READ_LATENCY_A = "1" *) 
  (* C_READ_LATENCY_B = "1" *) 
  (* C_READ_WIDTH_A = "8" *) 
  (* C_READ_WIDTH_B = "8" *) 
  (* C_RSTRAM_A = "0" *) 
  (* C_RSTRAM_B = "0" *) 
  (* C_RST_PRIORITY_A = "CE" *) 
  (* C_RST_PRIORITY_B = "CE" *) 
  (* C_SIM_COLLISION_CHECK = "ALL" *) 
  (* C_USE_BRAM_BLOCK = "0" *) 
  (* C_USE_BYTE_WEA = "0" *) 
  (* C_USE_BYTE_WEB = "0" *) 
  (* C_USE_DEFAULT_DATA = "1" *) 
  (* C_USE_ECC = "0" *) 
  (* C_USE_SOFTECC = "0" *) 
  (* C_USE_URAM = "0" *) 
  (* C_WEA_WIDTH = "1" *) 
  (* C_WEB_WIDTH = "1" *) 
  (* C_WRITE_DEPTH_A = "256" *) 
  (* C_WRITE_DEPTH_B = "256" *) 
  (* C_WRITE_MODE_A = "NO_CHANGE" *) 
  (* C_WRITE_MODE_B = "WRITE_FIRST" *) 
  (* C_WRITE_WIDTH_A = "8" *) 
  (* C_WRITE_WIDTH_B = "8" *) 
  (* C_XDEVICEFAMILY = "spartan7" *) 
  (* downgradeipidentifiedwarnings = "yes" *) 
  (* is_du_within_envelope = "true" *) 
  decalper_eb_ot_sdeen_pot_pi_dehcac_xnilix_blk_mem_gen_v8_4_6 U0
       (.addra(addra),
        .addrb({1'b0,1'b0,1'b0,1'b0,1'b0,1'b0,1'b0,1'b0}),
        .clka(clka),
        .clkb(1'b0),
        .dbiterr(NLW_U0_dbiterr_UNCONNECTED),
        .deepsleep(1'b0),
        .dina(dina),
        .dinb({1'b0,1'b0,1'b0,1'b0,1'b0,1'b0,1'b0,1'b0}),
        .douta(douta),
        .doutb(NLW_U0_doutb_UNCONNECTED[7:0]),
        .eccpipece(1'b0),
        .ena(ena),
        .enb(1'b0),
        .injectdbiterr(1'b0),
        .injectsbiterr(1'b0),
        .rdaddrecc(NLW_U0_rdaddrecc_UNCONNECTED[7:0]),
        .regcea(1'b0),
        .regceb(1'b0),
        .rsta(1'b0),
        .rsta_busy(NLW_U0_rsta_busy_UNCONNECTED),
        .rstb(1'b0),
        .rstb_busy(NLW_U0_rstb_busy_UNCONNECTED),
        .s_aclk(1'b0),
        .s_aresetn(1'b0),
        .s_axi_araddr({1'b0,1'b0,1'b0,1'b0,1'b0,1'b0,1'b0,1'b0,1'b0,1'b0,1'b0,1'b0,1'b0,1'b0,1'b0,1'b0,1'b0,1'b0,1'b0,1'b0,1'b0,1'b0,1'b0,1'b0,1'b0,1'b0,1'b0,1'b0,1'b0,1'b0,1'b0,1'b0}),
        .s_axi_arburst({1'b0,1'b0}),
        .s_axi_arid({1'b0,1'b0,1'b0,1'b0}),
        .s_axi_arlen({1'b0,1'b0,1'b0,1'b0,1'b0,1'b0,1'b0,1'b0}),
        .s_axi_arready(NLW_U0_s_axi_arready_UNCONNECTED),
        .s_axi_arsize({1'b0,1'b0,1'b0}),
        .s_axi_arvalid(1'b0),
        .s_axi_awaddr({1'b0,1'b0,1'b0,1'b0,1'b0,1'b0,1'b0,1'b0,1'b0,1'b0,1'b0,1'b0,1'b0,1'b0,1'b0,1'b0,1'b0,1'b0,1'b0,1'b0,1'b0,1'b0,1'b0,1'b0,1'b0,1'b0,1'b0,1'b0,1'b0,1'b0,1'b0,1'b0}),
        .s_axi_awburst({1'b0,1'b0}),
        .s_axi_awid({1'b0,1'b0,1'b0,1'b0}),
        .s_axi_awlen({1'b0,1'b0,1'b0,1'b0,1'b0,1'b0,1'b0,1'b0}),
        .s_axi_awready(NLW_U0_s_axi_awready_UNCONNECTED),
        .s_axi_awsize({1'b0,1'b0,1'b0}),
        .s_axi_awvalid(1'b0),
        .s_axi_bid(NLW_U0_s_axi_bid_UNCONNECTED[3:0]),
        .s_axi_bready(1'b0),
        .s_axi_bresp(NLW_U0_s_axi_bresp_UNCONNECTED[1:0]),
        .s_axi_bvalid(NLW_U0_s_axi_bvalid_UNCONNECTED),
        .s_axi_dbiterr(NLW_U0_s_axi_dbiterr_UNCONNECTED),
        .s_axi_injectdbiterr(1'b0),
        .s_axi_injectsbiterr(1'b0),
        .s_axi_rdaddrecc(NLW_U0_s_axi_rdaddrecc_UNCONNECTED[7:0]),
        .s_axi_rdata(NLW_U0_s_axi_rdata_UNCONNECTED[7:0]),
        .s_axi_rid(NLW_U0_s_axi_rid_UNCONNECTED[3:0]),
        .s_axi_rlast(NLW_U0_s_axi_rlast_UNCONNECTED),
        .s_axi_rready(1'b0),
        .s_axi_rresp(NLW_U0_s_axi_rresp_UNCONNECTED[1:0]),
        .s_axi_rvalid(NLW_U0_s_axi_rvalid_UNCONNECTED),
        .s_axi_sbiterr(NLW_U0_s_axi_sbiterr_UNCONNECTED),
        .s_axi_wdata({1'b0,1'b0,1'b0,1'b0,1'b0,1'b0,1'b0,1'b0}),
        .s_axi_wlast(1'b0),
        .s_axi_wready(NLW_U0_s_axi_wready_UNCONNECTED),
        .s_axi_wstrb(1'b0),
        .s_axi_wvalid(1'b0),
        .sbiterr(NLW_U0_sbiterr_UNCONNECTED),
        .shutdown(1'b0),
        .sleep(1'b0),
        .wea(wea),
        .web(1'b0));
endmodule
`pragma protect begin_protected
`pragma protect version = 1
`pragma protect encrypt_agent = "XILINX"
`pragma protect encrypt_agent_info = "Xilinx Encryption Tool 2023.1"
`pragma protect key_keyowner="Synopsys", key_keyname="SNPS-VCS-RSA-2", key_method="rsa"
`pragma protect encoding = (enctype="BASE64", line_length=76, bytes=128)
`pragma protect key_block
aMT3usC6uizzcwnzOCX4OsS16Ob+YxFcsGovFpFklbnaIaD1S0lVdxenTwHPp6ByIEi+ehwr6Rgg
z/3AlTheI5NFTM8ihiMA18/wmUxI7EbaftJACA1LykUKCuj5myy0T+DACuv3sGYIZS38TZTZnnBC
FGAlvTZmRWs+JzneH3o=

`pragma protect key_keyowner="Aldec", key_keyname="ALDEC15_001", key_method="rsa"
`pragma protect encoding = (enctype="BASE64", line_length=76, bytes=256)
`pragma protect key_block
lR9ZerhYSAb39nzEkeYvhnwEs5t9y/+yTDf8KuoUtR1BGeHZq8pA/YxtjzQLtaOW1R1IQUb0FtSI
e3CYAb7WHYbIjcpw3vKHvW1SqcGn9CMGa556CYKmD2oF12Kow8xRaFvMSBUVxX7HsHxNWnRd+PU1
+C0YayU2KFIY/7Yl6cZ5luAzhw/6SW3PFYUIyyqWy5MCIXweHOwQR2IpQEdlDur5nluN7i7BeB+i
fxwwHh8TU/g7T4mhZFkiTuBKdLAtQOjxWxzqTMxgcuAjlTylY16FgMFOASdvvSbqBZJjbxMdVloU
rYjS8O/8rWktv8GXcaIdBJ2BRj01q7jsChsbwA==

`pragma protect key_keyowner="Mentor Graphics Corporation", key_keyname="MGC-VELOCE-RSA", key_method="rsa"
`pragma protect encoding = (enctype="BASE64", line_length=76, bytes=128)
`pragma protect key_block
Qvl63GHz9mq2xOB7elt/vAQ7URLGdD1Lkcz7f3Wtw31dwjjjbP62Ny/Jr6OmBIheWlgejx38qxAT
TrHiiEyjKmGcnPn1Tn2n+cH4RAxCbOFnCI9n6+YsYMTe9JkplGhGGr39SkFgJz0I2IKpPsuqTjCj
rhf49TAryNMQeRpREJA=

`pragma protect key_keyowner="Mentor Graphics Corporation", key_keyname="MGC-VERIF-SIM-RSA-2", key_method="rsa"
`pragma protect encoding = (enctype="BASE64", line_length=76, bytes=256)
`pragma protect key_block
MA+9Ro+dh339m0iZrkKbqTKN8gQ5xkxN/SPCfhkOn+5jjgCTS5IOKLHil+HsZDjX333ebxnornwG
MOBxyEdFfLM8SA+bs2r41J/j0af2VVMmCM3hOh8JmZxB4X9Jg/glegNCbvwzqxMbOQNEy+zt7j5t
TFVD82RtPFmYVVYZZyll/WvAA+0aVpyjzLCIM1GznFky0RWLv65Wp4MJJnNRRrtG3muMznVO/u2s
tACsJ9jzv9M0IlMYjYH9BixhG6cZX02I4LEXXaPkhdOINlMMhsbArXtc9NphzmS4bY1/1yF1D6YD
EKLyS2Sr3HDl0O/lefN+jvfG8iKuVl55PNNrVQ==

`pragma protect key_keyowner="Real Intent", key_keyname="RI-RSA-KEY-1", key_method="rsa"
`pragma protect encoding = (enctype="BASE64", line_length=76, bytes=256)
`pragma protect key_block
wpMTg7STjFkUDhOqdNPa0FHXTnHQgKmhvqDv+rRVBvMiQ8O7u8oj7ibITq3o+jugJsMJ60B410gQ
JFTcqCJKYmYJvqi8rPLLOYDmFG6ZLP/Ixr3n62IyIaCeDltBahi3yV009QN0X+iuzuFCL+Y7g9ff
IvAgyBly+Z3Itv2H9EJMZPMl17Sa7IkgjmWqzVXIKNMKn0iDVYsQw6ZgzQDYQ8N8IvTIEggU3/lh
6Nf0hV0ev3qOv/2P+4w0U766Ux3yLuzPJSI7bKm3/ip9NjhOytxOiKKqVXhKG8dzbbuS5u3EE/eq
q6YxkL7gpvNltVqqBnJB6vHSyWrD6+MqsCtR9A==

`pragma protect key_keyowner="Xilinx", key_keyname="xilinxt_2022_10", key_method="rsa"
`pragma protect encoding = (enctype="BASE64", line_length=76, bytes=256)
`pragma protect key_block
Q7Q4SSp70lxFryaopuic9VVP/Ire0pSsPEIMYdURBAczC7ShkuYeV02U7L3BlAiyBE4vBKcwYSQd
cWiaj8sVP7q4kxoRHKxLV1R5PIO6l4DsLWE2E+1MLyUPME0w5KTular/oX8EPCJ5n/8VCtW7x4Vf
dpeyki1/IAPJkAyi3zVZKHzgKhEwnZaZZtZYuMWoPZMt4V38sAcE42Raf+7yfFWG5HO74JY6iEnW
gJeRk58K+avB/XLF2/j2RQZfjTYizrprT2tUMBK6e7DRWZZtk8AOcsMhUikev44IFGNbNXjP8BXC
0J3y3P7pCFT6l+saU83nRwi/H25fSA34diJtNw==

`pragma protect key_keyowner="Metrics Technologies Inc.", key_keyname="DSim", key_method="rsa"
`pragma protect encoding = (enctype="BASE64", line_length=76, bytes=256)
`pragma protect key_block
a/8ooC+s+6nfvfa1+oBhsvYWLJjFgp83DI1kNyOi5Am+ugPbGRmgGZudfyo6yw6Yd5gGbLm5aToQ
5G4cGF5HaXD5TU6A0ZZFMTIbzFLE76JMjjIxX8JcaJIZpSmrXqlru8l5gDINUEAmwUY3mRQnjcGJ
0Z+kMRH8iAEF+gEviPiFZSBbJeOPqivIS217kimQJX3BeNbNPQTP+GUidcRywpGMh5avxtA0kDRO
F9SoCSyTm9hr2v9hsK1IUAYQLb7n2/R+z5YNKNzt1oN4qgJH1wZfdI8if2K8+ohyOdnxrrgJOWdj
cOqr7cGqEOYfBMTIQeHVZzb7NGWVN+9B8XSUaQ==

`pragma protect key_keyowner="Atrenta", key_keyname="ATR-SG-RSA-1", key_method="rsa"
`pragma protect encoding = (enctype="BASE64", line_length=76, bytes=384)
`pragma protect key_block
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

`pragma protect key_keyowner="Cadence Design Systems.", key_keyname="CDS_RSA_KEY_VER_1", key_method="rsa"
`pragma protect encoding = (enctype="BASE64", line_length=76, bytes=256)
`pragma protect key_block
fphquQOeFuqByo36Gh2C1zEC1J6u9swSMbMzsKldIvLm+SZ6/hr/N8KJ/G2vBABzX6UtbVuP1ZXx
AxdftP4Aqis1B3Bs6989aQG9eo0SOHA7r6aFLtFb3qoD5Pvqw4aVNU4z4EtTpFpn/jCWD21lKROf
q5X32HRfFq1jwqod+9vIbUNRRzz5y9VHvXfacZlxDazSPmcCF4hxB1KqWqT44KmYVkDedgkgnYgb
ZGidHnTb3W7C8tSqC9ac4kNJCL429QndtddweESJNlpX+65pt9Irok9pkOodwoj0QScswOIFjhBZ
/GrzZLQcFWiD3gXRU4DazzxQnGdRH4qEIRWziw==

`pragma protect key_keyowner="Synplicity", key_keyname="SYNP15_1", key_method="rsa"
`pragma protect encoding = (enctype="BASE64", line_length=76, bytes=256)
`pragma protect key_block
1lUYYHPCt1BUJOvcBbgMU2GSQiqfxItz4ntieMaenjrtsE9SLwaU6xB0tBl8Atw5yP/RRNww1kX/
9uZbTz5He3r9mPVt+mGxB4N3f9BbCrQRb4USVPgKO/+vWUfMQERGklScy0+fz75WuxH74CjRUoDI
8iyssb2cUNnfDe13jIoI8gM1w4w/Pkxkmb6Mef53QMxacHAWEZeytcH3fuL/adO263D8P90U3XJv
vBXJmbjkRVi9qzjBzfMxuOy2KbZaZgR3BLzaffIfFnMwg/Rb8sGls5pQsZv5jL2wk3+Bj3OXBYdd
pDyjGoalJBzObKzd/t15kNHwY4FXYFcZLQPncw==

`pragma protect key_keyowner="Mentor Graphics Corporation", key_keyname="MGC-PREC-RSA", key_method="rsa"
`pragma protect encoding = (enctype="BASE64", line_length=76, bytes=256)
`pragma protect key_block
YRmSEzaa2WFVvMH1BwWc1TIUpVbzSEIP0VbI6n0sEgct/X4PiTfMQmK1jBVCaISIzwBxscKQwZOt
mb/nmINGg6I7ih39LSbBMtx6cdCUiyaLkPeRbqfyPpKhvnUIFmdKVvTd1dYzxeOeuDnhSVaBaAcN
3lngSg7lIbmhLIGjC29yQrBTiLArbVZi6IRGronMK51e3UrYa6GspsznhiuRcXjEb4bHKrJ2CM5Z
BUwA+E9949sQgyOagFZbLVle2ESbwBaoxcAPn2gxfRHlT0leqyLgUGDZLsfArzGzw9BTGzyEG2TR
XOrKFNYRfMXMrnGsBM7acIelY4LdAMgsKgDH/A==

`pragma protect data_method = "AES128-CBC"
`pragma protect encoding = (enctype = "BASE64", line_length = 76, bytes = 20896)
`pragma protect data_block
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
`pragma protect end_protected
`ifndef GLBL
`define GLBL
`timescale  1 ps / 1 ps

module glbl ();

    parameter ROC_WIDTH = 100000;
    parameter TOC_WIDTH = 0;
    parameter GRES_WIDTH = 10000;
    parameter GRES_START = 10000;

//--------   STARTUP Globals --------------
    wire GSR;
    wire GTS;
    wire GWE;
    wire PRLD;
    wire GRESTORE;
    tri1 p_up_tmp;
    tri (weak1, strong0) PLL_LOCKG = p_up_tmp;

    wire PROGB_GLBL;
    wire CCLKO_GLBL;
    wire FCSBO_GLBL;
    wire [3:0] DO_GLBL;
    wire [3:0] DI_GLBL;
   
    reg GSR_int;
    reg GTS_int;
    reg PRLD_int;
    reg GRESTORE_int;

//--------   JTAG Globals --------------
    wire JTAG_TDO_GLBL;
    wire JTAG_TCK_GLBL;
    wire JTAG_TDI_GLBL;
    wire JTAG_TMS_GLBL;
    wire JTAG_TRST_GLBL;

    reg JTAG_CAPTURE_GLBL;
    reg JTAG_RESET_GLBL;
    reg JTAG_SHIFT_GLBL;
    reg JTAG_UPDATE_GLBL;
    reg JTAG_RUNTEST_GLBL;

    reg JTAG_SEL1_GLBL = 0;
    reg JTAG_SEL2_GLBL = 0 ;
    reg JTAG_SEL3_GLBL = 0;
    reg JTAG_SEL4_GLBL = 0;

    reg JTAG_USER_TDO1_GLBL = 1'bz;
    reg JTAG_USER_TDO2_GLBL = 1'bz;
    reg JTAG_USER_TDO3_GLBL = 1'bz;
    reg JTAG_USER_TDO4_GLBL = 1'bz;

    assign (strong1, weak0) GSR = GSR_int;
    assign (strong1, weak0) GTS = GTS_int;
    assign (weak1, weak0) PRLD = PRLD_int;
    assign (strong1, weak0) GRESTORE = GRESTORE_int;

    initial begin
	GSR_int = 1'b1;
	PRLD_int = 1'b1;
	#(ROC_WIDTH)
	GSR_int = 1'b0;
	PRLD_int = 1'b0;
    end

    initial begin
	GTS_int = 1'b1;
	#(TOC_WIDTH)
	GTS_int = 1'b0;
    end

    initial begin 
	GRESTORE_int = 1'b0;
	#(GRES_START);
	GRESTORE_int = 1'b1;
	#(GRES_WIDTH);
	GRESTORE_int = 1'b0;
    end

endmodule
`endif
