hprd/z80-fpga-drop-in-replacement/Z80_Drop_In_2026/Z80_Drop_In_2026.cache/ip/2023.1/2/b/2b9264c0e7119477/blk_mem_gen_0_sim_netlist.vhdl

-- Copyright 1986-2022 Xilinx, Inc. All Rights Reserved.
-- Copyright 2022-2023 Advanced Micro Devices, Inc. All Rights Reserved.
-- --------------------------------------------------------------------------------
-- Tool Version: Vivado v.2023.1 (lin64) Build 3865809 Sun May  7 15:04:56 MDT 2023
-- Date        : Thu Feb 26 19:26:41 2026
-- Host        : ff1013d0903a running 64-bit Ubuntu 22.04.4 LTS
-- Command     : write_vhdl -force -mode funcsim -rename_top decalper_eb_ot_sdeen_pot_pi_dehcac_xnilix -prefix
--               decalper_eb_ot_sdeen_pot_pi_dehcac_xnilix_ blk_mem_gen_0_sim_netlist.vhdl
-- Design      : blk_mem_gen_0
-- Purpose     : This VHDL netlist is a functional simulation representation of the design and should not be modified or
--               synthesized. This netlist cannot be used for SDF annotated simulation.
-- Device      : xc7s50csga324-1
-- --------------------------------------------------------------------------------
`protect begin_protected
`protect version = 1
`protect encrypt_agent = "XILINX"
`protect encrypt_agent_info = "Xilinx Encryption Tool 2023.1"
`protect key_keyowner="Synopsys", key_keyname="SNPS-VCS-RSA-2", key_method="rsa"
`protect encoding = (enctype="BASE64", line_length=76, bytes=128)
`protect key_block
aMT3usC6uizzcwnzOCX4OsS16Ob+YxFcsGovFpFklbnaIaD1S0lVdxenTwHPp6ByIEi+ehwr6Rgg
z/3AlTheI5NFTM8ihiMA18/wmUxI7EbaftJACA1LykUKCuj5myy0T+DACuv3sGYIZS38TZTZnnBC
FGAlvTZmRWs+JzneH3o=

`protect key_keyowner="Aldec", key_keyname="ALDEC15_001", key_method="rsa"
`protect encoding = (enctype="BASE64", line_length=76, bytes=256)
`protect key_block
lR9ZerhYSAb39nzEkeYvhnwEs5t9y/+yTDf8KuoUtR1BGeHZq8pA/YxtjzQLtaOW1R1IQUb0FtSI
e3CYAb7WHYbIjcpw3vKHvW1SqcGn9CMGa556CYKmD2oF12Kow8xRaFvMSBUVxX7HsHxNWnRd+PU1
+C0YayU2KFIY/7Yl6cZ5luAzhw/6SW3PFYUIyyqWy5MCIXweHOwQR2IpQEdlDur5nluN7i7BeB+i
fxwwHh8TU/g7T4mhZFkiTuBKdLAtQOjxWxzqTMxgcuAjlTylY16FgMFOASdvvSbqBZJjbxMdVloU
rYjS8O/8rWktv8GXcaIdBJ2BRj01q7jsChsbwA==

`protect key_keyowner="Mentor Graphics Corporation", key_keyname="MGC-VELOCE-RSA", key_method="rsa"
`protect encoding = (enctype="BASE64", line_length=76, bytes=128)
`protect key_block
Qvl63GHz9mq2xOB7elt/vAQ7URLGdD1Lkcz7f3Wtw31dwjjjbP62Ny/Jr6OmBIheWlgejx38qxAT
TrHiiEyjKmGcnPn1Tn2n+cH4RAxCbOFnCI9n6+YsYMTe9JkplGhGGr39SkFgJz0I2IKpPsuqTjCj
rhf49TAryNMQeRpREJA=

`protect key_keyowner="Mentor Graphics Corporation", key_keyname="MGC-VERIF-SIM-RSA-2", key_method="rsa"
`protect encoding = (enctype="BASE64", line_length=76, bytes=256)
`protect key_block
MA+9Ro+dh339m0iZrkKbqTKN8gQ5xkxN/SPCfhkOn+5jjgCTS5IOKLHil+HsZDjX333ebxnornwG
MOBxyEdFfLM8SA+bs2r41J/j0af2VVMmCM3hOh8JmZxB4X9Jg/glegNCbvwzqxMbOQNEy+zt7j5t
TFVD82RtPFmYVVYZZyll/WvAA+0aVpyjzLCIM1GznFky0RWLv65Wp4MJJnNRRrtG3muMznVO/u2s
tACsJ9jzv9M0IlMYjYH9BixhG6cZX02I4LEXXaPkhdOINlMMhsbArXtc9NphzmS4bY1/1yF1D6YD
EKLyS2Sr3HDl0O/lefN+jvfG8iKuVl55PNNrVQ==

`protect key_keyowner="Real Intent", key_keyname="RI-RSA-KEY-1", key_method="rsa"
`protect encoding = (enctype="BASE64", line_length=76, bytes=256)
`protect key_block
wpMTg7STjFkUDhOqdNPa0FHXTnHQgKmhvqDv+rRVBvMiQ8O7u8oj7ibITq3o+jugJsMJ60B410gQ
JFTcqCJKYmYJvqi8rPLLOYDmFG6ZLP/Ixr3n62IyIaCeDltBahi3yV009QN0X+iuzuFCL+Y7g9ff
IvAgyBly+Z3Itv2H9EJMZPMl17Sa7IkgjmWqzVXIKNMKn0iDVYsQw6ZgzQDYQ8N8IvTIEggU3/lh
6Nf0hV0ev3qOv/2P+4w0U766Ux3yLuzPJSI7bKm3/ip9NjhOytxOiKKqVXhKG8dzbbuS5u3EE/eq
q6YxkL7gpvNltVqqBnJB6vHSyWrD6+MqsCtR9A==

`protect key_keyowner="Xilinx", key_keyname="xilinxt_2022_10", key_method="rsa"
`protect encoding = (enctype="BASE64", line_length=76, bytes=256)
`protect key_block
Q7Q4SSp70lxFryaopuic9VVP/Ire0pSsPEIMYdURBAczC7ShkuYeV02U7L3BlAiyBE4vBKcwYSQd
cWiaj8sVP7q4kxoRHKxLV1R5PIO6l4DsLWE2E+1MLyUPME0w5KTular/oX8EPCJ5n/8VCtW7x4Vf
dpeyki1/IAPJkAyi3zVZKHzgKhEwnZaZZtZYuMWoPZMt4V38sAcE42Raf+7yfFWG5HO74JY6iEnW
gJeRk58K+avB/XLF2/j2RQZfjTYizrprT2tUMBK6e7DRWZZtk8AOcsMhUikev44IFGNbNXjP8BXC
0J3y3P7pCFT6l+saU83nRwi/H25fSA34diJtNw==

`protect key_keyowner="Metrics Technologies Inc.", key_keyname="DSim", key_method="rsa"
`protect encoding = (enctype="BASE64", line_length=76, bytes=256)
`protect key_block
a/8ooC+s+6nfvfa1+oBhsvYWLJjFgp83DI1kNyOi5Am+ugPbGRmgGZudfyo6yw6Yd5gGbLm5aToQ
5G4cGF5HaXD5TU6A0ZZFMTIbzFLE76JMjjIxX8JcaJIZpSmrXqlru8l5gDINUEAmwUY3mRQnjcGJ
0Z+kMRH8iAEF+gEviPiFZSBbJeOPqivIS217kimQJX3BeNbNPQTP+GUidcRywpGMh5avxtA0kDRO
F9SoCSyTm9hr2v9hsK1IUAYQLb7n2/R+z5YNKNzt1oN4qgJH1wZfdI8if2K8+ohyOdnxrrgJOWdj
cOqr7cGqEOYfBMTIQeHVZzb7NGWVN+9B8XSUaQ==

`protect key_keyowner="Atrenta", key_keyname="ATR-SG-RSA-1", key_method="rsa"
`protect encoding = (enctype="BASE64", line_length=76, bytes=384)
`protect key_block
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

`protect key_keyowner="Cadence Design Systems.", key_keyname="CDS_RSA_KEY_VER_1", key_method="rsa"
`protect encoding = (enctype="BASE64", line_length=76, bytes=256)
`protect key_block
fphquQOeFuqByo36Gh2C1zEC1J6u9swSMbMzsKldIvLm+SZ6/hr/N8KJ/G2vBABzX6UtbVuP1ZXx
AxdftP4Aqis1B3Bs6989aQG9eo0SOHA7r6aFLtFb3qoD5Pvqw4aVNU4z4EtTpFpn/jCWD21lKROf
q5X32HRfFq1jwqod+9vIbUNRRzz5y9VHvXfacZlxDazSPmcCF4hxB1KqWqT44KmYVkDedgkgnYgb
ZGidHnTb3W7C8tSqC9ac4kNJCL429QndtddweESJNlpX+65pt9Irok9pkOodwoj0QScswOIFjhBZ
/GrzZLQcFWiD3gXRU4DazzxQnGdRH4qEIRWziw==

`protect key_keyowner="Synplicity", key_keyname="SYNP15_1", key_method="rsa"
`protect encoding = (enctype="BASE64", line_length=76, bytes=256)
`protect key_block
1lUYYHPCt1BUJOvcBbgMU2GSQiqfxItz4ntieMaenjrtsE9SLwaU6xB0tBl8Atw5yP/RRNww1kX/
9uZbTz5He3r9mPVt+mGxB4N3f9BbCrQRb4USVPgKO/+vWUfMQERGklScy0+fz75WuxH74CjRUoDI
8iyssb2cUNnfDe13jIoI8gM1w4w/Pkxkmb6Mef53QMxacHAWEZeytcH3fuL/adO263D8P90U3XJv
vBXJmbjkRVi9qzjBzfMxuOy2KbZaZgR3BLzaffIfFnMwg/Rb8sGls5pQsZv5jL2wk3+Bj3OXBYdd
pDyjGoalJBzObKzd/t15kNHwY4FXYFcZLQPncw==

`protect key_keyowner="Mentor Graphics Corporation", key_keyname="MGC-PREC-RSA", key_method="rsa"
`protect encoding = (enctype="BASE64", line_length=76, bytes=256)
`protect key_block
YRmSEzaa2WFVvMH1BwWc1TIUpVbzSEIP0VbI6n0sEgct/X4PiTfMQmK1jBVCaISIzwBxscKQwZOt
mb/nmINGg6I7ih39LSbBMtx6cdCUiyaLkPeRbqfyPpKhvnUIFmdKVvTd1dYzxeOeuDnhSVaBaAcN
3lngSg7lIbmhLIGjC29yQrBTiLArbVZi6IRGronMK51e3UrYa6GspsznhiuRcXjEb4bHKrJ2CM5Z
BUwA+E9949sQgyOagFZbLVle2ESbwBaoxcAPn2gxfRHlT0leqyLgUGDZLsfArzGzw9BTGzyEG2TR
XOrKFNYRfMXMrnGsBM7acIelY4LdAMgsKgDH/A==

`protect data_method = "AES128-CBC"
`protect encoding = (enctype = "BASE64", line_length = 76, bytes = 33648)
`protect data_block
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
CtxRFUiuNXGRhxwBCOGjDvU3
`protect end_protected
library IEEE;
use IEEE.STD_LOGIC_1164.ALL;
library UNISIM;
use UNISIM.VCOMPONENTS.ALL;
entity decalper_eb_ot_sdeen_pot_pi_dehcac_xnilix is
  port (
    clka : in STD_LOGIC;
    ena : in STD_LOGIC;
    wea : in STD_LOGIC_VECTOR ( 0 to 0 );
    addra : in STD_LOGIC_VECTOR ( 7 downto 0 );
    dina : in STD_LOGIC_VECTOR ( 7 downto 0 );
    douta : out STD_LOGIC_VECTOR ( 7 downto 0 )
  );
  attribute NotValidForBitStream : boolean;
  attribute NotValidForBitStream of decalper_eb_ot_sdeen_pot_pi_dehcac_xnilix : entity is true;
  attribute CHECK_LICENSE_TYPE : string;
  attribute CHECK_LICENSE_TYPE of decalper_eb_ot_sdeen_pot_pi_dehcac_xnilix : entity is "blk_mem_gen_0,blk_mem_gen_v8_4_6,{}";
  attribute downgradeipidentifiedwarnings : string;
  attribute downgradeipidentifiedwarnings of decalper_eb_ot_sdeen_pot_pi_dehcac_xnilix : entity is "yes";
  attribute x_core_info : string;
  attribute x_core_info of decalper_eb_ot_sdeen_pot_pi_dehcac_xnilix : entity is "blk_mem_gen_v8_4_6,Vivado 2023.1";
end decalper_eb_ot_sdeen_pot_pi_dehcac_xnilix;

architecture STRUCTURE of decalper_eb_ot_sdeen_pot_pi_dehcac_xnilix is
  signal NLW_U0_dbiterr_UNCONNECTED : STD_LOGIC;
  signal NLW_U0_rsta_busy_UNCONNECTED : STD_LOGIC;
  signal NLW_U0_rstb_busy_UNCONNECTED : STD_LOGIC;
  signal NLW_U0_s_axi_arready_UNCONNECTED : STD_LOGIC;
  signal NLW_U0_s_axi_awready_UNCONNECTED : STD_LOGIC;
  signal NLW_U0_s_axi_bvalid_UNCONNECTED : STD_LOGIC;
  signal NLW_U0_s_axi_dbiterr_UNCONNECTED : STD_LOGIC;
  signal NLW_U0_s_axi_rlast_UNCONNECTED : STD_LOGIC;
  signal NLW_U0_s_axi_rvalid_UNCONNECTED : STD_LOGIC;
  signal NLW_U0_s_axi_sbiterr_UNCONNECTED : STD_LOGIC;
  signal NLW_U0_s_axi_wready_UNCONNECTED : STD_LOGIC;
  signal NLW_U0_sbiterr_UNCONNECTED : STD_LOGIC;
  signal NLW_U0_doutb_UNCONNECTED : STD_LOGIC_VECTOR ( 7 downto 0 );
  signal NLW_U0_rdaddrecc_UNCONNECTED : STD_LOGIC_VECTOR ( 7 downto 0 );
  signal NLW_U0_s_axi_bid_UNCONNECTED : STD_LOGIC_VECTOR ( 3 downto 0 );
  signal NLW_U0_s_axi_bresp_UNCONNECTED : STD_LOGIC_VECTOR ( 1 downto 0 );
  signal NLW_U0_s_axi_rdaddrecc_UNCONNECTED : STD_LOGIC_VECTOR ( 7 downto 0 );
  signal NLW_U0_s_axi_rdata_UNCONNECTED : STD_LOGIC_VECTOR ( 7 downto 0 );
  signal NLW_U0_s_axi_rid_UNCONNECTED : STD_LOGIC_VECTOR ( 3 downto 0 );
  signal NLW_U0_s_axi_rresp_UNCONNECTED : STD_LOGIC_VECTOR ( 1 downto 0 );
  attribute C_ADDRA_WIDTH : integer;
  attribute C_ADDRA_WIDTH of U0 : label is 8;
  attribute C_ADDRB_WIDTH : integer;
  attribute C_ADDRB_WIDTH of U0 : label is 8;
  attribute C_ALGORITHM : integer;
  attribute C_ALGORITHM of U0 : label is 1;
  attribute C_AXI_ID_WIDTH : integer;
  attribute C_AXI_ID_WIDTH of U0 : label is 4;
  attribute C_AXI_SLAVE_TYPE : integer;
  attribute C_AXI_SLAVE_TYPE of U0 : label is 0;
  attribute C_AXI_TYPE : integer;
  attribute C_AXI_TYPE of U0 : label is 1;
  attribute C_BYTE_SIZE : integer;
  attribute C_BYTE_SIZE of U0 : label is 9;
  attribute C_COMMON_CLK : integer;
  attribute C_COMMON_CLK of U0 : label is 0;
  attribute C_COUNT_18K_BRAM : string;
  attribute C_COUNT_18K_BRAM of U0 : label is "1";
  attribute C_COUNT_36K_BRAM : string;
  attribute C_COUNT_36K_BRAM of U0 : label is "0";
  attribute C_CTRL_ECC_ALGO : string;
  attribute C_CTRL_ECC_ALGO of U0 : label is "NONE";
  attribute C_DEFAULT_DATA : string;
  attribute C_DEFAULT_DATA of U0 : label is "0";
  attribute C_DISABLE_WARN_BHV_COLL : integer;
  attribute C_DISABLE_WARN_BHV_COLL of U0 : label is 0;
  attribute C_DISABLE_WARN_BHV_RANGE : integer;
  attribute C_DISABLE_WARN_BHV_RANGE of U0 : label is 0;
  attribute C_ELABORATION_DIR : string;
  attribute C_ELABORATION_DIR of U0 : label is "./";
  attribute C_ENABLE_32BIT_ADDRESS : integer;
  attribute C_ENABLE_32BIT_ADDRESS of U0 : label is 0;
  attribute C_EN_DEEPSLEEP_PIN : integer;
  attribute C_EN_DEEPSLEEP_PIN of U0 : label is 0;
  attribute C_EN_ECC_PIPE : integer;
  attribute C_EN_ECC_PIPE of U0 : label is 0;
  attribute C_EN_RDADDRA_CHG : integer;
  attribute C_EN_RDADDRA_CHG of U0 : label is 0;
  attribute C_EN_RDADDRB_CHG : integer;
  attribute C_EN_RDADDRB_CHG of U0 : label is 0;
  attribute C_EN_SAFETY_CKT : integer;
  attribute C_EN_SAFETY_CKT of U0 : label is 0;
  attribute C_EN_SHUTDOWN_PIN : integer;
  attribute C_EN_SHUTDOWN_PIN of U0 : label is 0;
  attribute C_EN_SLEEP_PIN : integer;
  attribute C_EN_SLEEP_PIN of U0 : label is 0;
  attribute C_EST_POWER_SUMMARY : string;
  attribute C_EST_POWER_SUMMARY of U0 : label is "Estimated Power for IP     :     2.3883 mW";
  attribute C_FAMILY : string;
  attribute C_FAMILY of U0 : label is "spartan7";
  attribute C_HAS_AXI_ID : integer;
  attribute C_HAS_AXI_ID of U0 : label is 0;
  attribute C_HAS_ENA : integer;
  attribute C_HAS_ENA of U0 : label is 1;
  attribute C_HAS_ENB : integer;
  attribute C_HAS_ENB of U0 : label is 0;
  attribute C_HAS_INJECTERR : integer;
  attribute C_HAS_INJECTERR of U0 : label is 0;
  attribute C_HAS_MEM_OUTPUT_REGS_A : integer;
  attribute C_HAS_MEM_OUTPUT_REGS_A of U0 : label is 0;
  attribute C_HAS_MEM_OUTPUT_REGS_B : integer;
  attribute C_HAS_MEM_OUTPUT_REGS_B of U0 : label is 0;
  attribute C_HAS_MUX_OUTPUT_REGS_A : integer;
  attribute C_HAS_MUX_OUTPUT_REGS_A of U0 : label is 0;
  attribute C_HAS_MUX_OUTPUT_REGS_B : integer;
  attribute C_HAS_MUX_OUTPUT_REGS_B of U0 : label is 0;
  attribute C_HAS_REGCEA : integer;
  attribute C_HAS_REGCEA of U0 : label is 0;
  attribute C_HAS_REGCEB : integer;
  attribute C_HAS_REGCEB of U0 : label is 0;
  attribute C_HAS_RSTA : integer;
  attribute C_HAS_RSTA of U0 : label is 0;
  attribute C_HAS_RSTB : integer;
  attribute C_HAS_RSTB of U0 : label is 0;
  attribute C_HAS_SOFTECC_INPUT_REGS_A : integer;
  attribute C_HAS_SOFTECC_INPUT_REGS_A of U0 : label is 0;
  attribute C_HAS_SOFTECC_OUTPUT_REGS_B : integer;
  attribute C_HAS_SOFTECC_OUTPUT_REGS_B of U0 : label is 0;
  attribute C_INITA_VAL : string;
  attribute C_INITA_VAL of U0 : label is "0";
  attribute C_INITB_VAL : string;
  attribute C_INITB_VAL of U0 : label is "0";
  attribute C_INIT_FILE : string;
  attribute C_INIT_FILE of U0 : label is "blk_mem_gen_0.mem";
  attribute C_INIT_FILE_NAME : string;
  attribute C_INIT_FILE_NAME of U0 : label is "blk_mem_gen_0.mif";
  attribute C_INTERFACE_TYPE : integer;
  attribute C_INTERFACE_TYPE of U0 : label is 0;
  attribute C_LOAD_INIT_FILE : integer;
  attribute C_LOAD_INIT_FILE of U0 : label is 1;
  attribute C_MEM_TYPE : integer;
  attribute C_MEM_TYPE of U0 : label is 0;
  attribute C_MUX_PIPELINE_STAGES : integer;
  attribute C_MUX_PIPELINE_STAGES of U0 : label is 0;
  attribute C_PRIM_TYPE : integer;
  attribute C_PRIM_TYPE of U0 : label is 1;
  attribute C_READ_DEPTH_A : integer;
  attribute C_READ_DEPTH_A of U0 : label is 256;
  attribute C_READ_DEPTH_B : integer;
  attribute C_READ_DEPTH_B of U0 : label is 256;
  attribute C_READ_LATENCY_A : integer;
  attribute C_READ_LATENCY_A of U0 : label is 1;
  attribute C_READ_LATENCY_B : integer;
  attribute C_READ_LATENCY_B of U0 : label is 1;
  attribute C_READ_WIDTH_A : integer;
  attribute C_READ_WIDTH_A of U0 : label is 8;
  attribute C_READ_WIDTH_B : integer;
  attribute C_READ_WIDTH_B of U0 : label is 8;
  attribute C_RSTRAM_A : integer;
  attribute C_RSTRAM_A of U0 : label is 0;
  attribute C_RSTRAM_B : integer;
  attribute C_RSTRAM_B of U0 : label is 0;
  attribute C_RST_PRIORITY_A : string;
  attribute C_RST_PRIORITY_A of U0 : label is "CE";
  attribute C_RST_PRIORITY_B : string;
  attribute C_RST_PRIORITY_B of U0 : label is "CE";
  attribute C_SIM_COLLISION_CHECK : string;
  attribute C_SIM_COLLISION_CHECK of U0 : label is "ALL";
  attribute C_USE_BRAM_BLOCK : integer;
  attribute C_USE_BRAM_BLOCK of U0 : label is 0;
  attribute C_USE_BYTE_WEA : integer;
  attribute C_USE_BYTE_WEA of U0 : label is 0;
  attribute C_USE_BYTE_WEB : integer;
  attribute C_USE_BYTE_WEB of U0 : label is 0;
  attribute C_USE_DEFAULT_DATA : integer;
  attribute C_USE_DEFAULT_DATA of U0 : label is 1;
  attribute C_USE_ECC : integer;
  attribute C_USE_ECC of U0 : label is 0;
  attribute C_USE_SOFTECC : integer;
  attribute C_USE_SOFTECC of U0 : label is 0;
  attribute C_USE_URAM : integer;
  attribute C_USE_URAM of U0 : label is 0;
  attribute C_WEA_WIDTH : integer;
  attribute C_WEA_WIDTH of U0 : label is 1;
  attribute C_WEB_WIDTH : integer;
  attribute C_WEB_WIDTH of U0 : label is 1;
  attribute C_WRITE_DEPTH_A : integer;
  attribute C_WRITE_DEPTH_A of U0 : label is 256;
  attribute C_WRITE_DEPTH_B : integer;
  attribute C_WRITE_DEPTH_B of U0 : label is 256;
  attribute C_WRITE_MODE_A : string;
  attribute C_WRITE_MODE_A of U0 : label is "NO_CHANGE";
  attribute C_WRITE_MODE_B : string;
  attribute C_WRITE_MODE_B of U0 : label is "WRITE_FIRST";
  attribute C_WRITE_WIDTH_A : integer;
  attribute C_WRITE_WIDTH_A of U0 : label is 8;
  attribute C_WRITE_WIDTH_B : integer;
  attribute C_WRITE_WIDTH_B of U0 : label is 8;
  attribute C_XDEVICEFAMILY : string;
  attribute C_XDEVICEFAMILY of U0 : label is "spartan7";
  attribute downgradeipidentifiedwarnings of U0 : label is "yes";
  attribute is_du_within_envelope : string;
  attribute is_du_within_envelope of U0 : label is "true";
  attribute x_interface_info : string;
  attribute x_interface_info of clka : signal is "xilinx.com:interface:bram:1.0 BRAM_PORTA CLK";
  attribute x_interface_parameter : string;
  attribute x_interface_parameter of clka : signal is "XIL_INTERFACENAME BRAM_PORTA, MEM_SIZE 8192, MEM_WIDTH 32, MEM_ECC NONE, MASTER_TYPE OTHER, READ_LATENCY 1";
  attribute x_interface_info of ena : signal is "xilinx.com:interface:bram:1.0 BRAM_PORTA EN";
  attribute x_interface_info of addra : signal is "xilinx.com:interface:bram:1.0 BRAM_PORTA ADDR";
  attribute x_interface_info of dina : signal is "xilinx.com:interface:bram:1.0 BRAM_PORTA DIN";
  attribute x_interface_info of douta : signal is "xilinx.com:interface:bram:1.0 BRAM_PORTA DOUT";
  attribute x_interface_info of wea : signal is "xilinx.com:interface:bram:1.0 BRAM_PORTA WE";
begin
U0: entity work.decalper_eb_ot_sdeen_pot_pi_dehcac_xnilix_blk_mem_gen_v8_4_6
     port map (
      addra(7 downto 0) => addra(7 downto 0),
      addrb(7 downto 0) => B"00000000",
      clka => clka,
      clkb => '0',
      dbiterr => NLW_U0_dbiterr_UNCONNECTED,
      deepsleep => '0',
      dina(7 downto 0) => dina(7 downto 0),
      dinb(7 downto 0) => B"00000000",
      douta(7 downto 0) => douta(7 downto 0),
      doutb(7 downto 0) => NLW_U0_doutb_UNCONNECTED(7 downto 0),
      eccpipece => '0',
      ena => ena,
      enb => '0',
      injectdbiterr => '0',
      injectsbiterr => '0',
      rdaddrecc(7 downto 0) => NLW_U0_rdaddrecc_UNCONNECTED(7 downto 0),
      regcea => '0',
      regceb => '0',
      rsta => '0',
      rsta_busy => NLW_U0_rsta_busy_UNCONNECTED,
      rstb => '0',
      rstb_busy => NLW_U0_rstb_busy_UNCONNECTED,
      s_aclk => '0',
      s_aresetn => '0',
      s_axi_araddr(31 downto 0) => B"00000000000000000000000000000000",
      s_axi_arburst(1 downto 0) => B"00",
      s_axi_arid(3 downto 0) => B"0000",
      s_axi_arlen(7 downto 0) => B"00000000",
      s_axi_arready => NLW_U0_s_axi_arready_UNCONNECTED,
      s_axi_arsize(2 downto 0) => B"000",
      s_axi_arvalid => '0',
      s_axi_awaddr(31 downto 0) => B"00000000000000000000000000000000",
      s_axi_awburst(1 downto 0) => B"00",
      s_axi_awid(3 downto 0) => B"0000",
      s_axi_awlen(7 downto 0) => B"00000000",
      s_axi_awready => NLW_U0_s_axi_awready_UNCONNECTED,
      s_axi_awsize(2 downto 0) => B"000",
      s_axi_awvalid => '0',
      s_axi_bid(3 downto 0) => NLW_U0_s_axi_bid_UNCONNECTED(3 downto 0),
      s_axi_bready => '0',
      s_axi_bresp(1 downto 0) => NLW_U0_s_axi_bresp_UNCONNECTED(1 downto 0),
      s_axi_bvalid => NLW_U0_s_axi_bvalid_UNCONNECTED,
      s_axi_dbiterr => NLW_U0_s_axi_dbiterr_UNCONNECTED,
      s_axi_injectdbiterr => '0',
      s_axi_injectsbiterr => '0',
      s_axi_rdaddrecc(7 downto 0) => NLW_U0_s_axi_rdaddrecc_UNCONNECTED(7 downto 0),
      s_axi_rdata(7 downto 0) => NLW_U0_s_axi_rdata_UNCONNECTED(7 downto 0),
      s_axi_rid(3 downto 0) => NLW_U0_s_axi_rid_UNCONNECTED(3 downto 0),
      s_axi_rlast => NLW_U0_s_axi_rlast_UNCONNECTED,
      s_axi_rready => '0',
      s_axi_rresp(1 downto 0) => NLW_U0_s_axi_rresp_UNCONNECTED(1 downto 0),
      s_axi_rvalid => NLW_U0_s_axi_rvalid_UNCONNECTED,
      s_axi_sbiterr => NLW_U0_s_axi_sbiterr_UNCONNECTED,
      s_axi_wdata(7 downto 0) => B"00000000",
      s_axi_wlast => '0',
      s_axi_wready => NLW_U0_s_axi_wready_UNCONNECTED,
      s_axi_wstrb(0) => '0',
      s_axi_wvalid => '0',
      sbiterr => NLW_U0_sbiterr_UNCONNECTED,
      shutdown => '0',
      sleep => '0',
      wea(0) => wea(0),
      web(0) => '0'
    );
end STRUCTURE;
