hprd/z80-fpga-drop-in-replacement/(commit log)

2026-02-06 hardware push
    [416131160803.stp, EVQ-P2R02W.stp, LTC3569EUDC#TRPBF.stp, MT25QL512ABB1EW9-0SIT.stp, TC2030-IDC-NL.step, XC7S25-2CSGA225I.stp, computer_breakout.kicad_pcb, computer_breakout.kicad_sch]
2026-02-12 changed PCB to include FlipFlop
    [level-shifter.kicad_pcb, level-shifter.kicad_sch]
2026-02-23 added assembler and assembly files
2026-02-24 fixed OUT D and M1_b
    [xsimSettings.ini, z80_top.v]
2026-03-04 added tester board files
    [Tester.kicad_pcb, Tester.kicad_sch, level-shifter.kicad_sch, untitled.kicad_sch]
2026-03-05 redoing clock for tester
    [ACH-4.000MHZ-EK.step, SN74LS14N.step, Tester.kicad_sch, level-shifter.kicad_pcb]
2026-03-06 pcb stuff
    [Tester.kicad_sch, untitled.kicad_sch]
2026-03-07 schematic done
    [B3F-4050.step, EDI2CAP.CFG, LCD-16X2.step, NHD-12864WG-BTMI-V#N.SchLib, NHD-12864WG-BTMI-V#N.stp, NHD12864WGBTMIVN.PcbLib, PJ-102A.step, Tester.kicad_pcb]
2026-03-07 Finalize schematic changes, added archive for sharing project
    [Tester.kicad_pcb, Tester.kicad_sch, untitled.kicad_sch]
2026-03-09 updated PCB to fix logic, ready to place and route
    [32pin_ZIF_3D.stp, 40pin_ZIF_3D.STEP, Potentiometer_3D.STEP, Tester.kicad_pcb, Tester.kicad_sch, untitled.kicad_sch]
2026-03-19 minor changes to pcb : labels for schematic
    [Tester.kicad_pcb, Tester.kicad_sch, untitled.kicad_sch]
2026-03-19 Cleared errors on schematic - superfluous enable signal
    [untitled.kicad_sch]
2026-03-20 Placed PCB awaiting review
    [Tester.kicad_pcb, Tester.kicad_sch, untitled.kicad_sch]
2026-03-23 Almost done routing
    [Tester.kicad_pcb, Tester.kicad_sch]
2026-03-27 PCB routed no errors
    [Tester.kicad_pcb]
2026-03-28 last silk screen labels added
    [Tester.kicad_pcb]
